mohanan02/Controller-Design-for-an-Autonomous-Vehicle-Hazard-Warning-and-Intent-Projection-System/PrototypeBoard/budgetlist.pdf

Manufacturer's Number | Description | Footprint | Supplier | Order Code | Qty | Price | MOQ | Status | Date Ordered | Line Total
1206 | SMT ADAPTERS 3 PACK 20SOIC/TSSOP | SMD to DIP | DigiKey | 1528-1066-ND | 1 | $8.34 | 1 | Received | | $8.34
13655 | SOIC TO DIP ADAPTER 8PIN 1=4 PCS | SMD to DIP | DigiKey | 1568-13655-ND | 2 | $6.95 | 1 | Received | | $13.90
FIT0193 | BREADBOARD GENERAL PURPOSE F | board | DigiKey | 1738-1005-ND | 5 | $5.84 | 1 | Received | | $29.20
SHUTTLE BOARD 3.0 BMI323 | SHUTTLE BOARD 3.0 BMI323 | module | DigiKey | 828-SHUTTLEBOARD3.0BMI323-ND | 1 | $29.43 | 1 | Received | | $29.43
2977 | DRV8825 STEPPER MTR DRVR CARR | module | DigiKey | 2183-2977-ND | 8 | $25.41 | 1 | Received | | $203.28
L6374FP | IC PWR DRIVER N-CHANNEL 1:1 20SO | SMD | DigiKey | 497-14769-5-ND | 2 | $18.33 | 1 | Received | | $36.66
ACPL-K64L-000E | OPTOISO 5KV 2CH PUSH PULL 8-SO | SMD | DigiKey | 516-2626-5-ND | 3 | $11.36 | 1 | Received | | $34.08
PHE840MA6100MA04R17 | CAP FILM 0.1UF 20% 760VDC RADIAL | through hole | DigiKey | 399-11469-ND | 15 | $0.92 | 1 | Received | | $13.80
B32529C0105J000 | CAP FILM 1UF 5% 63VDC RADIAL | through hole | DigiKey | 495-1119-ND | 7 | $1.07 | 1 | Received | | $7.49
R82DC3470SH60J | CAP FILM 0.47UF 5% 63VDC RADIAL | through hole | DigiKey | 399-11865-1-ND | 2 | $0.74 | 1 | Received | | $1.48
B32529C0473K000 | CAP FILM 0.047UF 10% 63VDC RAD | through hole | DigiKey | 495-2558-ND | 2 | $0.50 | 1 | Received | | $1.00
R82EC2100AA50J | CAP FILM 10000PF 5% 100VDC RAD | through hole | DigiKey | 399-5872-ND | 2 | $0.48 | 1 | Received | | $0.96
B32529C0102K000 | CAP FILM 1000PF 10% 63VDC RADIAL | through hole | DigiKey | 495-2456-ND | 2 | $0.50 | 1 | Received | | $1.00
MFR-25FRF52-1K | RES 1K OHM 1% 1/4W AXIAL | through hole | DigiKey | 13-MFR-25FRF52-1KTR-ND | 5 | $0.19 | 1 | Received | | $0.95
MFR-25FRF52-10K | 13-MFR-25FRF52-10KTR-ND | through hole | DigiKey | 13-MFR-25FRF52-10KTR-ND | 10 | $0.19 | 1 | Received | | $1.90
MFR-12FTF52-47K | RES 47K OHM 1% 1/6W AXIAL | through hole | DigiKey | 13-MFR-12FTF52-47KCT-ND | 6 | $0.19 | 1 | Received | | $1.14
C310T-SC-5-R-TR1 | FUSE CERAMIC 5A 250VAC AXIAL | through hole | DigiKey | 283-4691-2-ND | 10 | $0.57 | 1 | Received | | $5.70
TBP02R1W-381-03BE | TERM BLOCK HDR 3POS 3.81MM | through hole | DigiKey | 102-6514-ND | 5 | $1.22 | 1 | Received | | $6.10
TBP02P1W-381-03BE | TERM BLOCK PLUG 3POS 3.81MM | connector | DigiKey | 102-6505-ND | 5 | $1.80 | 1 | Received | | $9.00
25SH-B-04-TS | CONN HEADER VERT 4POS 2.5MM | connector | DigiKey | 2057-25SH-B-04-TS-ND | 8 | $0.19 | 1 | Received | | $1.52
25CH-B-04 | CONN RCPT HSG 4POS 2.50MM | connector | DigiKey | 2057-25CH-B-04-ND | 8 | $0.19 | 1 | Received | | $1.52
25CTB-R | CRIMP TERMINAL, 2.50MM TYPE B HC | connector | DigiKey | 2057-25CTB-RTR-ND | 32 | $0.19 | 1 | Received | | $6.08
530470610 | CONN HEADER VERT 6POS 1.25MM | connector | DigiKey | WM1735-ND | 9 | $0.70 | 1 | Received | | $6.30
B7P-VH-B | CONN HEADER VERT 7POS 3.96MM | connector | DigiKey | 455-B7P-VH-B-ND | 4 | $0.82 | 1 | Received | | $3.28
VHR-7N | CONN RCPT HSG 7POS 3.96MM | connector | DigiKey | 455-1181-ND | 4 | $0.41 | 1 | Received | | $1.64
SVH-41T-P1.1 | CONN SOCKET 16-20AWG CRIMP TIN | connector | DigiKey | 455-1319TR-ND | 18 | $0.09 | 1 | Received | | $1.62
ESDCAN03-2BWY | TVS DIODE 24VWM 41VC SOT3233 | SMD | DigiKey | 497-15846-2-ND | 4 | $0.95 | 1 | Received | | $3.80
TCAN3403DRQ1 | IC TRANSCEIVER HALF 1/1 8SOIC | SMD | DigiKey | 296-TCAN3403DRQ1TR-ND | 4 | $3.63 | 1 | Received | | $14.52
RNMF14FTC120R | RES 120 OHM 1% 1/4W AXIAL | through hole | DigiKey | S120CATR-ND | 5 | $0.19 | 1 | Received | | $0.95
DFR1015 | DC-DC MULTI-OUTPUT BUCK CONVERTER | buck converter | DigiKey | 1738-DFR1015-ND | 5 | $9.82 | 1 | Received | | $49.10
Total | | | | | | | | | | $495.74

## DigiKey Component Order List
