mohanan02/Controller-Design-for-an-Autonomous-Vehicle-Hazard-Warning-and-Intent-Projection-System/PrototypeBoard/20261010_202211.jpg

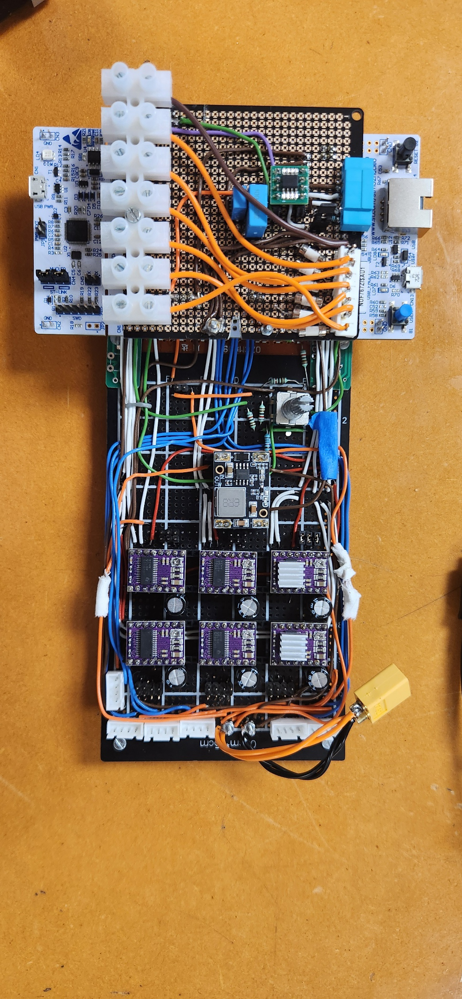
PrototypeBoard/20261010_202211.jpg
