mohanan02/Controller-Design-for-an-Autonomous-Vehicle-Hazard-Warning-and-Intent-Projection-System/PrototypeBoard/20261012_144138.jpg

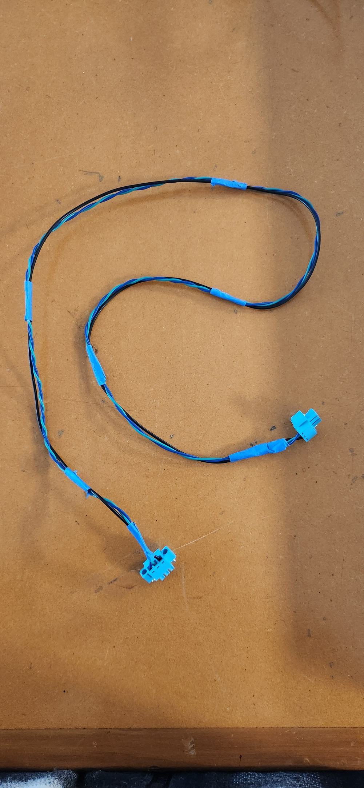
PrototypeBoard/20261012_144138.jpg
