mohanan02/Controller-Design-for-an-Autonomous-Vehicle-Hazard-Warning-and-Intent-Projection-System/PrototypeBoard/20261012_144315.jpg

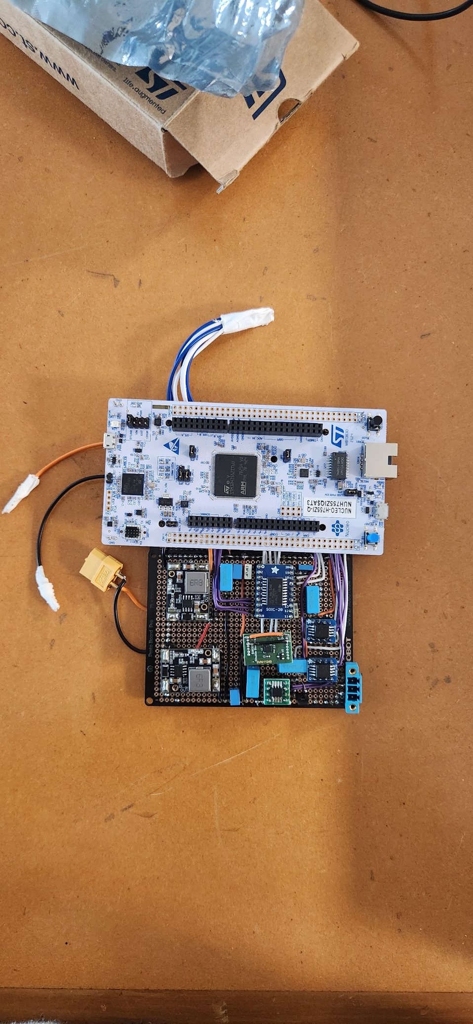
PrototypeBoard/20261012_144315.jpg
