mohanan02/Controller-Design-for-an-Autonomous-Vehicle-Hazard-Warning-and-Intent-Projection-System/SchematicPDF&ComponentList/MainController.pdf

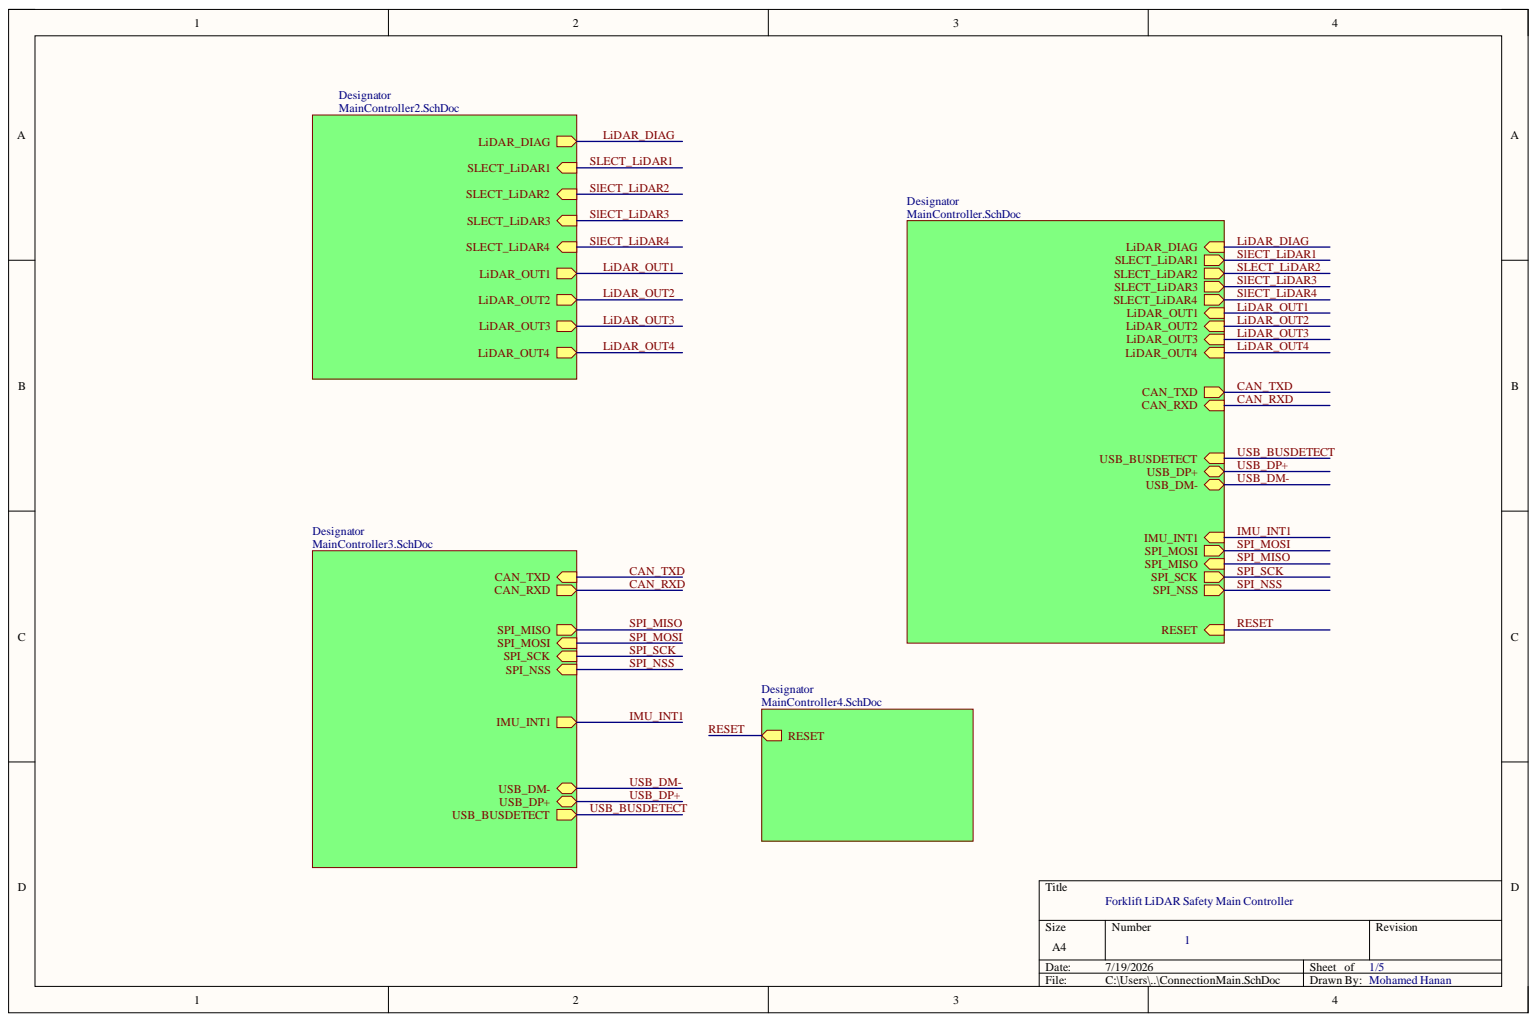
[picture p21: page 1]

Forklift LiDAR Safety Main Controller

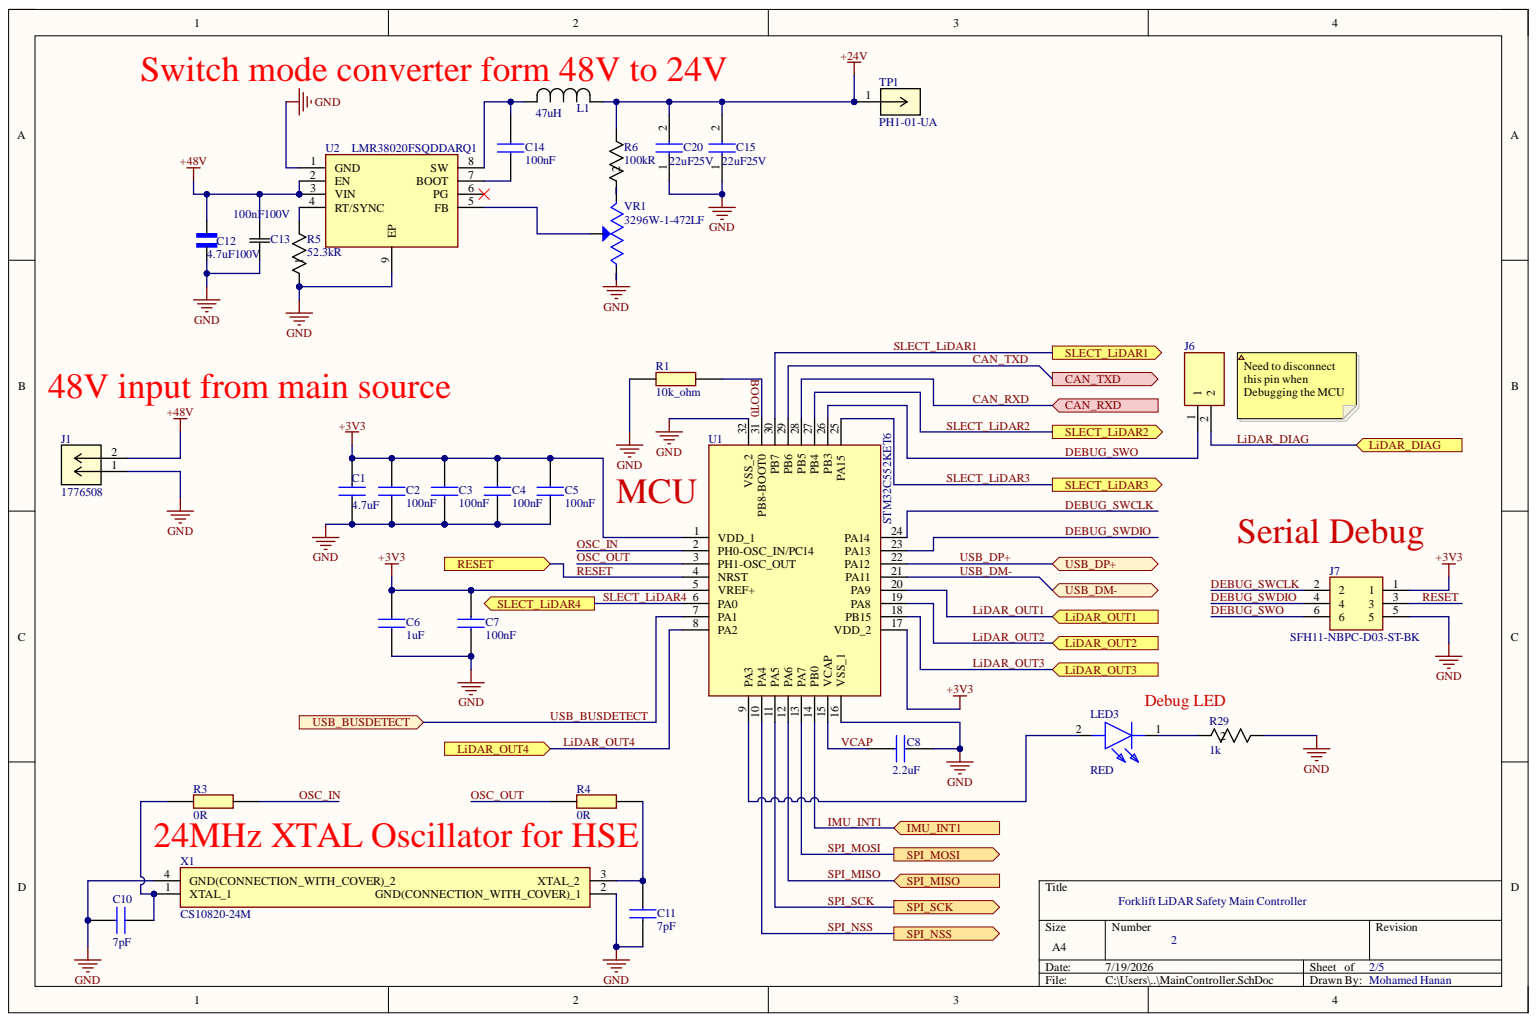
[picture p22: page 2]

Switch mode converter form 48V to 24V

48V input from main source

24MHz XTAL Oscillator for HSE

Forklift LiDAR Safety Main Controller

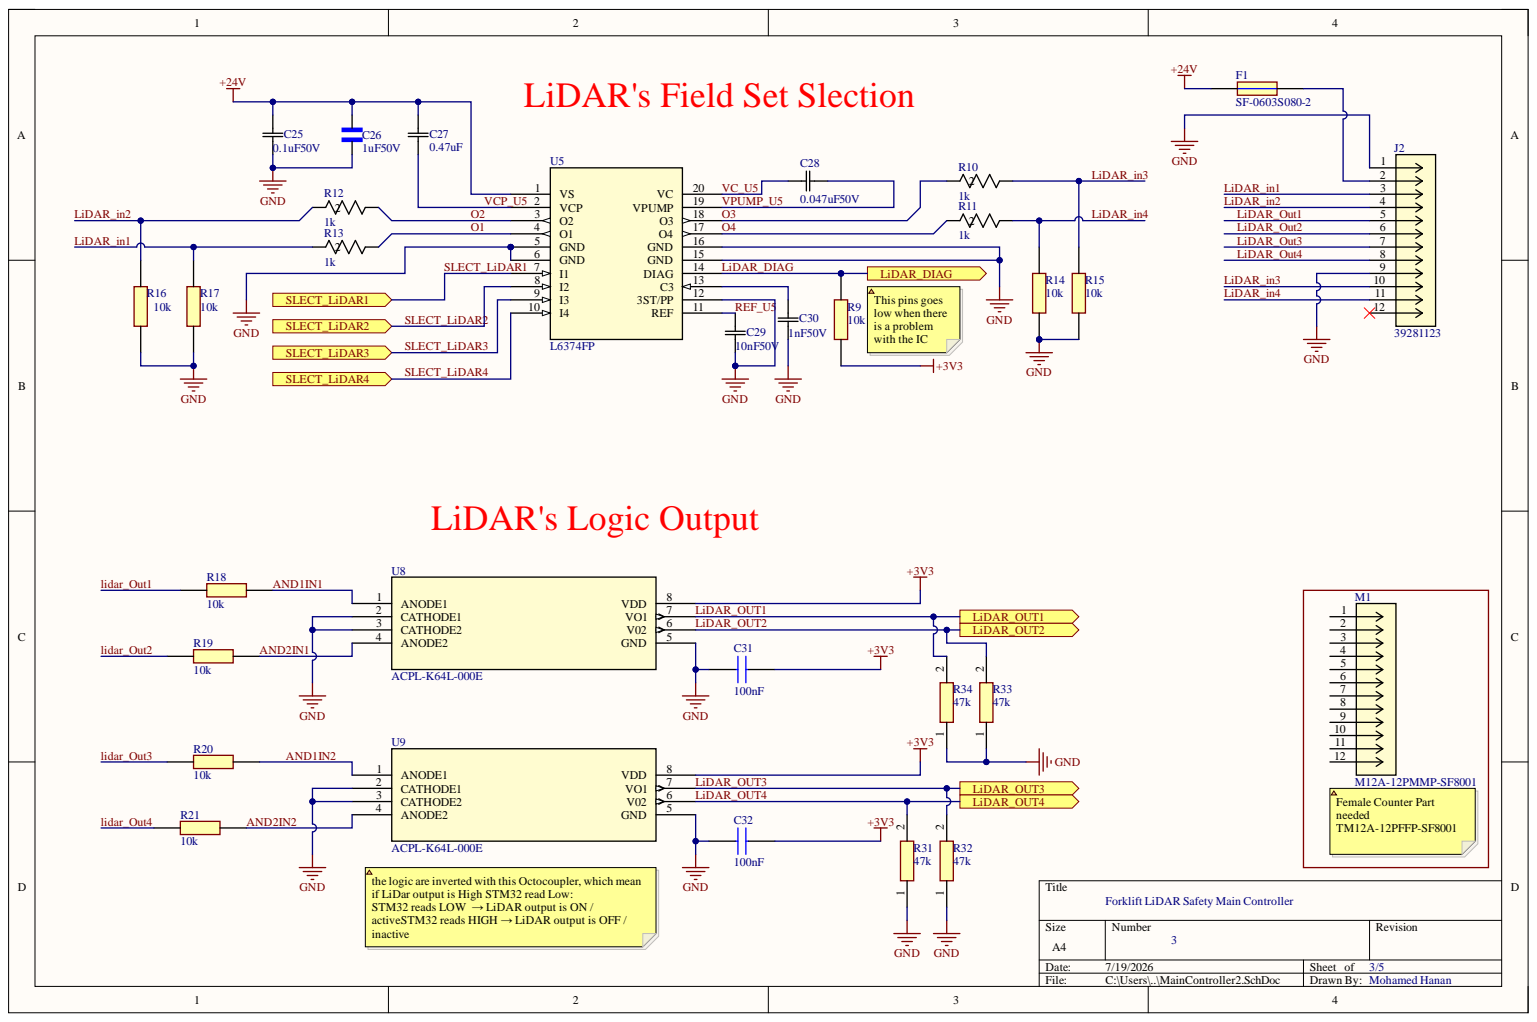
[picture p23: page 3]

LiDAR's Field Set Slection

2 1k SLECT_LiDAR1 | GND 6

I1 7 | | LiDAR_DIAG
I2 8
I3 9

REF_U5

SLECT_LiDAR2

CATHODE2 3

AND2IN1

AND2IN2

the logic are inverted with this Octocoupler, which mean
if LiDar output is High STM32 read Low:
STM32 reads LOW → LiDAR output is ON /
activeSTM32 reads HIGH → LiDAR output is OFF /
inactive

Forklift LiDAR Safety Main Controller

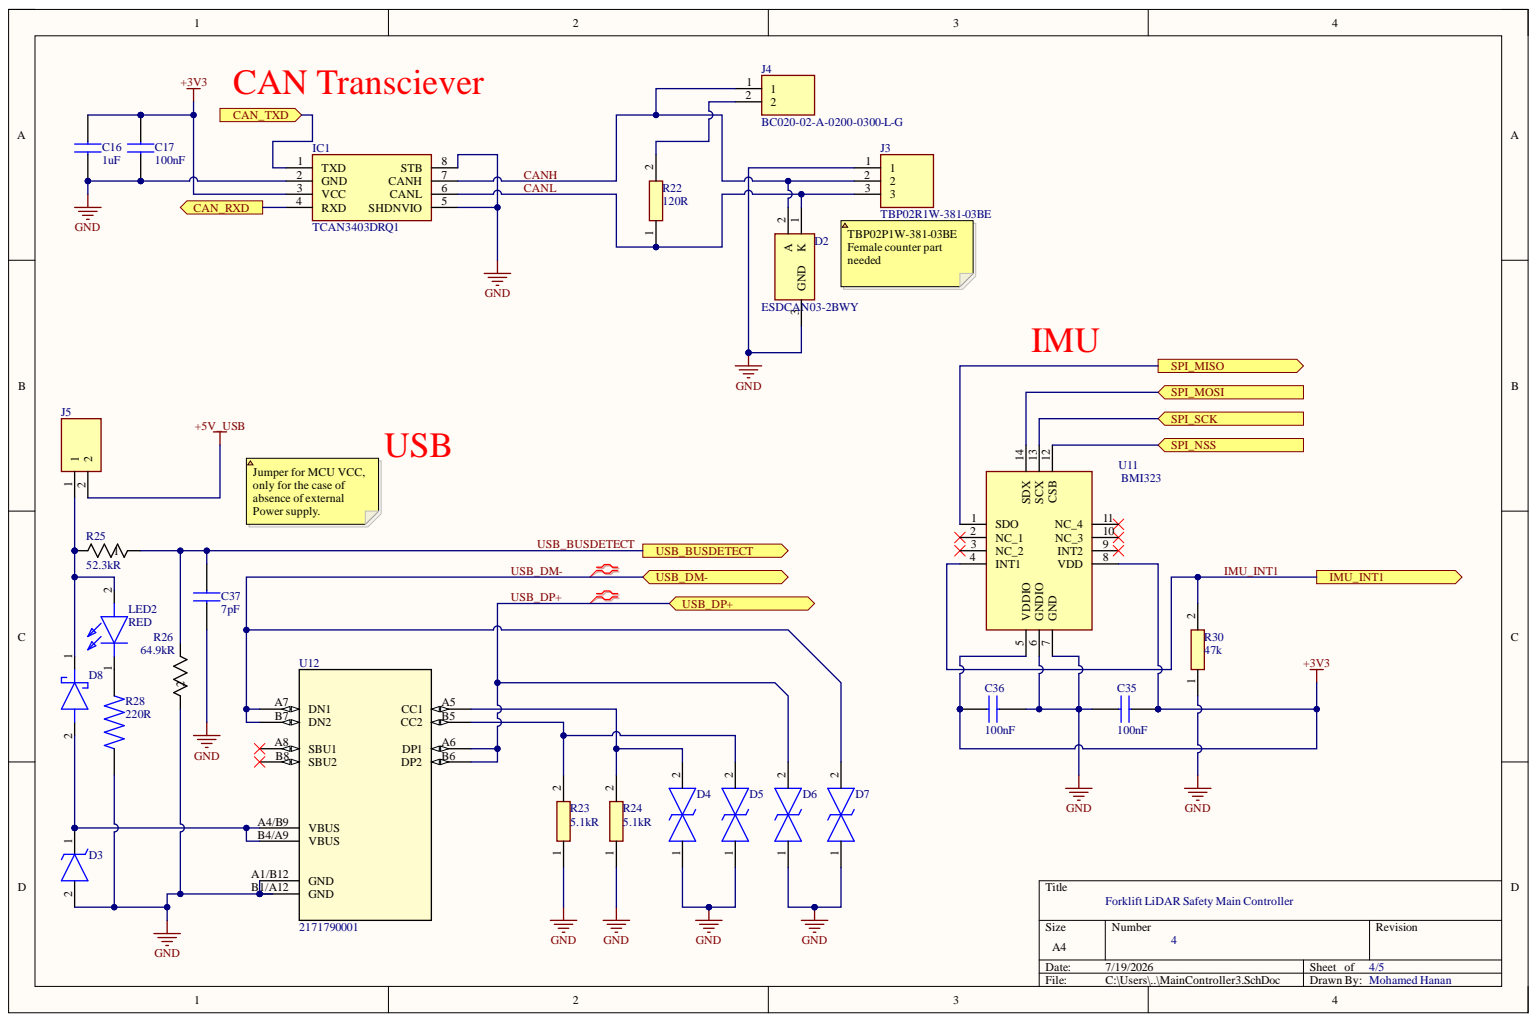
[picture p24: page 4]

Jumper for MCU VCC,
only for the case of
absence of external
Power supply.

Forklift LiDAR Safety Main Controller

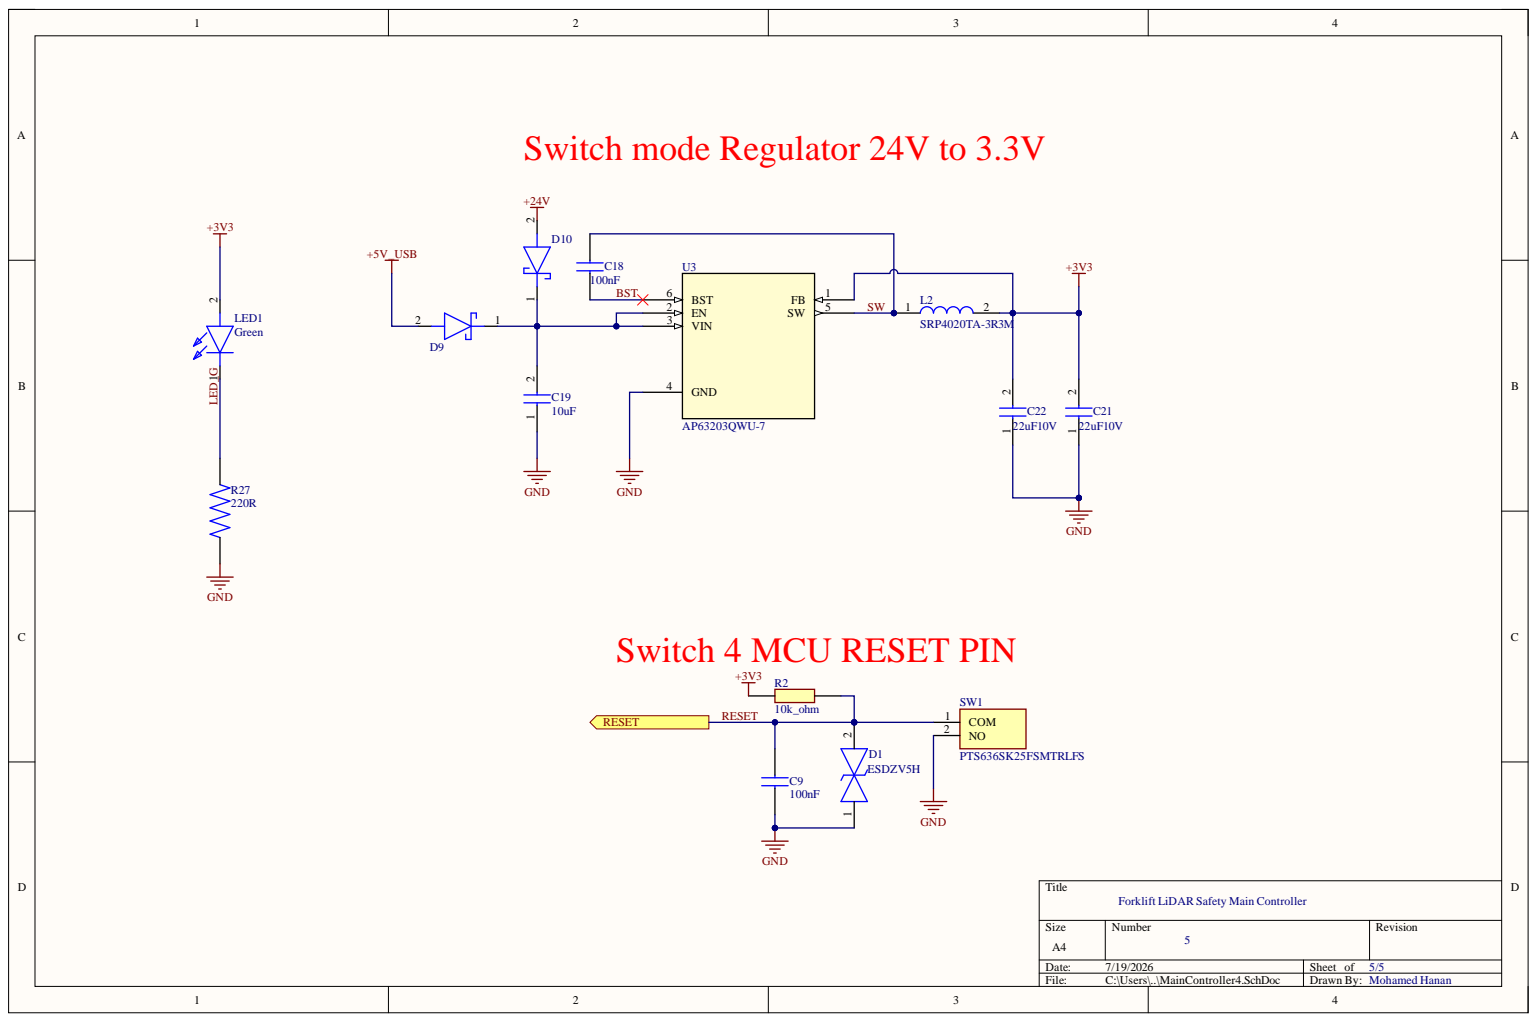
[picture p25: page 5]

Switch mode Regulator 24V to 3.3V

EN 2 | SW
VIN 3

Switch 4 MCU RESET PIN

Forklift LiDAR Safety Main Controller

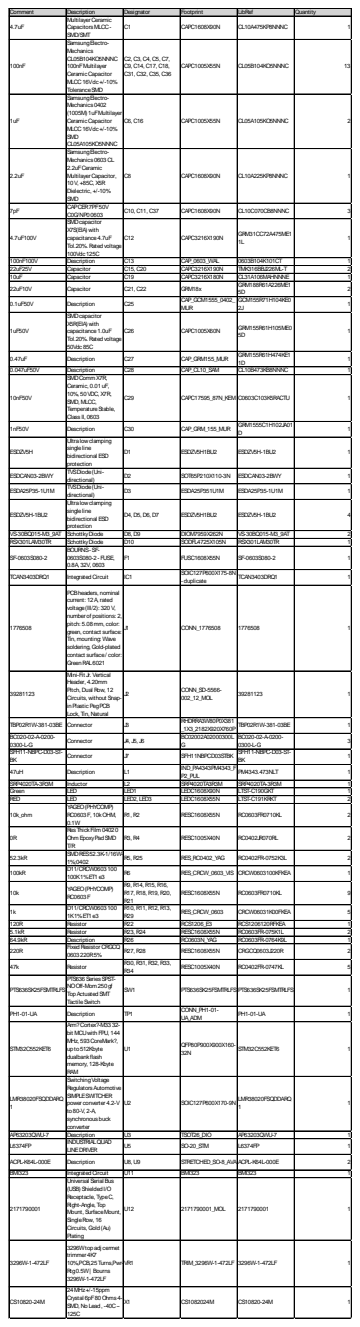
[picture p26: page 6]

100nF | SamsungElectro-Mechanics CL05B104KO5NNNC 100nFMultilayer Ceramic Capacitor MLCC16Vdc +/-10% ToleranceSMD | C2, C3, C4, C5, C7, C9, C14, C17, C18, C31, C32, C35, C36 | CAPC1005X55N | CL05B104KO5NNNC | 13

1uF | SamsungElectro-Mechanics0402 (1005M) 1uFMultilayer Ceramic Capacitor MLCC16Vdc +/-10% SMD CL05A105KO5NNNC | C6, C16 | CAPC1005X55N | CL05A105KO5NNNC | | 2

2.2uF | SamsungElectro-Mechanics0603CL 2.2uFCeramic Multilayer Capacitor, 10V, +85C, X5R Dielectric, +/-10% SMD | C8 | CAPC1608X90N | CL10A225KP8NNNC | | 1

7pF | CAPCER7PF50V C0G/NP00603 | C10, C11, C37 | CAPC1608X90N | CL10C070CB8NNNC | | 3

4.7uF100V | SMDcapacitor X7S(EIA) with capacitance4.7uF Tol.20%. Ratedvoltage 100Vdc 125C | C12 | CAPC3216X190N | GRM31CC72A475ME1 1L | | 1

100nF100V | Description | C13 | CAP_0603_WAL | 0603B104K101CT | | 1
22uF25V | Capacitor | C15, C20 | CAPC3216X190N | TMK316BBJ226ML-T | | 2
10uF | Capacitor | C19 | CAPC3216X180N | CL31A106MAHNNNE | | 1
22uF10V | Capacitor | C21, C22 | GRM18x | GRM188R61A226ME1 5D | | 2

0.1uF50V | Description | C25 | CAP_GCM1555_0402_ MUR | GCM155R71H104KE0 2J | | 1

1uF50V | SMDcapacitor X5R(EIA) with capacitance1.0uF Tol.20%. Ratedvoltage 50Vdc 85C | C26 | CAPC1005X60N | GRM155R61H105ME0 5D | | 1

0.47uF | Description | C27 | CAP_GRM155_MUR | GRM155R61H474KE1 1D | | 1

0.047uF50V | Description | C28 | CAP_CL10_SAM | CL10B473KB8NNNC | | 1
10nF50V | SMDCommX7R, Ceramic, 0.01uF, 10%, 50VDC, X7R, SMD, MLCC, TemperatureStable, ClassII, 0603 | C29 | CAPC17595_87N_KEM | C0603C103K5RACTU | | 1

1nF50V | Description | C30 | CAP_GRM_155_MUR | GRM1555C1H102JA01 D | | 1

ESDZV5H | Ultralowclamping singleline bidirectional ESD protection | D1 | ESDZV5H1BU2 | ESDZV5H-1BU2 | | 1

ESDCAN03-2BWY | TVSDiode(Uni-directional) | D2 | SOT65P210X110-3N | ESDCAN03-2BWY | | 1

ESDA25P35-1U1M | TVSDiode(Uni-directional) | D3 | ESDA25P351U1M | ESDA25P35-1U1M | | 1

ESDZV5H-1BU2 | Ultralowclamping singleline bidirectional ESD protection | D4, D5, D6, D7 | ESDZV5H1BU2 | ESDZV5H-1BU2 | | 4

VS-30BQ015-M3_9AT | SchottkyDiode | D8, D9 | DIOM7959X262N | VS-30BQ015-M3_9AT | | 2
RSX301LAM30TR | SchottkyDiode | D10 | SODFL4725X105N | RSX301LAM30TR | | 1
SF-0603S080-2 | BOURNS-SF-0603S080-2-FUSE, 0.8A, 32V, 0603 | F1 | FUSC1608X55N | SF-0603S080-2 | | 1

TCAN3403DRQ1 | IntegratedCircuit | IC1 | SOIC127P600X175-8N - duplicate | TCAN3403DRQ1 | | 1

1776508 | PCBheaders, nominal current: 12A, rated voltage(III/2): 320V, number of positions: 2, pitch: 5.08mm, color: green, contact surface: Tin, mounting: Wave soldering, Gold-plated contact surface/ color: GreenRAL6021 | J1 | CONN_1776508 | 1776508 | | 1

39281123 | Mini-Fit Jr. Vertical Header, 4.20mm Pitch, Dual Row, 12 Circuits, without Snap-inPlasticPegPCB Lock, Tin, Natural | J2 | CONN_SD-5566-002_12_MOL | 39281123 | | 1

TBP02R1W-381-03BE | Connector | J3 | RHDRRA3W80P0X381 _1X3_2182X920X760P | TBP02R1W-381-03BE | | 1

BC020-02-A-0200-0300-L-G | Connector | J4, J5, J6 | BC02002A02000300L G | BC020-02-A-0200-0300-L-G | | 3

SFH11-NBPC-D03-ST-BK | Connector | J7 | SFH11NBPCD03STBK | SFH11-NBPC-D03-ST-BK | | 1

47uH | Description | L1 | IND_PA4343PM4343_F P2_PUL | PM4343.473NLT | | 1

SRP4020TA-3R3M | Inductor | L2 | SRP4020TA3R3M | SRP4020TA-3R3M | | 1
Green | LED | LED1 | LEDC1608X90N | LTST-C190GKT | | 1
RED | LED | LED2, LED3 | LEDC1608X55N | LTST-C191KRKT | | 2
10k_ohm | YAGEO(PHYCOMP) RC0603F, 10kOHM, 0.1W | R1, R2 | RESC1608X55N | RC0603FR0710KL | | 2

0R | ResThickFilm04020 OhmEpoxyPadSMD T/R | R3, R4 | RESC1005X40N | RC0402JR070RL | | 2

52.3kR | SMDRES52.3K-1/16W-1%;0402 | R5, R25 | RES_RC0402_YAG | RC0402FR-0752K3L | | 2

100kR | D11/CRCW0603100 100K1%ET1e3 | R6 | RES_CRCW_0603_VIS | CRCW0603100KFKEA | | 1

10k | YAGEO(PHYCOMP) RC0603F | R9, R14, R15, R16, R17, R18, R19, R20, R21 | RESC1608X55N | RC0603FR0710KL | | 9

1k | D11/CRCW0603100 1K1%ET1e3 | R10, R11, R12, R13, R29 | RES_CRCW_0603 | CRCW06031K00FKEA | | 5

120R | Resistor | R22 | RCS1206_E3 | RCS1206120RFKEA | | 1
5.1kR | Resistor | R23, R24 | RESC1608X55N | RC0603FR-075K1L | | 2
64.9kR | Description | R26 | RC0603N_YAG | RC0603FR-0764K9L | | 1
220R | FixedResistor CRGCQ 0603220R5% | R27, R28 | RESC1608X55N | CRGCQ0603J220R | | 2

47k | Resistor | R30, R31, R32, R33, R34 | RESC1005X40N | RC0402FR-0747KL | | 5

PTS636SK25FSMTRLFS | PTS636SeriesSPST-NOOff-Mom250gf TopActuatedSMT TactileSwitch | SW1 | PTS636SK25FSMTRLFS | | | 1

PH1-01-UA | Description | TP1 | CONN_PH1-01-UA_ADM | PH1-01-UA | | 1

STM32C552KET6 | Arm?Cortex?-M3332-bit MCUwithFPU, 144 MHz, 593CoreMark?, upto512Kbyte dualbankflash memory, 128-Kbyte RAM | U1 | QFP80P900X900X160-32N | STM32C552KET6 | | 1

LMR38020FSQDDARQ 1 | SwitchingVoltage RegulatorsAutomotive SIMPLESWITCHER power converter 4.2-V to80-V, 2-A, synchronousbuck converter | U2 | SOIC127P600X170-9N | LMR38020FSQDDARQ 1 | | 1

AP63203QWU-7 | Description | U3 | TSOT26_DIO | AP63203QWU-7 | | 1
L6374FP | INDUSTRIALQUAD LINEDRIVER | U5 | SO-20_STM | L6374FP | | 1

ACPL-K64L-000E | Description | U8, U9 | STRETCHED_SO-8_AVA ACPL-K64L-000E | | | 2

BMI323 | IntegratedCircuit | U11 | BMI323 | BMI323 | | 1
2171790001 | Universal Serial Bus (USB)ShieldedI/O Receptacle, TypeC, Right-Angle, Top Mount, SurfaceMount, SingleRow, 16 Circuits, Gold(Au) Plating | U12 | 2171790001_MOL | 2171790001 | | 1

3296W-1-472LF | 3296Wtopadj cermet trimmer 4K7 10%,PCB,25Turns,Pwr-Rtg0.5W| Bourns 3296W-1-472LF | VR1 | TRIM_3296W-1-472LF | 3296W-1-472LF | | 1

CS10820-24M | 24MHz+/-15ppm Crystal 6pF80Ohms4-SMD, NoLead, -40C~ 125C | X1 | CS1082024M | CS10820-24M | | 1
