mohanan02/Controller-Design-for-an-Autonomous-Vehicle-Hazard-Warning-and-Intent-Projection-System/SchematicPDF&ComponentList/STPMotorControl_1.pdf

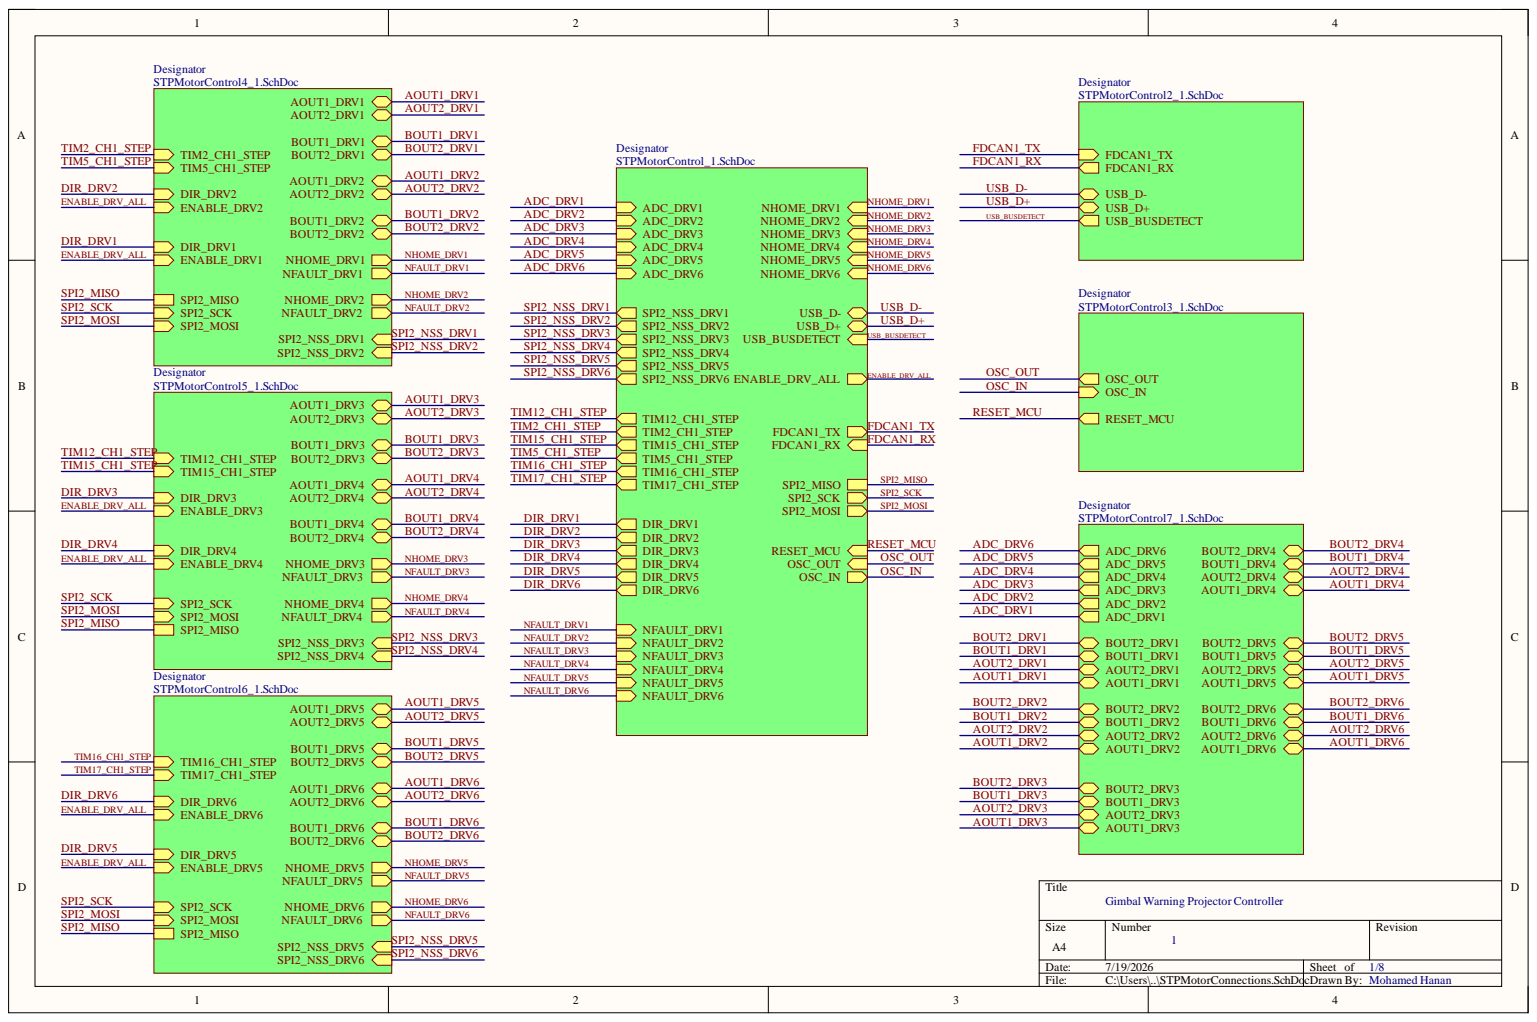
[picture p27: page 1]

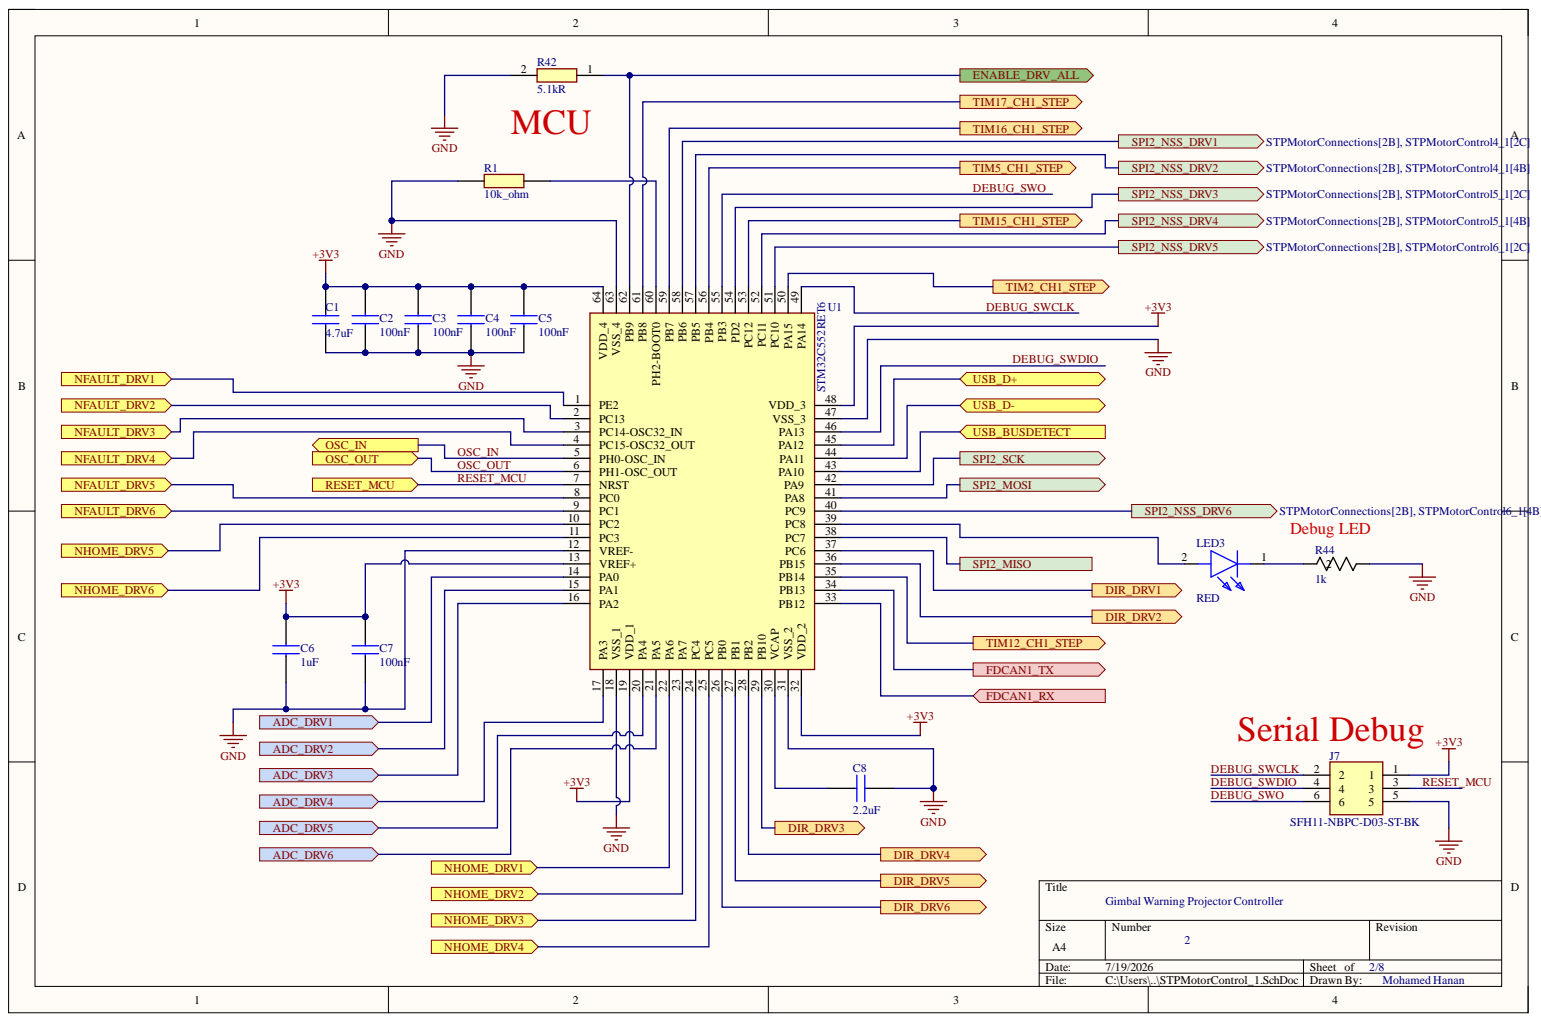
[picture p28: page 2]

TIM5_CH1_STEP DEBUG_SWO

TIM15_CH1_STEP

U1 DEBUG_SWCLK

PC14-OSC32_IN 3

OSC_IN | PH0-OSC_IN 5
OSC_OUT | PH1-OSC_OUT 6

PC2 10
PC3 11
VREF- 12
VREF+ 13
PA0 14
PA1 15
PA2 16

Gimbal Warning Projector Controller

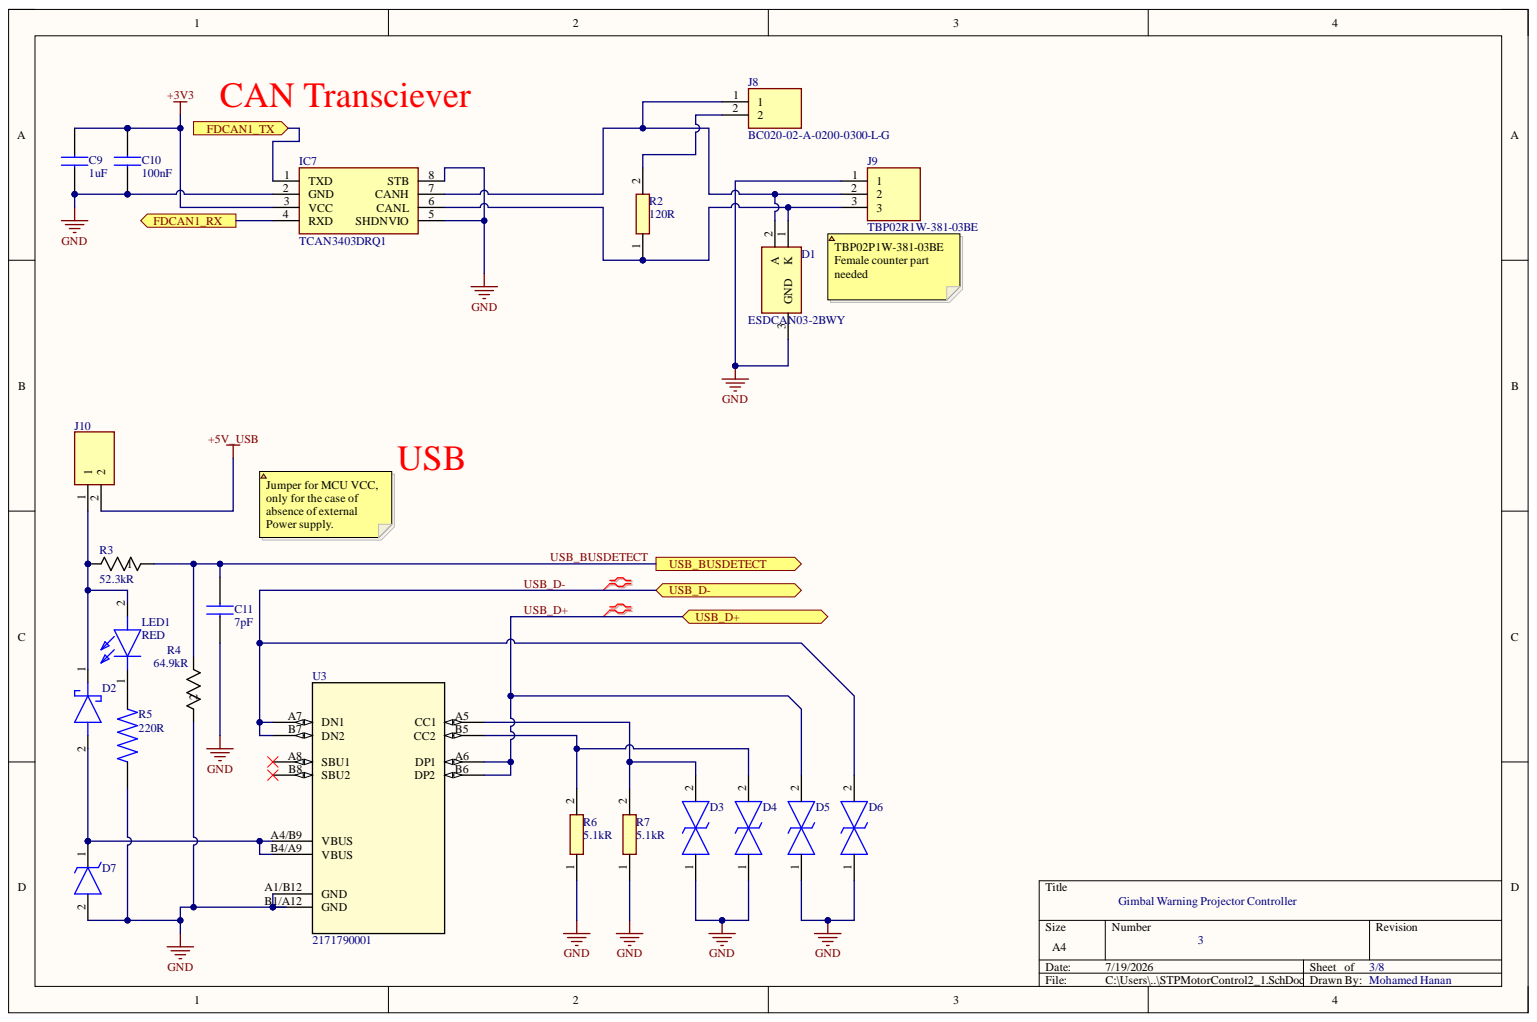
[picture p29: page 3]

Jumper for MCU VCC,
only for the case of
absence of external
Power supply.

Gimbal Warning Projector Controller


Switch mode converter form 48V to 5V

Switch mode Regulator 24V to 3.3V

48V input from main source

Switch 4 MCU RESET PIN

24MHz XTAL Oscillator for HSE

Gimbal Warning Projector Controller

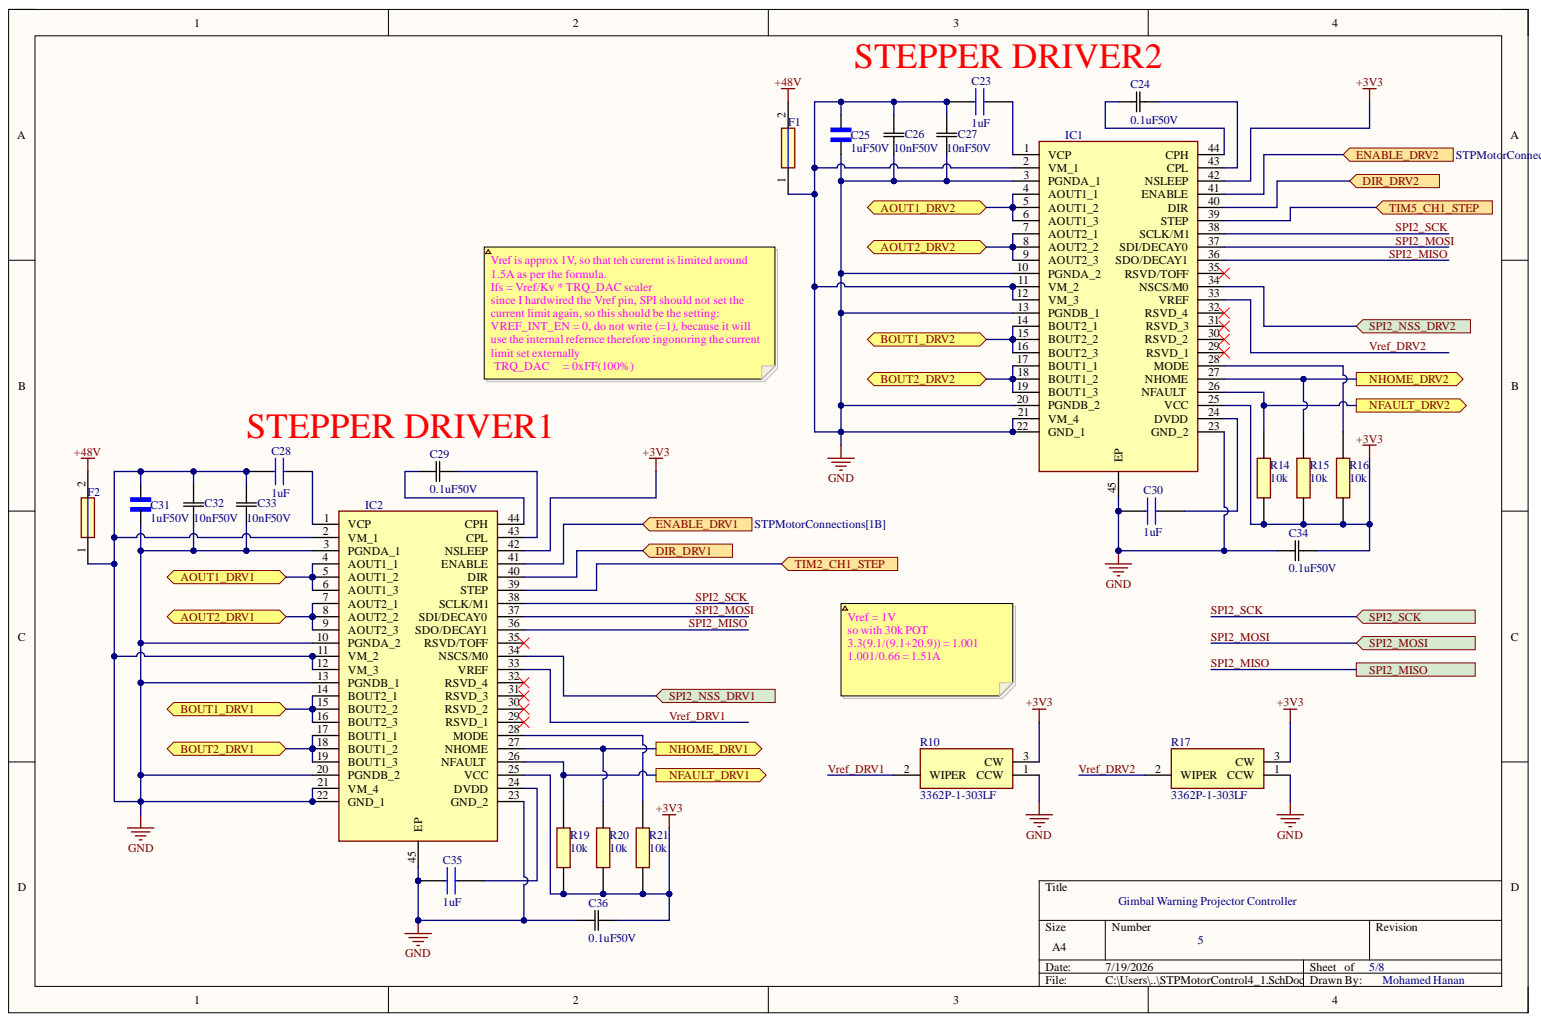
[picture p30: page 5]

VCP 1

Vref is approx 1V, so that teh curernt is limited around
1.5A as per the formula.
Ifs = Vref/Kv * TRQ_DAC scaler
since I hardwired the Vref pin, SPI should not set the
current limit again, so this should be the setting:
VREF_INT_EN = 0, do not write (=1), because it will
use the internal refernce therefore ingonoring the current
limit set externally

Gimbal Warning Projector Controller

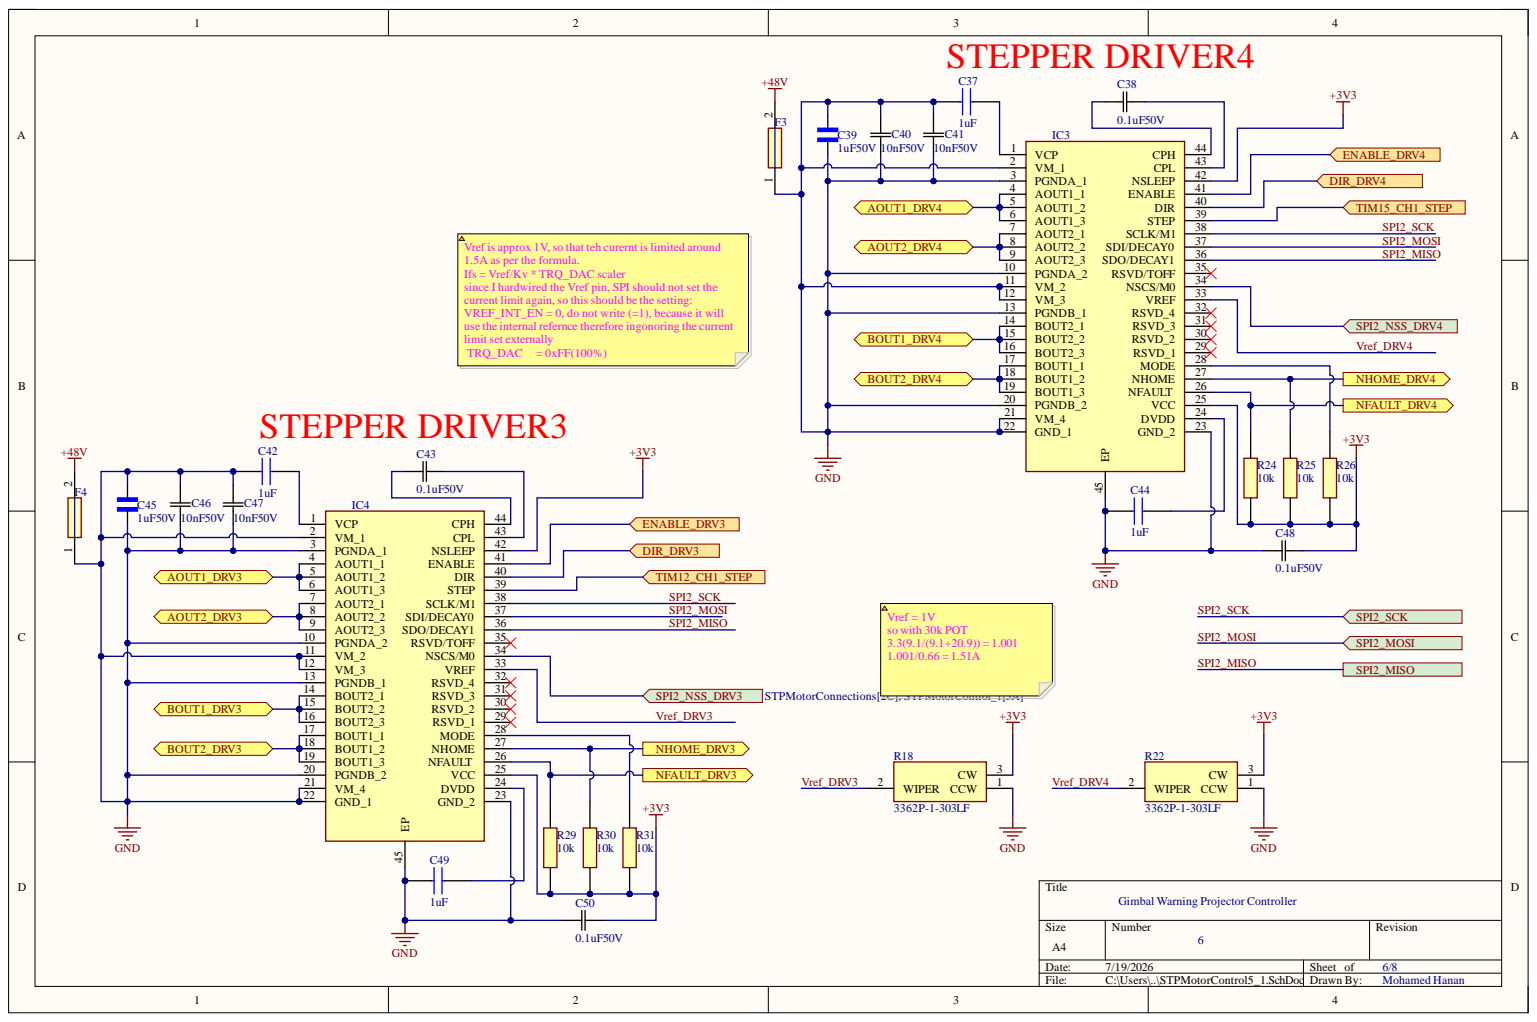
[picture p31: page 6]

VCP 1

Vref is approx 1V, so that teh curernt is limited around
1.5A as per the formula.
Ifs = Vref/Kv * TRQ_DAC scaler
since I hardwired the Vref pin, SPI should not set the
current limit again, so this should be the setting:
VREF_INT_EN = 0, do not write (=1), because it will
use the internal refernce therefore ingonoring the current
limit set externally

Gimbal Warning Projector Controller

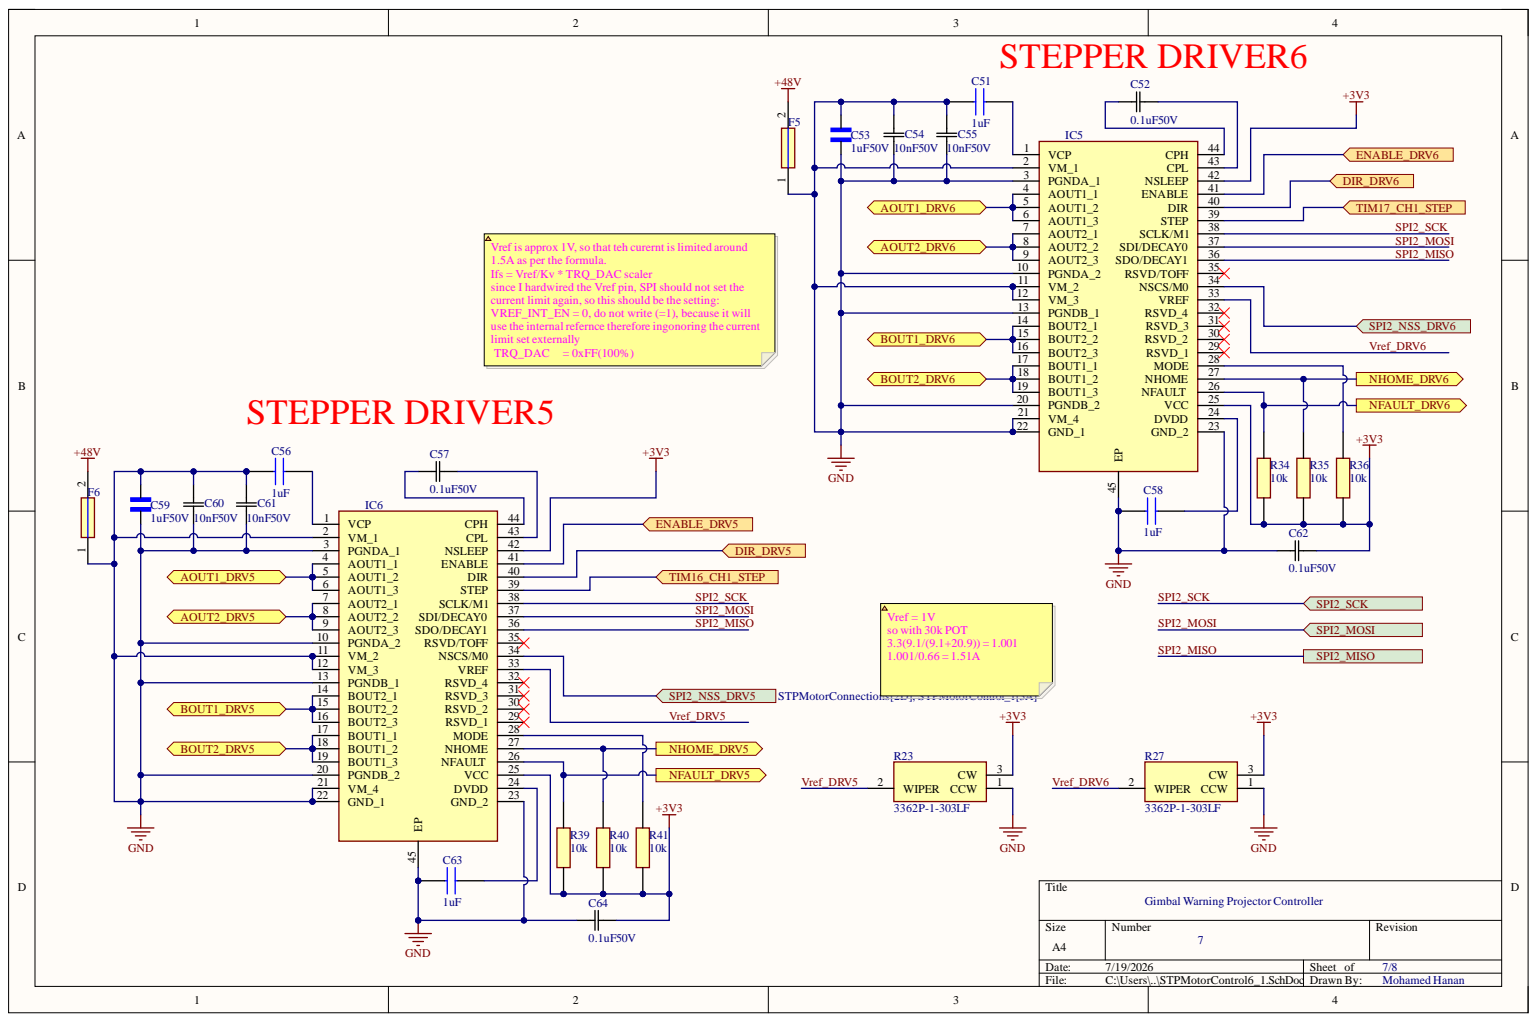
[picture p32: page 7]

VCP 1

Vref is approx 1V, so that teh curernt is limited around
1.5A as per the formula.
Ifs = Vref/Kv * TRQ_DAC scaler
since I hardwired the Vref pin, SPI should not set the
current limit again, so this should be the setting:
VREF_INT_EN = 0, do not write (=1), because it will
use the internal refernce therefore ingonoring the current
limit set externally

Gimbal Warning Projector Controller

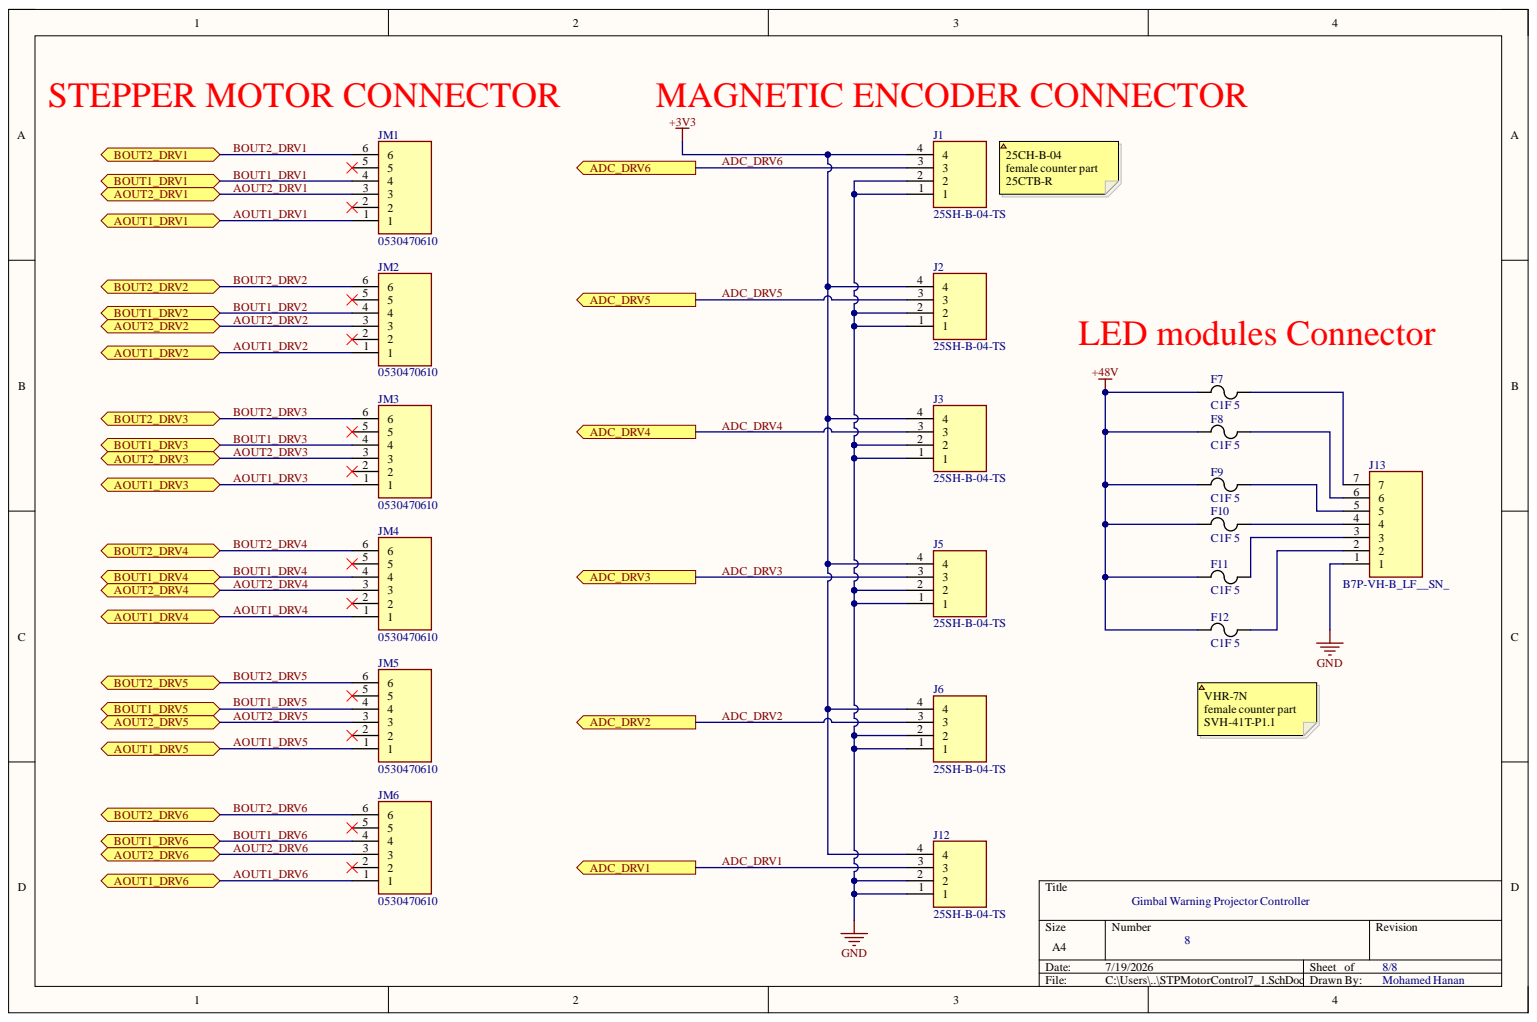
[picture p33: page 8]

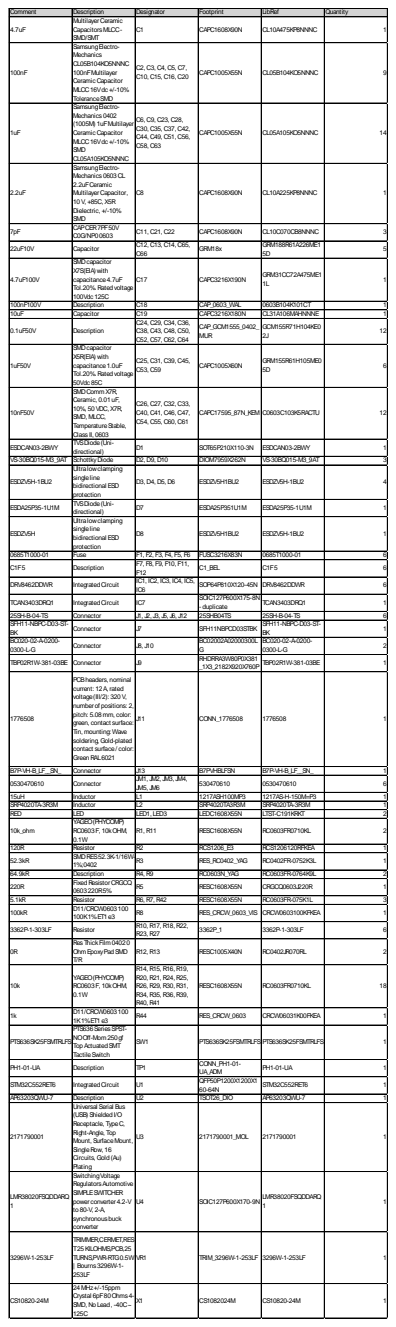
[picture p34: page 9]

100nF | SamsungElectro-Mechanics CL05B104KO5NNNC 100nFMultilayer Ceramic Capacitor MLCC16Vdc +/-10% ToleranceSMD | C2, C3, C4, C5, C7, C10, C15, C16, C20 | CAPC1005X55N | CL05B104KO5NNNC | | 9

1uF | SamsungElectro-Mechanics0402 (1005M) 1uFMultilayer Ceramic Capacitor MLCC16Vdc +/-10% SMD CL05A105KO5NNNC | C6, C9, C23, C28, C30, C35, C37, C42, C44, C49, C51, C56, C58, C63 | CAPC1005X55N | CL05A105KO5NNNC | 14

2.2uF | SamsungElectro-Mechanics0603CL 2.2uFCeramic Multilayer Capacitor, 10V, +85C, X5R Dielectric, +/-10% SMD | C8 | CAPC1608X90N | CL10A225KP8NNNC | | 1

7pF | CAPCER7PF50V C0G/NP00603 | C11, C21, C22 | CAPC1608X90N | CL10C070CB8NNNC | | 3

22uF10V | Capacitor | C12, C13, C14, C65, C66 | GRM18x | GRM188R61A226ME1 5D | | 5

4.7uF100V | SMDcapacitor X7S(EIA) with capacitance4.7uF Tol.20%. Ratedvoltage 100Vdc 125C | C17 | CAPC3216X190N | GRM31CC72A475ME1 1L | | 1

100nF100V | Description | C18 | CAP_0603_WAL | 0603B104K101CT | | 1
10uF | Capacitor | C19 | CAPC3216X180N | CL31A106MAHNNNE | | 1
0.1uF50V | Description | C24, C29, C34, C36, C38, C43, C48, C50, C52, C57, C62, C64 | CAP_GCM1555_0402_ MUR | GCM155R71H104KE0 2J | 12

1uF50V | SMDcapacitor X5R(EIA) with capacitance1.0uF Tol.20%. Ratedvoltage 50Vdc 85C | C25, C31, C39, C45, C53, C59 | CAPC1005X60N | GRM155R61H105ME0 5D | | 6

10nF50V | SMDCommX7R, Ceramic, 0.01uF, 10%, 50VDC, X7R, SMD, MLCC, TemperatureStable, ClassII, 0603 | C26, C27, C32, C33, C40, C41, C46, C47, C54, C55, C60, C61 | CAPC17595_87N_KEM | C0603C103K5RACTU | 12

ESDCAN03-2BWY | TVSDiode(Uni-directional) | D1 | SOT65P210X110-3N | ESDCAN03-2BWY | | 1

VS-30BQ015-M3_9AT | SchottkyDiode | D2, D9, D10 | DIOM7959X262N | VS-30BQ015-M3_9AT | | 3
ESDZV5H-1BU2 | Ultralowclamping singleline bidirectional ESD protection | D3, D4, D5, D6 | ESDZV5H1BU2 | ESDZV5H-1BU2 | | 4

ESDA25P35-1U1M | TVSDiode(Uni-directional) | D7 | ESDA25P351U1M | ESDA25P35-1U1M | | 1

ESDZV5H | Ultralowclamping singleline bidirectional ESD protection | D8 | ESDZV5H1BU2 | ESDZV5H-1BU2 | | 1

0685T1000-01 | Fuse | F1, F2, F3, F4, F5, F6 | FUSC3216X83N | 0685T1000-01 | | 6
C1F5 | Description | F7, F8, F9, F10, F11, F12 | C1_BEL | C1F5 | | 6

DRV8462DDWR | IntegratedCircuit | IC1, IC2, IC3, IC4, IC5, IC6 | SOP64P810X120-45N | DRV8462DDWR | | 6

TCAN3403DRQ1 | IntegratedCircuit | IC7 | SOIC127P600X175-8N - duplicate | TCAN3403DRQ1 | | 1

25SH-B-04-TS | Connector | J1, J2, J3, J5, J6, J12 | 25SHB04TS | 25SH-B-04-TS | | 6
SFH11-NBPC-D03-ST-BK | Connector | J7 | SFH11NBPCD03STBK | SFH11-NBPC-D03-ST-BK | | 1

BC020-02-A-0200-0300-L-G | Connector | J8, J10 | BC02002A02000300L G | BC020-02-A-0200-0300-L-G | | 2

TBP02R1W-381-03BE | Connector | J9 | RHDRRA3W80P0X381 _1X3_2182X920X760P | TBP02R1W-381-03BE | | 1

1776508 | PCBheaders, nominal current: 12A, rated voltage(III/2): 320V, number of positions: 2, pitch: 5.08mm, color: green, contact surface: Tin, mounting: Wave soldering, Gold-plated contact surface/ color: GreenRAL6021 | J11 | CONN_1776508 | 1776508 | | 1

B7P-VH-B_LF__SN_ | Connector | J13 | B7PVHBLFSN | B7P-VH-B_LF__SN_ | | 1
0530470610 | Connector | JM1, JM2, JM3, JM4, JM5, JM6 | 530470610 | 0530470610 | | 6

15uH | Inductor | L1 | 1217ASH100MP3 | 1217AS-H-150M=P3 | | 1
SRP4020TA-3R3M | Inductor | L2 | SRP4020TA3R3M | SRP4020TA-3R3M | | 1
RED | LED | LED1, LED3 | LEDC1608X55N | LTST-C191KRKT | | 2
10k_ohm | YAGEO(PHYCOMP) RC0603F, 10kOHM, 0.1W | R1, R11 | RESC1608X55N | RC0603FR0710KL | | 2

120R | Resistor | R2 | RCS1206_E3 | RCS1206120RFKEA | | 1
52.3kR | SMDRES52.3K-1/16W-1%;0402 | R3 | RES_RC0402_YAG | RC0402FR-0752K3L | | 1

64.9kR | Description | R4, R9 | RC0603N_YAG | RC0603FR-0764K9L | | 2
220R | FixedResistor CRGCQ 0603220R5% | R5 | RESC1608X55N | CRGCQ0603J220R | | 1

5.1kR | Resistor | R6, R7, R42 | RESC1608X55N | RC0603FR-075K1L | | 3
100kR | D11/CRCW0603100 100K1%ET1e3 | R8 | RES_CRCW_0603_VIS | CRCW0603100KFKEA | | 1

3362P-1-303LF | Resistor | R10, R17, R18, R22, R23, R27 | 3362P_1 | 3362P-1-303LF | | 6

0R | ResThickFilm04020 OhmEpoxyPadSMD T/R | R12, R13 | RESC1005X40N | RC0402JR070RL | | 2

10k | YAGEO(PHYCOMP) RC0603F, 10kOHM, 0.1W | R14, R15, R16, R19, R20, R21, R24, R25, R26, R29, R30, R31, R34, R35, R36, R39, R40, R41 | RESC1608X55N | RC0603FR0710KL | 18

1k | D11/CRCW0603100 1K1%ET1e3 | R44 | RES_CRCW_0603 | CRCW06031K00FKEA | | 1

PTS636SK25FSMTRLFS | PTS636SeriesSPST-NOOff-Mom250gf TopActuatedSMT TactileSwitch | SW1 | PTS636SK25FSMTRLFS | | | 1

PH1-01-UA | Description | TP1 | CONN_PH1-01-UA_ADM | PH1-01-UA | | 1

STM32C552RET6 | IntegratedCircuit | U1 | QFP50P1200X1200X1 60-64N | STM32C552RET6 | | 1

AP63203QWU-7 | Description | U2 | TSOT26_DIO | AP63203QWU-7 | | 1
2171790001 | Universal Serial Bus (USB)ShieldedI/O Receptacle, TypeC, Right-Angle, Top Mount, SurfaceMount, SingleRow, 16 Circuits, Gold(Au) Plating | U3 | 2171790001_MOL | 2171790001 | | 1

LMR38020FSQDDARQ 1 | SwitchingVoltage RegulatorsAutomotive SIMPLESWITCHER power converter 4.2-V to80-V, 2-A, synchronousbuck converter | U4 | SOIC127P600X170-9N | LMR38020FSQDDARQ 1 | | 1

3296W-1-253LF | TRIMMER,CERMET,RES T25KILOHMS,PCB,25 TURNS,PWR-RTG0.5W | Bourns3296W-1-253LF | VR1 | TRIM_3296W-1-253LF | 3296W-1-253LF | | 1

CS10820-24M | 24MHz+/-15ppm Crystal 6pF80Ohms4-SMD, NoLead, -40C~ 125C | X1 | CS1082024M | CS10820-24M | | 1
