mohanan02/Controller-Design-for-an-Autonomous-Vehicle-Hazard-Warning-and-Intent-Projection-System/Combined_Unique_Component_List.xlsx

Sheet: Unique Components
Combined Unique Component List — Main, STP Motor and Gimbal Controllers
Each row is one specific component, matched primarily by normalized manufacturer/library part number. Quantities are combined across all three controller BOMs.
Category | Value / Comment | Part Number / LibRef | Footprint | Main Designator(s) | STP Designator(s) | Gimbal Designator(s)
Capacitor | 10 nF | 10 nF, 50 V | CL21B103KBANNNC | 805 | C29 | C28, C29, C34, C35, C42, C43, C48, C49, C56, C57, C62, C63; C? | C34, C35
Capacitor | 1 µF | C0805C105K3RACTU | 805 | C6, C16 | C6, C9, C25, C30, C32, C37, C39, C44, C46, C51, C53, C58, C60, C65 | C6, C9, C30, C37
Capacitor | 100 nF | CL21B104KBCNNNC | 805 | C2, C3, C4, C5, C7, C9, C17, C18, C31, C32, C35, C36 | C2, C3, C4, C5, C7, C10, C22 | C2, C3, C4, C5, C7, C10, C18, C22
Capacitor | 2.2 µF | GRM21BR71A225KA01L | 805 | C8 | C8 | C8
Capacitor | 4.7 µF | CL31B475KOHNFNE | 1206 | C1 | C1 | C1
Capacitor | 0.047 µF | 1206B473K500CT | 1206 | C28
Capacitor | 7 pF | CC0805DRNPO9BN7R0 | 805 | C10, C11, C37 | C23, C24 | C23, C24
Capacitor | 10 µF | CL31A106KAHNNNF | 1206 | C19, C? (5 unannotated) | C? | C19, C?
Capacitor | 220 pF | VJ1206A221JXAMT | 1206 |  | C?
Capacitor | 8.2 nF | CC1206KRX7R9BB822 | 1206 | C? |  | C?
Capacitor | 0.1 µF, 50 V | C1206C104K5RACTU | 1206 | C25, C? (1 unannotated) | C26, C31, C36, C38, C40, C45, C50, C52, C54, C59, C64, C66, C? | C31, C38, C?
Capacitor | 100 pF | C0805C101K5GAC7210 | 805 | C? |  | C?
Capacitor | 1 nF | CC0805MRX7R0BB102 | 805 | C30
Capacitor | 1 µF, 50 V | CL21F105ZBFNNNG | 805 | C26 | C27, C33, C41, C47, C55, C61 | C33
Capacitor | 0.47 µF | 0805B474K500CT | 805 | C27
Capacitor | 22 µF, 10 V | CL31A226MOCLNNC | 1206 | C21, C22 |  | C20, C21
Capacitor | 2.2 µF, 100 V | GRM21BD72A225ME01K | 805 | C? ×4 | C? ×4 | C? ×4
Capacitor | 47 µF | GRM32EC81C476KE15K | 1206 |  | C? ×3 | C? ×3
Resistor | 1 kΩ | RC1206FR-071KL | 1206 | R10, R11, R12, R13, R29 | R3 | R3
Resistor | 220 Ω | ESR10EZPF2200 | 805 | R27, R28
Resistor | 31.6 kΩ | CRCW080531K6FKEA | 805 |  | R?
Resistor | 249 kΩ | RC1206FR-07249KL | 1206 | R? |  | R?
Resistor | 8.87 kΩ | RC0805FR-078K87L | 805 | R?
Resistor | 332 kΩ | RMCF0805FT332K | 805 |  | R?
Resistor | 9.1 kΩ | RMCF0805FT9K10 | 805 | R? | R? | R?
Resistor | 47 kΩ | RC0805FR-0747KL | 805 | R30, R31, R32, R33, R34
Resistor | 52.3 kΩ | RNCP0805FTD52K3 |  | R25
Resistor | 0 Ω | RMCF0805ZT0R00 | 805 | R3, R4 | R13, R14 | R13, R14
Resistor | 10 kΩ | RMCF0805FT10K0 | 805 | R1, R2; R9, R14, R15, R16, R17, R18, R19, R20, R21 | R2, R12; R15, R16, R17, R20, R21, R22, R23, R24, R25, R28, R29, R30, R31, R32, R33, R36, R37, R38 | R2, R12, R20, R21, R22
Resistor | 5.1 kΩ | RC0805FR-075K1L | 805 | R23, R24 | R1 | R1
Resistor | 64.9 kΩ | CRCW080564K9FKEA | 805 | R26
Resistor | 120 Ω | RCS1206120RFKEA | 1206 | R22 | R4 | R4
Resistor | 52.3 kΩ | RNCP0805FTD52K3 | 805 |  |  | R?
Resistor | 10.5 kΩ | RC0805FR-0710K5L | 805 |  |  | R?
Resistor | 140 kΩ | RMCF0805FT140K | 805 | R?
Resistor | 5.36 kΩ | RC0805FR-075K36L | 805 |  | R?
Potentiometer | 30 kΩ | 3362P-1-303LF | 3362F-1-103LF |  | R18, R19, R26, R27, R34, R35 | R18
Potentiometer | 2 kΩ | 3362S-1-202LF | 3362S-1-202LF | VR? | VR? | VR?
Inductor | 7.8 µH | 744325780 |  |  | L?
Inductor | 15 µH | MSS1210-153MED | MSS1210-153MED | L?
Inductor | 3.3 µH | SRP4020TA-3R3M |  | L2 |  | L2
Inductor | 6.8 µH | SRP1038A-6R8M |  |  |  | L?
Diode / ESD | 1.5KE30A | 1.5KE30A | 1.5KE30A | D3
Diode / ESD |  | ESDCAN03-2BWY |  | D2 | D1 | D1
Diode / ESD | D3,D4,D5,D6,D7, D10 | TSD05CDYFR |  | D1, D4, D5, D6, D7 | D10 | D10
Diode / ESD | PMEG3050BEP | PMEG3050BEP | PMEG3050BEP | D9, D10
Diode / ESD | SS5P6-M3/87A | SS5P6-M3_87A |  | D? | D? | D?
Diode / ESD | 1N5820 | 1N5820 | 1N5820 | D8 |  | D8
Fuse | 0685T1000-01 | 0685T1000-01 | 1206 |  | F1, F2, F3, F4, F5, F6 | F2
Fuse | C1F 5 | C1F 5 | 1206 |  | F7, F8, F9, F10, F11, F12 | F3, F4, F5, F6, F7, F8
Fuse | 0.8 A, 32 V | MFU1206FF00800P100 | 1206 | F1
Integrated Circuit | ACPL-K64L-000E | ACPL-K64L-000E |  | U8, U9
Integrated Circuit | AP63203QWU-7 | AP63203QWU-7 |  | U3 |  | U4
Integrated Circuit | BMI323 | BMI323 |  | U11
Integrated Circuit | DRV8462DDWR | DRV8462DDWR |  |  | IC2, IC3, IC4, IC5, IC6, IC7 | IC3
Integrated Circuit | L6374FP | L6374FP |  | U5
Integrated Circuit | RT6365GSP | RT6365GSP |  | IC? | IC? | IC?
Integrated Circuit | STM32C552KET6 | STM32C552KET6 |  | U1
Integrated Circuit | STM32C552RET6 | STM32C552RET6 |  |  | U1 | U1
Integrated Circuit | TCAN3403DRQ1 | TCAN3403DRQ1 |  | IC1 | IC1 | IC1
LED | Green | XL-3216UGC | 1206 | LED1
LED | Red | XL-3216SURC | 1206 | LED2, LED3 | LED1 | LED1
Connector | 530470610 | 0530470610 |  |  | JM1, JM2, JM3, JM4, JM5, JM6 | JM1
Connector | Banana Socket | Banana Socket | Banana Socket | J1 | J5 | J5
Connector | 2171790001 | 2171790001 |  | U12
Connector | 25SH-B-04-TS | 25SH-B-04-TS |  |  | J6, J7, J8, J10, J11, J12 | J6, J7
Connector | HDR1X12V | HDR1X12V | HDR1X12V | J2
Connector | B7P-VH-B_LF__SN_ | B7P-VH-B(LF)(SN) | B7P-VH-B_LF__SN_ |  |  | J9 | J8
Connector | HDR1X2V | HDR1X2V | HDR1X2V | J4, J5, J6 | J2 | J2
Connector | HDR3X2 | HDR3X2 | HDR3X2 | J7 | J1 | J1
Connector (POWER) | TBP02R1W-381-03BE | TBP02R1W-381-03BE | SCREWX3 | J3 | J3 | J3
Switch | EVQPF | EVQPF | EVQPF | SW1 | SW1 | SW1
Test Point | Terminal1 | Terminal1 | Terminal1 | TP? | TP? | TP?
Crystal | 24 MHz | CS10820-24M | CX2520SB24000D0FLJZZ | X1 | X1 | X1

Sheet: Project-Only Components
Components Used in Only One Controller
Exclusive To | Category | Value / Comment | Part Number / LibRef | Footprint | Description | Quantity | Designator(s) | Source Sheet(s) | Review Notes | Reason Included | Normalized Match Key
Main Controller | Capacitor | 0.047 µF | CL10B473KB8NNNC | CAP_CL10_SAM | Ceramic capacitor | 1 | C28 | Main Controller: 3 |  | Part number appears in only one of the three supplied BOMs. | Capacitor|CL10B473KB8NNNC
Main Controller | Capacitor | 1 nF | GRM1555C1H102JA01D | CAP_GRM_155_MUR | Ceramic capacitor | 1 | C30 | Main Controller: 3 |  | Part number appears in only one of the three supplied BOMs. | Capacitor|GRM1555C1H102JA01D
Main Controller | Capacitor | 0.47 µF | GRM155R61H474KE11D | CAP_GRM155_MUR | Ceramic capacitor | 1 | C27 | Main Controller: 3 |  | Part number appears in only one of the three supplied BOMs. | Capacitor|GRM155R61H474KE11D
Main Controller | Resistor | 220 Ω | CRGCQ0603J220R | RESC1608X55N | LED current-limiting resistors | 2 | R27, R28 | Main Controller: 4, 5 |  | Part number appears in only one of the three supplied BOMs. | Resistor|CRGCQ0603J220R
Main Controller | Resistor | 8.87 kΩ | ERA3AEB8871V | ERA3AEB101V | 48 V-to-12 V converter compensation resistor | 1 | R? | Main Controller: 5 | Review: assign a final resistor designator in Altium. | Part number appears in only one of the three supplied BOMs. | Resistor|ERA3AEB8871V
Main Controller | Resistor | 47 kΩ | RC0402FR-0747KL | RESC1005X40N | Pull-up/pull-down resistors | 5 | R30, R31, R32, R33, R34 | Main Controller: 3, 4 |  | Part number appears in only one of the three supplied BOMs. | Resistor|RC0402FR0747KL
Main Controller | Resistor | 52.3 kΩ | RC0402FR-0752K3L | RES_RC0402_YAG | USB detection network resistor | 1 | R25 | Main Controller: 4 |  | Part number appears in only one of the three supplied BOMs. | Resistor|RC0402FR0752K3L
Main Controller | Resistor | 64.9 kΩ | RC0603FR-0764K9L | RC0603N_YAG | USB detection network resistor | 1 | R26 | Main Controller: 4 |  | Part number appears in only one of the three supplied BOMs. | Resistor|RC0603FR0764K9L
Main Controller | Resistor | 140 kΩ | RT0603BRD07140KL | RESC1608X55N | 48 V-to-12 V feedback resistor | 1 | R? | Main Controller: 5 | Review: assign a final resistor designator in Altium. | Part number appears in only one of the three supplied BOMs. | Resistor|RT0603BRD07140KL
Main Controller | Inductor | 15 µH | IHLP4040DZER150M5A | INDPM108102X400N | 48 V-to-12 V converter inductor | 1 | L? | Main Controller: 5 | Review: assign a final inductor designator in Altium. | Part number appears in only one of the three supplied BOMs. | Inductor|IHLP4040DZER150M5A
Main Controller | Diode / ESD | ESDA25P35-1U1M | ESDA25P35-1U1M | ESDA25P351U1M | TVS protection diode | 1 | D3 | Main Controller: 4 |  | Part number appears in only one of the three supplied BOMs. | Diode / ESD|ESDA25P351U1M
Main Controller | Diode / ESD | RSX301LAM30TR | RSX301LAM30TR | SODFL4725X105N | Schottky diode | 2 | D9, D10 | Main Controller: 5 |  | Part number appears in only one of the three supplied BOMs. | Diode / ESD|RSX301LAM30TR
Main Controller | Fuse | 0.8 A, 32 V | SF-0603S080-2 | FUSC1608X55N | 0603 surface-mount fuse | 1 | F1 | Main Controller: 3 |  | Part number appears in only one of the three supplied BOMs. | Fuse|SF0603S0802
Main Controller | Integrated Circuit | ACPL-K64L-000E | ACPL-K64L-000E | STRETCHED_SO-8_AVA | Dual-channel optocoupler | 2 | U8, U9 | Main Controller: 3 |  | Part number appears in only one of the three supplied BOMs. | Integrated Circuit|ACPLK64L000E
Main Controller | Integrated Circuit | BMI323 | BMI323 | BMI323 | Inertial measurement unit | 1 | U11 | Main Controller: 4 |  | Part number appears in only one of the three supplied BOMs. | Integrated Circuit|BMI323
Main Controller | Integrated Circuit | L6374FP | L6374FP | SO-20_STM | Industrial quad line driver | 1 | U5 | Main Controller: 3 |  | Part number appears in only one of the three supplied BOMs. | Integrated Circuit|L6374FP
Main Controller | Integrated Circuit | STM32C552KET6 | STM32C552KET6 | QFP80P900X900X160-32N | Main STM32 microcontroller | 1 | U1 | Main Controller: 2 |  | Part number appears in only one of the three supplied BOMs. | Integrated Circuit|STM32C552KET6
Main Controller | LED | Green | LTST-C190GKT | LEDC1608X90N | Green status LED | 1 | LED1 | Main Controller: 5 |  | Part number appears in only one of the three supplied BOMs. | LED|LTSTC190GKT
Main Controller | Connector | 2171790001 | 2171790001 | 2171790001_MOL | USB Type-C receptacle | 1 | U12 | Main Controller: 4 |  | Part number appears in only one of the three supplied BOMs. | Connector|2171790001
Main Controller | Connector | 39281123 | 39281123 | CONN_SD-5566-002_12_MOL | 12-position Mini-Fit Jr. vertical header | 1 | J2 | Main Controller: 3 |  | Part number appears in only one of the three supplied BOMs. | Connector|39281123
Main Controller | Connector | M12A-12PMMP-SF8001 | M12A-12PMMP-SF8001 |  | 12-pin M12 LiDAR connector | 1 | M1 | Main Controller: 3 | Review: shown on schematic sheet 3 but absent from the generated BOM on page 6. Mating connector noted as TM12A-12PFFP-SF8001. | Part number appears in only one of the three supplied BOMs. | Connector|M12A12PMMPSF8001
STP Motor Control | Capacitor | 220 pF | GCM1555C1H221JA16D | CAPC1005X55N | Converter compensation capacitor | 1 | C? | STP Motor Control: 4 | Review: assign a final capacitor designator in Altium. | Part number appears in only one of the three supplied BOMs. | Capacitor|GCM1555C1H221JA16D
STP Motor Control | Resistor | 31.6 kΩ | ERA-2AEB3162X | ERA2AED122X | Converter feedback resistor | 1 | R? | STP Motor Control: 4 | Review: assign a final resistor designator in Altium. | Part number appears in only one of the three supplied BOMs. | Resistor|ERA2AEB3162X
STP Motor Control | Resistor | 332 kΩ | ERA6AEB3323V | RES_ERA6A_0805_PAN | Switching-frequency resistor | 1 | R? | STP Motor Control: 4 | Review: assign a final resistor designator in Altium. | Part number appears in only one of the three supplied BOMs. | Resistor|ERA6AEB3323V
STP Motor Control | Resistor | 5.36 kΩ | RT0603BRD075K36L | RESC1608X55N | Converter compensation resistor | 1 | R? | STP Motor Control: 4 | Review: assign a final resistor designator in Altium. | Part number appears in only one of the three supplied BOMs. | Resistor|RT0603BRD075K36L
STP Motor Control | Inductor | 7.8 µH | 744325780 | WE-HCI_103023 | 48 V-to-3.3 V converter inductor | 1 | L? | STP Motor Control: 4 | Review: assign a final inductor designator in Altium. | Part number appears in only one of the three supplied BOMs. | Inductor|744325780
Gimbal Controller | Resistor | 52.3 kΩ | RT0402BRD0752K3L | RC0402N_YAG | Converter feedback resistor | 1 | R? | Gimbal Controller: 4 | Review: assign a final resistor designator in Altium. | Part number appears in only one of the three supplied BOMs. | Resistor|RT0402BRD0752K3L
Gimbal Controller | Resistor | 10.5 kΩ | RT0603BRD0710K5L | RC0603N_YAG | Converter compensation resistor | 1 | R? | Gimbal Controller: 4 | Review: assign a final resistor designator in Altium. | Part number appears in only one of the three supplied BOMs. | Resistor|RT0603BRD0710K5L
Gimbal Controller | Inductor | 6.8 µH | WE-LHMI_7050 | WE-LHMI_7050 | Shielded power inductor for the 48 V-to-5 V converter | 1 | L? | Gimbal Controller: 4 | Review: assign a final inductor designator and verify the exact Wurth part number. | Part number appears in only one of the three supplied BOMs. | Inductor|WELHMI7050

Sheet: Source Comparison
Original Grouped Component Lines from the Three BOMs
Project | Category | Designator(s) | Value / Comment | Part Number / LibRef | Footprint | Description | Quantity | Schematic Sheet | Notes | Source
Main Controller | Capacitor | C28 | 0.047 µF | CL10B473KB8NNNC | CAP_CL10_SAM | Ceramic capacitor | 1 | 3 |  | MainController.pdf, p. 6
Main Controller | Capacitor | C1 | 4.7 µF | CL10A475KP8NNNC | CAPC1608X90N | MLCC | 1 | 2 |  | MainController.pdf, p. 6
Main Controller | Capacitor | C2, C3, C4, C5, C7, C9, C17, C18, C31, C32, C35, C36 | 100 nF | CL05B104KO5NNNC | CAPC1005X55N | 16 V MLCC, ±10% | 12 | 2–5 |  | MainController.pdf, p. 6
Main Controller | Capacitor | C6, C16 | 1 µF | CL05A105KO5NNNC | CAPC1005X55N | 16 V MLCC, ±10% | 2 | 2, 4 |  | MainController.pdf, p. 6
Main Controller | Capacitor | C8 | 2.2 µF | CL10A225KP8NNNC | CAPC1608X90N | 10 V X5R MLCC, ±10% | 1 | 2 |  | MainController.pdf, p. 6
Main Controller | Capacitor | C10, C11, C37 | 7 pF | CL10C070CB8NNNC | CAPC1608X90N | 50 V C0G/NP0 capacitor | 3 | 2, 4 |  | MainController.pdf, p. 6
Main Controller | Capacitor | C19, C? (5 unannotated) | 10 µF | CL31A106MAHNNNE | CAPC3216X180N | Ceramic capacitor | 6 | 5 | Review: assign five final capacitor designators in Altium. | MainController.pdf, p. 6
Main Controller | Capacitor | C21, C22 | 22 µF, 10 V | GRM188R61A226ME15D | GRM18x | Ceramic capacitor | 2 | 5 |  | MainController.pdf, p. 6
Main Controller | Capacitor | C25, C? (1 unannotated) | 0.1 µF, 50 V | GCM155R71H104KE02J | CAP_GCM1555_0402_MUR | X7R MLCC | 2 | 3, 5 | Review: assign the final capacitor designator in Altium. | MainController.pdf, p. 6
Main Controller | Capacitor | C26 | 1 µF, 50 V | GRM155R61H105ME05D | CAPC1005X60N | X5R MLCC, ±20% | 1 | 3 |  | MainController.pdf, p. 6
Main Controller | Capacitor | C27 | 0.47 µF | GRM155R61H474KE11D | CAP_GRM155_MUR | Ceramic capacitor | 1 | 3 |  | MainController.pdf, p. 6
Main Controller | Capacitor | C29 | 10 nF | C0603C103K5RACTU | CAPC17595_87N_KEM | 50 V X7R MLCC, ±10% | 1 | 3 |  | MainController.pdf, p. 6
Main Controller | Capacitor | C30 | 1 nF | GRM1555C1H102JA01D | CAP_GRM_155_MUR | Ceramic capacitor | 1 | 3 |  | MainController.pdf, p. 6
Main Controller | Capacitor | C? ×4 | 2.2 µF, 100 V | GRM21BD72A225ME01K | GRM21BR60J226ME39L | Input capacitors for the 48 V-to-12 V converter | 4 | 5 | Review: assign final designators and verify that the footprint/library entry matches 2.2 µF, 100 V. | MainController.pdf, p. 6
Main Controller | Capacitor | C? | 8.2 µF | GCM155R71C823KA55D | CAPC1005X55N | Compensation-network capacitor | 1 | 5 | Review: assign a final designator. The listed part number appears inconsistent with 8.2 µF; verify value and MPN. | MainController.pdf, p. 6
Main Controller | Capacitor | C? | 100 pF | GRM0335C1H101JA01D | G-033_MUR | Compensation capacitor | 1 | 5 | Review: assign a final capacitor designator in Altium. | MainController.pdf, p. 6
Main Controller | Diode / ESD | D1, D4, D5, D6, D7 | ESDZV5H-1BU2 | ESDZV5H-1BU2 | ESDZV5H1BU2 | Bidirectional single-line ESD protection | 5 | 4, 5 |  | MainController.pdf, p. 6
Main Controller | Diode / ESD | D2 | ESDCAN03-2BWY | ESDCAN03-2BWY | SOT65P210X110-3N | CAN-bus TVS protection diode | 1 | 4 |  | MainController.pdf, p. 6
Main Controller | Diode / ESD | D3 | ESDA25P35-1U1M | ESDA25P35-1U1M | ESDA25P351U1M | TVS protection diode | 1 | 4 |  | MainController.pdf, p. 6
Main Controller | Diode / ESD | D8 | VS-30BQ015-M3/9AT | VS-30BQ015-M3_9AT | DIOM7959X262N | Schottky diode | 1 | 4 |  | MainController.pdf, p. 6
Main Controller | Diode / ESD | D9, D10 | RSX301LAM30TR | RSX301LAM30TR | SODFL4725X105N | Schottky diode | 2 | 5 |  | MainController.pdf, p. 6
Main Controller | Diode / ESD | D? | SS5P6-M3/87A | SS5P6-M3_87A | SS5P6M387A | Schottky diode for 48 V-to-12 V converter | 1 | 5 | Review: assign a final diode designator in Altium. | MainController.pdf, p. 6
Main Controller | Fuse | F1 | 0.8 A, 32 V | SF-0603S080-2 | FUSC1608X55N | 0603 surface-mount fuse | 1 | 3 |  | MainController.pdf, p. 6
Main Controller | Integrated Circuit | IC1 | TCAN3403DRQ1 | TCAN3403DRQ1 | SOIC127P600X175-8N - duplicate | 3.3 V CAN transceiver | 1 | 4 | Review: clean the footprint/library name if “duplicate” is unintended. | MainController.pdf, p. 6
Main Controller | Integrated Circuit | IC? | RT6365GSP | RT6365GSP | SOIC127P600X175-9N | 48 V-to-12 V switching regulator | 1 | 5 | Review: assign a final IC designator in Altium. | MainController.pdf, p. 6
Main Controller | Integrated Circuit | U1 | STM32C552KET6 | STM32C552KET6 | QFP80P900X900X160-32N | Main STM32 microcontroller | 1 | 2 |  | MainController.pdf, p. 6
Main Controller | Integrated Circuit | U3 | AP63203QWU-7 | AP63203QWU-7 | TSOT26_DIO | 3.3 V buck regulator | 1 | 5 |  | MainController.pdf, p. 6
Main Controller | Integrated Circuit | U5 | L6374FP | L6374FP | SO-20_STM | Industrial quad line driver | 1 | 3 |  | MainController.pdf, p. 6
Main Controller | Integrated Circuit | U8, U9 | ACPL-K64L-000E | ACPL-K64L-000E | STRETCHED_SO-8_AVA | Dual-channel optocoupler | 2 | 3 |  | MainController.pdf, p. 6
Main Controller | Integrated Circuit | U11 | BMI323 | BMI323 | BMI323 | Inertial measurement unit | 1 | 4 |  | MainController.pdf, p. 6
Main Controller | Connector | J1 | 1776508 | 1776508 | CONN_1776508 | 2-position 48 V input terminal block | 1 | 2 |  | MainController.pdf, p. 6
Main Controller | Connector | J2 | 39281123 | 39281123 | CONN_SD-5566-002_12_MOL | 12-position Mini-Fit Jr. vertical header | 1 | 3 |  | MainController.pdf, p. 6
Main Controller | Connector | J3 | TBP02R1W-381-03BE | TBP02R1W-381-03BE | RHDRRA3W80P0X381_1X3_2182X920X760P | 3-position CAN connector | 1 | 4 |  | MainController.pdf, p. 6
Main Controller | Connector | J4, J5, J6 | BC020-02-A-0200-0300-L-G | BC020-02-A-0200-0300-L-G | BC02002A02000300LG | 2-pin headers/jumpers | 3 | 2, 4 |  | MainController.pdf, p. 6
Main Controller | Connector | J7 | SFH11-NBPC-D03-ST-BK | SFH11-NBPC-D03-ST-BK | SFH11NBPCD03STBK | 6-pin serial-wire debug connector | 1 | 2 |  | MainController.pdf, p. 6
Main Controller | Connector | M1 | M12A-12PMMP-SF8001 | M12A-12PMMP-SF8001 |  | 12-pin M12 LiDAR connector | 1 | 3 | Review: shown on schematic sheet 3 but absent from the generated BOM on page 6. Mating connector noted as TM12A-12PFFP-SF8001. | MainController.pdf, p. 3
Main Controller | Connector | U12 | 2171790001 | 2171790001 | 2171790001_MOL | USB Type-C receptacle | 1 | 4 |  | MainController.pdf, p. 6
Main Controller | Inductor | L2 | 3.3 µH | SRP4020TA-3R3M | SRP4020TA3R3M | Buck-regulator inductor | 1 | 5 |  | MainController.pdf, p. 6
Main Controller | Inductor | L? | 15 µH | IHLP4040DZER150M5A | INDPM108102X400N | 48 V-to-12 V converter inductor | 1 | 5 | Review: assign a final inductor designator in Altium. | MainController.pdf, p. 6
Main Controller | LED | LED1 | Green | LTST-C190GKT | LEDC1608X90N | Green status LED | 1 | 5 |  | MainController.pdf, p. 6
Main Controller | LED | LED2, LED3 | Red | LTST-C191KRKT | LEDC1608X55N | Red USB/debug LEDs | 2 | 2, 4 |  | MainController.pdf, p. 6
Main Controller | Resistor | R1, R2 | 10 kΩ | RC0603FR0710KL | RESC1608X55N | Fixed resistor | 2 | 2, 5 |  | MainController.pdf, p. 6
Main Controller | Resistor | R3, R4 | 0 Ω | RC0402JR070RL | RESC1005X40N | Zero-ohm jumper resistor | 2 | 2 |  | MainController.pdf, p. 6
Main Controller | Resistor | R9, R14, R15, R16, R17, R18, R19, R20, R21 | 10 kΩ | RC0603FR0710KL | RESC1608X55N | Fixed resistor | 9 | 3 |  | MainController.pdf, p. 6
Main Controller | Resistor | R10, R11, R12, R13, R29 | 1 kΩ | CRCW06031K00FKEA | RES_CRCW_0603 | Fixed resistor | 5 | 2, 3 |  | MainController.pdf, p. 6
Main Controller | Resistor | R22 | 120 Ω | RCS1206120RFKEA | RCS1206_E3 | CAN termination resistor | 1 | 4 |  | MainController.pdf, p. 6
Main Controller | Resistor | R23, R24 | 5.1 kΩ | RC0603FR-075K1L | RESC1608X55N | USB Type-C CC resistors | 2 | 4 |  | MainController.pdf, p. 6
Main Controller | Resistor | R25 | 52.3 kΩ | RC0402FR-0752K3L | RES_RC0402_YAG | USB detection network resistor | 1 | 4 |  | MainController.pdf, p. 6
Main Controller | Resistor | R26 | 64.9 kΩ | RC0603FR-0764K9L | RC0603N_YAG | USB detection network resistor | 1 | 4 |  | MainController.pdf, p. 6
Main Controller | Resistor | R27, R28 | 220 Ω | CRGCQ0603J220R | RESC1608X55N | LED current-limiting resistors | 2 | 4, 5 |  | MainController.pdf, p. 6
Main Controller | Resistor | R30, R31, R32, R33, R34 | 47 kΩ | RC0402FR-0747KL | RESC1005X40N | Pull-up/pull-down resistors | 5 | 3, 4 |  | MainController.pdf, p. 6
Main Controller | Resistor | R? | 8.87 kΩ | ERA3AEB8871V | ERA3AEB101V | 48 V-to-12 V converter compensation resistor | 1 | 5 | Review: assign a final resistor designator in Altium. | MainController.pdf, p. 6
Main Controller | Resistor | R? | 9.1 kΩ | ERA-6AEB912V | ERA6AEB101V | 48 V-to-12 V feedback resistor | 1 | 5 | Review: assign a final resistor designator in Altium. | MainController.pdf, p. 6
Main Controller | Resistor | R? | 140 kΩ | RT0603BRD07140KL | RESC1608X55N | 48 V-to-12 V feedback resistor | 1 | 5 | Review: assign a final resistor designator in Altium. | MainController.pdf, p. 6
Main Controller | Resistor | R? | 249 kΩ | ERA-3AEB2493V | ERA3AEB101V | Switching-frequency resistor | 1 | 5 | Review: assign a final resistor designator in Altium. | MainController.pdf, p. 6
Main Controller | Switch | SW1 | PTS636SK25FSMTRLFS | PTS636SK25FSMTRLFS | PTS636SK25FSMTRLFS | Momentary reset push-button switch | 1 | 5 |  | MainController.pdf, p. 6
Main Controller | Test Point | TP? | PH1-01-UA | PH1-01-UA | CONN_PH1-01-UA_ADM | 12 V test point | 1 | 5 | Review: assign a final test-point designator in Altium. | MainController.pdf, p. 6
Main Controller | Potentiometer | VR? | 2 kΩ | PV36W202C01B00 | PV36W201C01B00 | Variable resistor for output adjustment | 1 | 5 | Review: assign a final variable-resistor designator in Altium. | MainController.pdf, p. 6
Main Controller | Crystal | X1 | 24 MHz | CS10820-24M | CS1082024M | 24 MHz crystal, 6 pF load capacitance | 1 | 2 |  | MainController.pdf, p. 6
STP Motor Control | Capacitor | C1 | 4.7 µF | CL10A475KP8NNNC | CAPC1608X90N | Multilayer ceramic capacitor (MLCC) | 1 | 2 |  | STPMotorControl_1.pdf, p. 9
STP Motor Control | Capacitor | C2, C3, C4, C5, C7, C10, C22 | 100 nF | CL05B104KO5NNNC | CAPC1005X55N | 16 V MLCC, ±10% | 7 | 2–4 |  | STPMotorControl_1.pdf, p. 9
STP Motor Control | Capacitor | C6, C9, C25, C30, C32, C37, C39, C44, C46, C51, C53, C58, C60, C65 | 1 µF | CL05A105KO5NNNC | CAPC1005X55N | 16 V MLCC, ±10% | 14 | 2–7 |  | STPMotorControl_1.pdf, p. 9
STP Motor Control | Capacitor | C8 | 2.2 µF | CL10A225KP8NNNC | CAPC1608X90N | 10 V X5R MLCC, ±10% | 1 | 2 |  | STPMotorControl_1.pdf, p. 9
STP Motor Control | Capacitor | C23, C24 | 7 pF | CL10C070CB8NNNC | CAPC1608X90N | 50 V C0G/NP0 capacitor | 2 | 4 |  | STPMotorControl_1.pdf, p. 9
STP Motor Control | Capacitor | C26, C31, C36, C38, C40, C45, C50, C52, C54, C59, C64, C66, C? | 0.1 µF, 50 V | GCM155R71H104KE02J | CAP_GCM1555_0402_MUR | X7R MLCC | 13 | 4–7 | Review: assign the final designator to the unannotated capacitor on sheet 4. | STPMotorControl_1.pdf, p. 9
STP Motor Control | Capacitor | C27, C33, C41, C47, C55, C61 | 1 µF, 50 V | GRM155R61H105ME05D | CAPC1005X60N | X5R MLCC, ±20% | 6 | 5–7 |  | STPMotorControl_1.pdf, p. 9
STP Motor Control | Capacitor | C28, C29, C34, C35, C42, C43, C48, C49, C56, C57, C62, C63 | 10 nF, 50 V | C0603C103K5RACTU | CAPC17595_87N_KEM | 50 V X7R MLCC, ±10% | 12 | 5–7 |  | STPMotorControl_1.pdf, p. 9
STP Motor Control | Capacitor | C? ×4 | 2.2 µF, 100 V | GRM21BD72A225ME01K | GRM21BR60J226ME39L | Input capacitors for the 48 V-to-3.3 V converter | 4 | 4 | Review: assign four final capacitor designators and verify the footprint/library entry. | STPMotorControl_1.pdf, p. 9
STP Motor Control | Capacitor | C? | 10 nF | C0603C103K5RACTU | CAPC17595_87N_KEM | Converter compensation capacitor | 1 | 4 | Review: assign a final capacitor designator in Altium. | STPMotorControl_1.pdf, p. 9
STP Motor Control | Capacitor | C? | 10 µF | CL31A106MAHNNNE | CAPC3216X180N | Converter output capacitor | 1 | 4 | Review: assign a final capacitor designator in Altium. | STPMotorControl_1.pdf, p. 9
STP Motor Control | Capacitor | C? ×3 | 47 µF | GRM32ER61C476KE15L | CAPC3225X270N | Converter output capacitors | 3 | 4 | Review: assign three final capacitor designators in Altium. | STPMotorControl_1.pdf, p. 9
STP Motor Control | Capacitor | C? | 220 pF | GCM1555C1H221JA16D | CAPC1005X55N | Converter compensation capacitor | 1 | 4 | Review: assign a final capacitor designator in Altium. | STPMotorControl_1.pdf, p. 9
STP Motor Control | Diode / ESD | D1 | ESDCAN03-2BWY | ESDCAN03-2BWY | SOT65P210X110-3N | CAN-bus TVS protection diode | 1 | 3 |  | STPMotorControl_1.pdf, p. 9
STP Motor Control | Diode / ESD | D10 | ESDZV5H | ESDZV5H-1BU2 | ESDZV5H1BU2 | Bidirectional single-line ESD protection | 1 | 4 |  | STPMotorControl_1.pdf, p. 9
STP Motor Control | Diode / ESD | D? | SS5P6-M3/87A | SS5P6-M3_87A | SS5P6M387A | Schottky diode for the 48 V-to-3.3 V converter | 1 | 4 | Review: assign a final diode designator in Altium. | STPMotorControl_1.pdf, p. 9
STP Motor Control | Fuse | F1, F2, F3, F4, F5, F6 | 0685T1000-01 | 0685T1000-01 | FUSC3216X83N | Driver supply fuses | 6 | 5–7 |  | STPMotorControl_1.pdf, p. 9
STP Motor Control | Fuse | F7, F8, F9, F10, F11, F12 | C1F 5 | C1F 5 | C1_BEL | Motor/output connector fuses | 6 | 8 | Review: verify the required current and voltage ratings for the selected C1F 5 fuse. | STPMotorControl_1.pdf, p. 9
STP Motor Control | Integrated Circuit | IC1 | TCAN3403DRQ1 | TCAN3403DRQ1 | SOIC127P600X175-8N - duplicate | 3.3 V CAN transceiver | 1 | 3 | Review: clean the footprint/library name if “duplicate” is unintended. | STPMotorControl_1.pdf, p. 9
STP Motor Control | Integrated Circuit | IC2, IC3, IC4, IC5, IC6, IC7 | DRV8462DDWR | DRV8462DDWR | SOP64P810X120-45N | Stepper motor driver | 6 | 5–7 |  | STPMotorControl_1.pdf, p. 9
STP Motor Control | Integrated Circuit | IC? | RT6365GSP | RT6365GSP | SOIC127P600X175-9N | 48 V-to-3.3 V switching regulator | 1 | 4 | Review: assign a final IC designator in Altium. | STPMotorControl_1.pdf, p. 9
STP Motor Control | Integrated Circuit | U1 | STM32C552RET6 | STM32C552RET6 | QFP50P1200X1200X160-64N | Main STM32 microcontroller | 1 | 2 |  | STPMotorControl_1.pdf, p. 9
STP Motor Control | Connector | J1 | SFH11-NBPC-D03-ST-BK | SFH11-NBPC-D03-ST-BK | SFH11NBPCD03STBK | 6-pin serial-wire debug connector | 1 | 2 |  | STPMotorControl_1.pdf, p. 9
STP Motor Control | Connector | J2 | BC020-02-A-0200-0300-L-G | BC020-02-A-0200-0300-L-G | BC02002A02000300LG | 2-pin CAN connector/header | 1 | 3 |  | STPMotorControl_1.pdf, p. 9
STP Motor Control | Connector | J3 | TBP02R1W-381-03BE | TBP02R1W-381-03BE | RHDRRA3W80P0X381_1X3_2182X920X760P | 3-position CAN connector | 1 | 3 |  | STPMotorControl_1.pdf, p. 9
STP Motor Control | Connector | J5 | 1776508 | 1776508 | CONN_1776508 | 2-position 48 V input terminal block | 1 | 4 |  | STPMotorControl_1.pdf, p. 9
STP Motor Control | Connector | J6, J7, J8, J10, J11, J12 | 25SH-B-04-TS | 25SH-B-04-TS | 25SHB04TS | 4-position sensor/home connectors | 6 | 8 |  | STPMotorControl_1.pdf, p. 9
STP Motor Control | Connector | J9 | B7P-VH-B_LF__SN_ | B7P-VH-B_LF__SN_ | B7PVHBLFSN | 7-position power/output connector | 1 | 8 | The schematic notes the mating housing VHR-7N and contact SVH-41T-P1.1. | STPMotorControl_1.pdf, p. 9
STP Motor Control | Connector | JM1, JM2, JM3, JM4, JM5, JM6 | 0530470610 | 0530470610 | 530470610 | 6-position stepper motor connectors | 6 | 8 |  | STPMotorControl_1.pdf, p. 9
STP Motor Control | Inductor | L? | 7.8 µH | 744325780 | WE-HCI_103023 | 48 V-to-3.3 V converter inductor | 1 | 4 | Review: assign a final inductor designator in Altium. | STPMotorControl_1.pdf, p. 9
STP Motor Control | LED | LED1 | Red | LTST-C191KRKT | LEDC1608X55N | MCU debug LED | 1 | 2 |  | STPMotorControl_1.pdf, p. 9
STP Motor Control | Resistor | R1 | 5.1 kΩ | RC0603FR-075K1L | RESC1608X55N | Fixed resistor | 1 | 2 |  | STPMotorControl_1.pdf, p. 9
STP Motor Control | Resistor | R2, R12 | 10 kΩ | RC0603FR0710KL | RESC1608X55N | Fixed resistor | 2 | 2, 4 |  | STPMotorControl_1.pdf, p. 9
STP Motor Control | Resistor | R3 | 1 kΩ | CRCW06031K00FKEA | RES_CRCW_0603 | Debug LED current-limiting resistor | 1 | 2 |  | STPMotorControl_1.pdf, p. 9
STP Motor Control | Resistor | R4 | 120 Ω | RCS1206120RFKEA | RCS1206_E3 | CAN termination resistor | 1 | 3 |  | STPMotorControl_1.pdf, p. 9
STP Motor Control | Resistor | R13, R14 | 0 Ω | RC0402JR070RL | RESC1005X40N | Crystal-series zero-ohm resistors | 2 | 4 |  | STPMotorControl_1.pdf, p. 9
STP Motor Control | Resistor | R15, R16, R17, R20, R21, R22, R23, R24, R25, R28, R29, R30, R31, R32, R33, R36, R37, R38 | 10 kΩ | RC0603FR0710KL | RESC1608X55N | Stepper-driver pull-up/pull-down resistors | 18 | 5–7 |  | STPMotorControl_1.pdf, p. 9
STP Motor Control | Potentiometer | R18, R19, R26, R27, R34, R35 | 30 kΩ | 3362P-1-303LF | 3362P_1 | Stepper-driver VREF adjustment potentiometers | 6 | 5–7 |  | STPMotorControl_1.pdf, p. 9
STP Motor Control | Resistor | R? | 5.36 kΩ | RT0603BRD075K36L | RESC1608X55N | Converter compensation resistor | 1 | 4 | Review: assign a final resistor designator in Altium. | STPMotorControl_1.pdf, p. 9
STP Motor Control | Resistor | R? | 9.1 kΩ | ERA-6AEB912V | ERA6AEB101V | Converter feedback resistor | 1 | 4 | Review: assign a final resistor designator in Altium. | STPMotorControl_1.pdf, p. 9
STP Motor Control | Resistor | R? | 31.6 kΩ | ERA-2AEB3162X | ERA2AED122X | Converter feedback resistor | 1 | 4 | Review: assign a final resistor designator in Altium. | STPMotorControl_1.pdf, p. 9
STP Motor Control | Resistor | R? | 332 kΩ | ERA6AEB3323V | RES_ERA6A_0805_PAN | Switching-frequency resistor | 1 | 4 | Review: assign a final resistor designator in Altium. | STPMotorControl_1.pdf, p. 9
STP Motor Control | Switch | SW1 | PTS636SK25FSMTRLFS | PTS636SK25FSMTRLFS | PTS636SK25FSMTRLFS | Momentary MCU reset push-button switch | 1 | 4 |  | STPMotorControl_1.pdf, p. 9
STP Motor Control | Test Point | TP? | PH1-01-UA | PH1-01-UA | CONN_PH1-01-UA_ADM | 3.3 V output test point | 1 | 4 | Review: assign a final test-point designator in Altium. | STPMotorControl_1.pdf, p. 9
STP Motor Control | Potentiometer | VR? | 2 kΩ | PV36W202C01B00 | PV36W201C01B00 | Converter output-adjustment potentiometer | 1 | 4 | Review: assign a final variable-resistor designator in Altium. | STPMotorControl_1.pdf, p. 9
STP Motor Control | Crystal | X1 | 24 MHz | CS10820-24M | CS1082024M | 24 MHz crystal, 6 pF load capacitance | 1 | 4 |  | STPMotorControl_1.pdf, p. 9
Gimbal Controller | Capacitor | C1 | 4.7 µF | CL10A475KP8NNNC | CAPC1608X90N | Multilayer ceramic capacitor (MLCC) | 1 | 2 |  | GimbalController(1).pdf, p. 7
Gimbal Controller | Capacitor | C2, C3, C4, C5, C7, C10, C18, C22 | 100 nF | CL05B104KO5NNNC | CAPC1005X55N | 16 V MLCC, ±10% | 8 | 2–4 |  | GimbalController(1).pdf, p. 7
Gimbal Controller | Capacitor | C6, C9, C30, C37 | 1 µF | CL05A105KO5NNNC | CAPC1005X55N | 16 V MLCC, ±10% | 4 | 2, 3, 5 |  | GimbalController(1).pdf, p. 7
Gimbal Controller | Capacitor | C8 | 2.2 µF | CL10A225KP8NNNC | CAPC1608X90N | 10 V X5R MLCC, ±10% | 1 | 2 |  | GimbalController(1).pdf, p. 7
Gimbal Controller | Capacitor | C19, C? | 10 µF | CL31A106MAHNNNE | CAPC3216X180N | Ceramic capacitor | 2 | 4 | Review: assign the final designator to the unannotated 10 µF capacitor. | GimbalController(1).pdf, p. 7
Gimbal Controller | Capacitor | C20, C21 | 22 µF, 10 V | GRM188R61A226ME15D | GRM18x | Ceramic output capacitors for the 5 V-to-3.3 V regulator | 2 | 4 |  | GimbalController(1).pdf, p. 7
Gimbal Controller | Capacitor | C23, C24 | 7 pF | CL10C070CB8NNNC | CAPC1608X90N | 50 V C0G/NP0 capacitors | 2 | 4 |  | GimbalController(1).pdf, p. 7
Gimbal Controller | Capacitor | C31, C38, C? | 0.1 µF, 50 V | GCM155R71H104KE02J | CAP_GCM1555_0402_MUR | X7R MLCC | 3 | 4, 5 | Review: assign the final designator to the unannotated 0.1 µF capacitor. | GimbalController(1).pdf, p. 7
Gimbal Controller | Capacitor | C33 | 1 µF, 50 V | GRM155R61H105ME05D | CAPC1005X60N | X5R MLCC, ±20% | 1 | 5 |  | GimbalController(1).pdf, p. 7
Gimbal Controller | Capacitor | C34, C35 | 10 nF, 50 V | C0603C103K5RACTU | CAPC17595_87N_KEM | 50 V X7R MLCC, ±10% | 2 | 5 |  | GimbalController(1).pdf, p. 7
Gimbal Controller | Capacitor | C? ×4 | 2.2 µF, 100 V | GRM21BD72A225ME01K | GRM21BR60J226ME39L | Input capacitors for the 48 V-to-5 V converter | 4 | 4 | Review: assign four final capacitor designators and verify the footprint/library entry. | GimbalController(1).pdf, p. 7
Gimbal Controller | Capacitor | C? | 8.2 µF | GCM155R71C823KA55D | CAPC1005X55N | Converter compensation capacitor | 1 | 4 | Review: assign a final designator. The listed part number may not match 8.2 µF; verify value and MPN. | GimbalController(1).pdf, p. 7
Gimbal Controller | Capacitor | C? ×3 | 47 µF | GRM32ER61C476KE15L | CAPC3225X270N | 48 V-to-5 V converter output capacitors | 3 | 4 | Review: assign three final capacitor designators in Altium. | GimbalController(1).pdf, p. 7
Gimbal Controller | Capacitor | C? | 100 pF | GRM0335C1H101JA01D | G-033_MUR | Converter compensation capacitor | 1 | 4 | Review: assign a final capacitor designator in Altium. | GimbalController(1).pdf, p. 7
Gimbal Controller | Diode / ESD | D1 | ESDCAN03-2BWY | ESDCAN03-2BWY | SOT65P210X110-3N | CAN-bus TVS protection diode | 1 | 3 |  | GimbalController(1).pdf, p. 7
Gimbal Controller | Diode / ESD | D8 | VS-30BQ015-M3/9AT | VS-30BQ015-M3_9AT | DIOM7959X262N | Schottky diode | 1 | 4 |  | GimbalController(1).pdf, p. 7
Gimbal Controller | Diode / ESD | D10 | ESDZV5H | ESDZV5H-1BU2 | ESDZV5H1BU2 | Bidirectional single-line ESD protection | 1 | 4 |  | GimbalController(1).pdf, p. 7
Gimbal Controller | Diode / ESD | D? | SS5P6-M3/87A | SS5P6-M3_87A | SS5P6M387A | Schottky diode for the 48 V-to-5 V converter | 1 | 4 | Review: assign a final diode designator in Altium. | GimbalController(1).pdf, p. 7
Gimbal Controller | Fuse | F2 | 0685T1000-01 | 0685T1000-01 | FUSC3216X83N | Stepper-driver supply fuse | 1 | 5 |  | GimbalController(1).pdf, p. 7
Gimbal Controller | Fuse | F3, F4, F5, F6, F7, F8 | C1F 5 | C1F5 | C1_BEL | LED-module connector fuses | 6 | 6 | Review: verify the current and voltage ratings required for the selected C1F 5 fuse. | GimbalController(1).pdf, p. 7
Gimbal Controller | Integrated Circuit | IC1 | TCAN3403DRQ1 | TCAN3403DRQ1 | SOIC127P600X175-8N - duplicate | 3.3 V CAN transceiver | 1 | 3 | Review: clean the footprint/library name if “duplicate” is unintended. | GimbalController(1).pdf, p. 7
Gimbal Controller | Integrated Circuit | IC3 | DRV8462DDWR | DRV8462DDWR | SOP64P810X120-45N | Stepper motor driver | 1 | 5 |  | GimbalController(1).pdf, p. 7
Gimbal Controller | Integrated Circuit | IC? | RT6365GSP | RT6365GSP | SOIC127P600X175-9N | 48 V-to-5 V switching regulator | 1 | 4 | Review: assign a final IC designator in Altium. | GimbalController(1).pdf, p. 7
Gimbal Controller | Integrated Circuit | U1 | STM32C552RET6 | STM32C552RET6 | QFP50P1200X1200X160-64N | Main STM32 microcontroller | 1 | 2 |  | GimbalController(1).pdf, p. 7
Gimbal Controller | Integrated Circuit | U4 | AP63203QWU-7 | AP63203QWU-7 | TSOT26_DIO | 5 V-to-3.3 V buck regulator | 1 | 4 |  | GimbalController(1).pdf, p. 7
Gimbal Controller | Connector | J1 | SFH11-NBPC-D03-ST-BK | SFH11-NBPC-D03-ST-BK | SFH11NBPCD03STBK | 6-pin serial-wire debug connector | 1 | 2 |  | GimbalController(1).pdf, p. 7
Gimbal Controller | Connector | J2 | BC020-02-A-0200-0300-L-G | BC020-02-A-0200-0300-L-G | BC02002A02000300LG | 2-pin CAN connector/header | 1 | 3 |  | GimbalController(1).pdf, p. 7
Gimbal Controller | Connector | J3 | TBP02R1W-381-03BE | TBP02R1W-381-03BE | RHDRRA3W80P0X381_1X3_2182X920X760P | 3-position CAN connector | 1 | 3 |  | GimbalController(1).pdf, p. 7
Gimbal Controller | Connector | J5 | 1776508 | 1776508 | CONN_1776508 | 2-position 48 V input terminal block | 1 | 4 |  | GimbalController(1).pdf, p. 7
Gimbal Controller | Connector | J6, J7 | 25SH-B-04-TS | 25SH-B-04-TS | 25SHB04TS | 4-position magnetic-encoder and servo connectors | 2 | 6 | The schematic notes the 25CH-B-04 mating housing and 25CTB-R contact. | GimbalController(1).pdf, p. 7
Gimbal Controller | Connector | J8 | B7P-VH-B(LF)(SN) | B7P-VH-B_LF__SN_ | B7PVHBLFSN | 7-position LED-module connector | 1 | 6 | The schematic notes mating housing VHR-7N and contact SVH-41T-P1.1. | GimbalController(1).pdf, p. 7
Gimbal Controller | Connector | JM1 | 0530470610 | 0530470610 | 530470610 | 6-position stepper motor connector | 1 | 6 |  | GimbalController(1).pdf, p. 7
Gimbal Controller | Inductor | L2 | 3.3 µH | SRP4020TA-3R3M | SRP4020TA3R3M | 5 V-to-3.3 V regulator inductor | 1 | 4 |  | GimbalController(1).pdf, p. 7
Gimbal Controller | Inductor | L? | 6.8 µH | WE-LHMI_7050 | WE-LHMI_7050 | Shielded power inductor for the 48 V-to-5 V converter | 1 | 4 | Review: assign a final inductor designator and verify the exact Wurth part number. | GimbalController(1).pdf, p. 7
Gimbal Controller | LED | LED1 | Red | LTST-C191KRKT | LEDC1608X55N | MCU debug LED | 1 | 2 |  | GimbalController(1).pdf, p. 7
Gimbal Controller | Resistor | R1 | 5.1 kΩ | RC0603FR-075K1L | RESC1608X55N | Fixed resistor | 1 | 2 |  | GimbalController(1).pdf, p. 7
Gimbal Controller | Resistor | R2, R12, R20, R21, R22 | 10 kΩ | RC0603FR0710KL | RESC1608X55N | Fixed resistors | 5 | 2, 4, 5 |  | GimbalController(1).pdf, p. 7
Gimbal Controller | Resistor | R3 | 1 kΩ | CRCW06031K00FKEA | RES_CRCW_0603 | Debug LED current-limiting resistor | 1 | 2 |  | GimbalController(1).pdf, p. 7
Gimbal Controller | Resistor | R4 | 120 Ω | RCS1206120RFKEA | RCS1206_E3 | CAN termination resistor | 1 | 3 |  | GimbalController(1).pdf, p. 7
Gimbal Controller | Resistor | R13, R14 | 0 Ω | RC0402JR070RL | RESC1005X40N | Crystal-series zero-ohm resistors | 2 | 4 |  | GimbalController(1).pdf, p. 7
Gimbal Controller | Potentiometer | R18 | 30 kΩ | 3362P-1-303LF | 3362P_1 | Stepper-driver VREF adjustment potentiometer | 1 | 5 |  | GimbalController(1).pdf, p. 7
Gimbal Controller | Resistor | R? | 9.1 kΩ | ERA-6AEB912V | ERA6AEB101V | Converter feedback resistor | 1 | 4 | Review: assign a final resistor designator in Altium. | GimbalController(1).pdf, p. 7
Gimbal Controller | Resistor | R? | 10.5 kΩ | RT0603BRD0710K5L | RC0603N_YAG | Converter compensation resistor | 1 | 4 | Review: assign a final resistor designator in Altium. | GimbalController(1).pdf, p. 7
Gimbal Controller | Resistor | R? | 52.3 kΩ | RT0402BRD0752K3L | RC0402N_YAG | Converter feedback resistor | 1 | 4 | Review: assign a final resistor designator in Altium. | GimbalController(1).pdf, p. 7
Gimbal Controller | Resistor | R? | 249 kΩ | ERA-3AEB2493V | ERA3AEB101V | Switching-frequency resistor | 1 | 4 | Review: assign a final resistor designator in Altium. | GimbalController(1).pdf, p. 7
Gimbal Controller | Switch | SW1 | PTS636SK25FSMTRLFS | PTS636SK25FSMTRLFS | PTS636SK25FSMTRLFS | Momentary MCU reset push-button switch | 1 | 4 |  | GimbalController(1).pdf, p. 7
Gimbal Controller | Test Point | TP? | PH1-01-UA | PH1-01-UA | CONN_PH1-01-UA_ADM | 5 V output test point | 1 | 4 | Review: assign a final test-point designator in Altium. | GimbalController(1).pdf, p. 7
Gimbal Controller | Potentiometer | VR? | 2 kΩ | PV36W202C01B00 | PV36W201C01B00 | 48 V-to-5 V converter output-adjustment potentiometer | 1 | 4 | Review: assign a final variable-resistor designator in Altium. | GimbalController(1).pdf, p. 7
Gimbal Controller | Crystal | X1 | 24 MHz | CS10820-24M | CS1082024M | 24 MHz crystal, 6 pF load capacitance | 1 | 4 |  | GimbalController(1).pdf, p. 7

Sheet: Summary
Combined BOM Comparison Summary
Unique component types | 74 | Total physical parts | 340 | Used in all 3 | 30 | Project-only types | 28
Project | Physical Quantity | Grouped BOM Lines | Exclusive Component Types | Component Types Used
Main Controller | 111 | 59 | 20 | 57
STP Motor Control | 148 | 46 | 5 | 44
Gimbal Controller | 81 | 49 | 3 | 49
Usage Across Projects | Unique Types |  | Category | Unique Types | Total Quantity
Only 1 project | 28 |  | Capacitor | 18 | 141
Exactly 2 projects | 16 |  | Resistor | 18 | 77
All 3 projects | 30 |  | Potentiometer | 2 | 10
 |  |  | Inductor | 4 | 5
 |  |  | Diode / ESD | 6 | 18
 |  |  | Fuse | 3 | 20
 |  |  | Integrated Circuit | 9 | 22
 |  |  | LED | 2 | 5
 |  |  | Connector | 8 | 30
 |  |  | Switch | 1 | 3
 |  |  | Test Point | 1 | 3
 |  |  | Crystal | 1 | 3

Sheet: Source Files
Input Workbooks Used
Project | Uploaded Workbook | Grouped Lines | Physical Quantity
Main Controller | MainController_Component_List(1).xlsx | 59 | 112
STP Motor Control | STPMotorControl_1_Component_List(1).xlsx | 46 | 148
Gimbal Controller | GimbalController_Component_List(1).xlsx | 49 | 81
