mohanan02/Controller-Design-for-an-Autonomous-Vehicle-Hazard-Warning-and-Intent-Projection-System/SchematicPDF&ComponentList/GimbalController_Component_List_PDF_Order.xlsx

Gimbal Warning Projector Controller Component List
Source | GimbalController.pdf |  |  |  | Total component quantity | 103
PDF Order | Comment / Value | Description | Designator | Footprint | LibRef / Part Number | Quantity | Price
1 | 4.7uF | Multilayer Ceramic Capacitors MLCC - SMD/SMT | C1 | CAPC1608X90N | CL10A475KP8NNNC | 1 | 0.19
2 | 100nF | Samsung Electro-Mechanics CL05B104KO5NNNC 100nF Multilayer Ceramic Capacitor MLCC 16Vdc +/-10% Tolerance SMD | C2, C3, C4, C5, C7, C10, C15, C16, C20 | CAPC1005X55N | CL05B104KO5NNNC | 9 | 1.71
3 | 1uF | Samsung Electro-Mechanics 0402 (1005M) 1uF Multilayer Ceramic Capacitor MLCC 16Vdc +/-10% SMD CL05A105KO5NNNC | C6, C9, C23, C28, C30, C35 | CAPC1005X55N | CL05A105KO5NNNC | 6 | 1.14
4 | 2.2uF | Samsung Electro-Mechanics 0603 CL 2.2uF Ceramic Multilayer Capacitor, 10V, +85C, X5R Dielectric, +/-10% SMD | C8 | CAPC1608X90N | CL10A225KP8NNNC | 1 | 0.19
5 | 7pF | CAPCER7PF 50V C0G/NP0 0603 | C11, C21, C22 | CAPC1608X90N | CL10C070CB8NNNC | 3 | 0.57
6 | 22uF10V | Capacitor | C12, C13, C14, C65, C66 | GRM18x | GRM188R61A226ME15D | 5 | 1.5
7 | 4.7uF100V | SMD capacitor X7S(EIA) with capacitance 4.7uF Tol.20%. Rated voltage 100Vdc 125C | C17 | CAPC3216X190N | GRM31CC72A475ME11L | 1 | 1.39
8 | 100nF100V | Description | C18 | CAP_0603_WAL | 0603B104K101CT | 1 | 0.19
9 | 10uF | Capacitor | C19 | CAPC3216X180N | CL31A106MAHNNNE | 1 | 0.3
10 | 0.1uF50V | Description | C24, C29, C34, C36 | CAP_GCM1555_0402_MUR | GCM155R71H104KE02J | 4 | 0.76
11 | 1uF50V | SMD capacitor X5R(EIA) with capacitance 1.0uF Tol.20%. Rated voltage 50Vdc 85C | C25, C31 | CAPC1005X60N | GRM155R61H105ME05D | 2 | 0.38
12 | 10nF50V | SMD Comm X7R, Ceramic, 0.01uF, 10%, 50VDC, X7R, SMD, MLCC, Temperature Stable, Class II, 0603 | C26, C27, C32, C33 | CAPC17595_87N_KEM | C0603C103K5RACTU | 4 | 0.76
13 | ESDCAN03-2BWY | TVS Diode (Uni-directional) | D1 | SOT65P210X110-3N | ESDCAN03-2BWY | 1 | 0.95
14 | VS-30BQ015-M3_9AT | Schottky Diode | D2, D9, D10 | DIOM7959X262N | VS-30BQ015-M3_9AT | 3 | 7.29
15 | ESDZV5H-1BU2 | Ultra low clamping single line bidirectional ESD protection | D3, D4, D5, D6 | ESDZV5H1BU2 | ESDZV5H-1BU2 | 4 | 1.4
16 | ESDA25P35-1U1M | TVS Diode (Uni-directional) | D7 | ESDA25P351U1M | ESDA25P35-1U1M | 1 | 1
17 | ESDZV5H | Ultra low clamping single line bidirectional ESD protection | D8 | ESDZV5H1BU2 | ESDZV5H-1BU2 | 1 | 0.35
18 | 0685T1000-01 | Fuse | F1, F2 | FUSC3216X83N | 0685T1000-01 | 2 | 1.64
19 | C1F 5 | Description | F4, F5, F6, F7, F8, F9 | C1_BEL | C1F 5 | 6 | 4.56
20 | DRV8462DDWR | Integrated Circuit | IC1, IC2 | SOP64P810X120-45N | DRV8462DDWR | 2 | 37.8
21 | TCAN3403DRQ1 | Integrated Circuit | IC7 | SOIC127P600X175-8N - duplicate | TCAN3403DRQ1 | 1 | 3.6
22 | 25SH-B-04-TS | Connector | J1, J2 | 25SHB04TS | 25SH-B-04-TS | 2 | 0.38
23 | SFH11-NBPC-D03-ST-BK | Connector | J7 | SFH11NBPCD03STBK | SFH11-NBPC-D03-ST-BK | 1 | 1.17
24 | BC020-02-A-0200-0300-L-G | Connector | J8, J10 | BC02002A02000300LG | BC020-02-A-0200-0300-L-G | 2 | 1.44
25 | TBP02R1W-381-03BE | Connector | J9 | RHDRRA3W80P0X381_1X3_2182X920X760P | TBP02R1W-381-03BE | 1 | 1.22
26 | 1776508 | PCB headers, nominal current: 12A, rated voltage (III/2): 320V, 2 positions, 5.08mm pitch, green, tin contacts, wave soldering, gold-plated contact surface / Green RAL 6021 | J11 | CONN_1776508 | 1776508 | 1
27 | B7P-VH-B_LF__SN_ | Connector | J13 | B7PVHBLFSN | B7P-VH-B_LF__SN_ | 1 | 0.82
28 | 0530470610 | Connector | JM1, JM2 | 530470610 | 0530470610 | 2 | 1.4
29 | 15uH | Inductor | L1 | 1217ASH100MP3 | 1217AS-H-150M=P3 | 1 | 1.26
30 | SRP4020TA-3R3M | Inductor | L2 | SRP4020TA3R3M | SRP4020TA-3R3M | 1 | 1.98
31 | RED | LED | LED1, LED3 | LEDC1608X55N | LTST-C191KRKT | 2 | 0.56
32 | 10k_ohm | YAGEO (PHYCOMP) RC0603 F, 10k OHM, 0.1W | R1, R11 | RESC1608X55N | RC0603FR0710KL | 2 | 0.38
33 | 120R | Resistor | R2 | RCS1206_E3 | RCS1206120RFKEA | 1 | 0.44
34 | 52.3kR | SMD RES52.3K-1/16W-1%; 0402 | R3 | RES_RC0402_YAG | RC0402FR-0752K3L | 1 | 0.19
35 | 64.9kR | Description | R4, R9 | RC0603N_YAG | RC0603FR-0764K9L | 2 | 0.38
36 | 220R | Fixed Resistor CRGCQ 0603 220R5% | R5 | RESC1608X55N | CRGCQ0603J220R | 1 | 0.19
37 | 5.1kR | Resistor | R6, R7, R42 | RESC1608X55N | RC0603FR-075K1L | 3 | 0.57
38 | 100kR | D11/CRCW0603 100 100K1% ET1 e3 | R8 | RES_CRCW_0603_VIS | CRCW0603100KFKEA | 1 | 0.19
39 | 3362P-1-303LF | Resistor | R10, R17 | 3362P_1 | 3362P-1-303LF | 2 | 1.67
40 | 0R | Res Thick Film 0402 0 Ohm Epoxy Pad SMD T/R | R12, R13 | RESC1005X40N | RC0402JR070RL | 2 | 0.38
41 | 10k | YAGEO (PHYCOMP) RC0603 F, 10k OHM, 0.1W | R14, R15, R16, R19, R20, R21 | RESC1608X55N | RC0603FR0710KL | 6 | 1.14
42 | 1k | D11/CRCW0603 100 1K1% ET1 e3 | R44 | RES_CRCW_0603 | CRCW06031K00FKEA | 1 | 0.19
43 | PTS636SK25FSMTRLFS | PTS636 Series SPST-NO Off-Mom 250 gf top-actuated SMT tactile switch | SW1 | PTS636SK25FSMTRLFS | PTS636SK25FSMTRLFS | 1 | 0.52
44 | PH1-01-UA | Description | TP1 | CONN_PH1-01-UA_ADM | PH1-01-UA | 1 | 0.19
45 | STM32C552RET6 | Integrated Circuit | U1 | QFP50P1200X1200X160-64N | STM32C552RET6 | 1 | 4.84
46 | AP63203QWU-7 | Description | U2 | TSOT26_DIO | AP63203QWU-7 | 1 | 1.83
47 | 2171790001 | USB shielded I/O receptacle, Type C, right-angle, top mount, surface mount, single row, 16 circuits, gold plating | U3 | 2171790001_MOL | 2171790001 | 1 | 1.54
48 | LMR38020FSQDDARQ1 | Automotive SIMPLE SWITCHER power converter, 4.2V to 80V, 2A synchronous buck converter | U4 | SOIC127P600X170-9N | LMR38020FSQDDARQ1 | 1 | 8.45
49 | 3296W-1-253LF | Trimmer, cermet, 25k ohms, PCB, 25 turns, 0.5W | Bourns 3296W-1-253LF | VR1 | TRIM_3296W-1-253LF | 3296W-1-253LF | 1 | 4.58
50 | CS10820-24M | 24MHz +/-15ppm crystal, 6pF, 80 Ohms, 4-SMD, no lead, -40C to 125C | X1 | CS1082024M | CS10820-24M | 1 | 0.96
Total |  |  |  |  |  |  | 106.53
