mohanan02/Controller-Design-for-an-Autonomous-Vehicle-Hazard-Warning-and-Intent-Projection-System/SchematicPDF&ComponentList/MainController_Component_List_PDF_Order.xlsx

Main Controller Component List
Source | MainController_version2(1).pdf |  |  |  | Total component quantity | 101
PDF Order | Comment / Value | Description | Designator | Footprint | LibRef / Part Number | Quantity | Price
1 | 4.7uF | Multilayer Ceramic Capacitors MLCC - SMD/SMT | C1 | CAPC1608X90N | CL10A475KP8NNNC | 1 | 0.19
2 | 100nF | Samsung Electro-Mechanics CL05B104KO5NNNC 100nF Multilayer Ceramic Capacitor MLCC 16Vdc +/-10% Tolerance SMD | C2, C3, C4, C5, C7, C9, C14, C17, C18, C31, C32, C35, C36 | CAPC1005X55N | CL05B104KO5NNNC | 13 | 2.47
3 | 1uF | Samsung Electro-Mechanics 0402 (1005M) 1uF Multilayer Ceramic Capacitor MLCC 16Vdc +/-10% SMD CL05A105KO5NNNC | C6, C16 | CAPC1005X55N | CL05A105KO5NNNC | 2 | 0.19
4 | 2.2uF | Samsung Electro-Mechanics 0603 CL 2.2uF Ceramic Multilayer Capacitor, 10V, +85C, X5R Dielectric, +/-10% SMD | C8 | CAPC1608X90N | CL10A225KP8NNNC | 1 | 0.19
5 | 7pF | CAPCER7PF 50V C0G/NP0 0603 | C10, C11, C37 | CAPC1608X90N | CL10C070CB8NNNC | 3 | 0.57
6 | 4.7uF100V | SMD capacitor X7S(EIA) with capacitance 4.7uF Tol.20%. Rated voltage 100Vdc 125C | C12 | CAPC3216X190N | GRM31CC72A475ME11L | 1 | 1.39
7 | 100nF100V | Description | C13 | CAP_0603_WAL | 0603B104K101CT | 1 | 0.19
8 | 22uF25V | Capacitor | C15, C20 | CAPC3216X190N | TMK316BBJ226ML-T | 2 | 1.52
9 | 10uF | Capacitor | C19 | CAPC3216X180N | CL31A106MAHNNNE | 1 | 0.3
9 | 22uF10V | Capacitor | C21, C22 | GRM18x | GRM188R61A226ME1 5D | 2 | 0.6
10 | 0.1uF50V | Description | C25 | CAP_GCM1555_0402_MUR | GCM155R71H104KE02J | 1 | 0.19
11 | 1uF50V | SMD capacitor X5R(EIA) with capacitance 1.0uF Tol.20%. Rated voltage 50Vdc 85C | C26 | CAPC1005X60N | GRM155R61H105ME05D | 1 | 0.19
12 | 0.47uF | Description | C27 | CAP_GRM155_MUR | GRM155R61H474KE11D | 1 | 0.19
13 | 0.047uF50V | Description | C28 | CAP_CL10_SAM | CL10B473KB8NNNC | 1 | 0.19
14 | 10nF50V | SMD Comm X7R, Ceramic, 0.01uF, 10%, 50VDC, X7R, SMD, MLCC, Temperature Stable, Class II, 0603 | C29 | CAPC17595_87N_KEM | C0603C103K5RACTU | 1 | 0.19
15 | 1nF50V | Description | C30 | CAP_GRM_155_MUR | GRM1555C1H102JA01D | 1 | 0.19
16 | ESDZV5H | Ultra low clamping single line bidirectional ESD protection | D1 | ESDZV5H1BU2 | ESDZV5H-1BU2 | 1 | 0.35
17 | ESDCAN03-2BWY | TVS Diode (Uni-directional) | D2 | SOT65P210X110-3N | ESDCAN03-2BWY | 1 | 0.95
18 | ESDA25P35-1U1M | TVS Diode (Uni-directional) | D3 | ESDA25P351U1M | ESDA25P35-1U1M | 1 | 1
19 | ESDZV5H-1BU2 | Ultra low clamping single line bidirectional ESD protection | D4, D5, D6, D7 | ESDZV5H1BU2 | ESDZV5H-1BU2 | 4 | 1.4
20 | VS-30BQ015-M3_9AT | Schottky Diode | D8, D9 | DIOM7959X262N | VS-30BQ015-M3_9AT | 2 | 4.86
21 | RSX301LAM30TR | Schottky Diode | D10 | SODFL4725X105N | RSX301LAM30TR | 1 | 1.17
22 | SF-0603S080-2 | BOURNS SF-0603S080-2 - FUSE, 0.8A, 32V, 0603 | F1 | FUSC1608X55N | SF-0603S080-2 | 1 | 1.78
23 | TCAN3403DRQ1 | Integrated Circuit | IC1 | SOIC127P600X175-8N - duplicate | TCAN3403DRQ1 | 1 | 3.63
24 | 1776508 | PCB headers, nominal current: 12A, rated voltage (III/2): 320V, 2 positions, 5.08mm pitch, green, tin contacts, wave soldering | J1 | CONN_1776508 | 1776508 | 1
25 | TBP02P1W-381-04BE | header connector | J2 |  | TBP02P1W-381-04BE | 1 | 2.85
26 | TBP02R1W-381-03BE | Connector | J3 | RHDRRA3W80P0X381_1X3_2182X920X760P | TBP02R1W-381-03BE | 1 | 1.22
27 | BC020-02-A-0200-0300-L-G | Connector | J4, J5, J6 | BC02002A02000300LG | BC020-02-A-0200-0300-L-G | 3 | 2.16
28 | SFH11-NBPC-D03-ST-BK | Connector | J7 | SFH11NBPCD03STBK | SFH11-NBPC-D03-ST-BK | 1 | 1.17
29 | 47uH | Description | L1 | IND_PA4343PM4343_FP2_PUL | PM4343.473NLT | 1 | 2.72
30 | SRP4020TA-3R3M | Inductor | L2 | SRP4020TA3R3M | SRP4020TA-3R3M | 1 | 1.98
31 | Green | LED | LED1 | LEDC1608X90N | LTST-C190GKT | 1 | 0.26
32 | RED | LED | LED2, LED3 | LEDC1608X55N | LTST-C191KRKT | 2 | 0.56
33 | 10k_ohm | YAGEO (PHYCOMP) RC0603 F, 10k OHM, 0.1W | R1, R2 | RESC1608X55N | RC0603FR0710KL | 2 | 0.38
34 | 0R | Res Thick Film 0402 0 Ohm Epoxy Pad SMD T/R | R3, R4 | RESC1005X40N | RC0402JR070RL | 2 | 0.38
35 | 52.3kR | SMD RES52.3K-1/16W-1%;0402 | R5, R25 | RES_RC0402_YAG | RC0402FR-0752K3L | 2 | 0.38
36 | 100kR | D11/CRCW0603 100 100K1% ET1 e3 | R6 | RES_CRCW_0603_VIS | CRCW0603100KFKEA | 1 | 0.19
37 | 10k | YAGEO (PHYCOMP) RC0603 F | R9, R14, R15, R16, R17, R18, R19, R20, R21 | RESC1608X55N | RC0603FR0710KL | 9 | 0.46
38 | 1k | D11/CRCW0603 100 1K1% ET1 e3 | R10, R11, R12, R13, R29 | RES_CRCW_0603 | CRCW06031K00FKEA | 5 | 0.59
39 | 120R | Resistor | R22 | RCS1206_E3 | RCS1206120RFKEA | 1 | 0.44
40 | 5.1kR | Resistor | R23, R24 | RESC1608X55N | RC0603FR-075K1L | 2 | 0.38
41 | 64.9kR | Description | R26 | RC0603N_YAG | RC0603FR-0764K9L | 1 | 0.19
42 | 220R | Fixed Resistor CRGCQ 0603 220R5% | R27, R28 | RESC1608X55N | CRGCQ0603J220R | 2 | 0.38
43 | 47k | Resistor | R30, R31, R32, R33, R34 | RESC1005X40N | RC0402FR-0747KL | 5 | 0.95
44 | PTS636SK25FSMTRLFS | PTS636 Series SPST-NO Off-Mom 250 gf Top Actuated SMT Tactile Switch | SW1 | PTS636SK25FSMTRLFS | PTS636SK25FSMTRLFS | 1 | 0.52
45 | PH1-01-UA | Description | TP1 | CONN_PH1-01-UA_ADM | PH1-01-UA | 1 | 0.19
46 | STM32C552KET6 | Arm Cortex-M33 32-bit MCU with FPU, 144MHz, 593 CoreMark, up to 512Kbyte dual-bank flash memory, 128-Kbyte RAM | U1 | QFP80P900X900X160-32N | STM32C552KET6 | 1 | 4.43
47 | LMR38020FSQDDARQ1 | Automotive SIMPLE SWITCHER power converter, 4.2V to 80V, 2A synchronous buck converter | U2 | SOIC127P600X170-9N | LMR38020FSQDDARQ1 | 1 | 8.45
48 | AP63203QWU-7 | Description | U3 | TSOT26_DIO | AP63203QWU-7 | 1 | 1.83
49 | L6374FP | Industrial quad line driver | U5 | SO-20_STM | L6374FP | 1 | 18.33
50 | ACPL-K64L-000E | Description | U8, U9 | STRETCHED_SO-8_AVA | ACPL-K64L-000E | 2 | 22.72
51 | BMI323 | Integrated Circuit | U11 | BMI323 | BMI323 | 1 | 6.84
52 | 2171790001 | USB shielded I/O receptacle, Type C, right-angle, top mount, surface mount, single row, 16 circuits, gold plating | U12 | 2171790001_MOL | 2171790001 | 1 | 1.54
53 | 3296W-1-472LF | 3296W top-adjust cermet trimmer 4K7 10%, PCB, 25 turns, 0.5W | VR1 | TRIM_3296W-1-472LF | 3296W-1-472LF | 1 | 4.85
54 | CS10820-24M | 24MHz +/-15ppm crystal, 6pF, 80 Ohms, 4-SMD, no lead, -40C to 125C | X1 | CS1082024M | CS10820-24M | 1 | 0.96
Total |  |  |  |  |  |  | 112.19
