mohanan02/Controller-Design-for-an-Autonomous-Vehicle-Hazard-Warning-and-Intent-Projection-System/MainController(LidarInterface)/ecad_model/CL05A105KO5NNNC(1uf16VCap)/3D/CL05A105KO5NNNC.stp

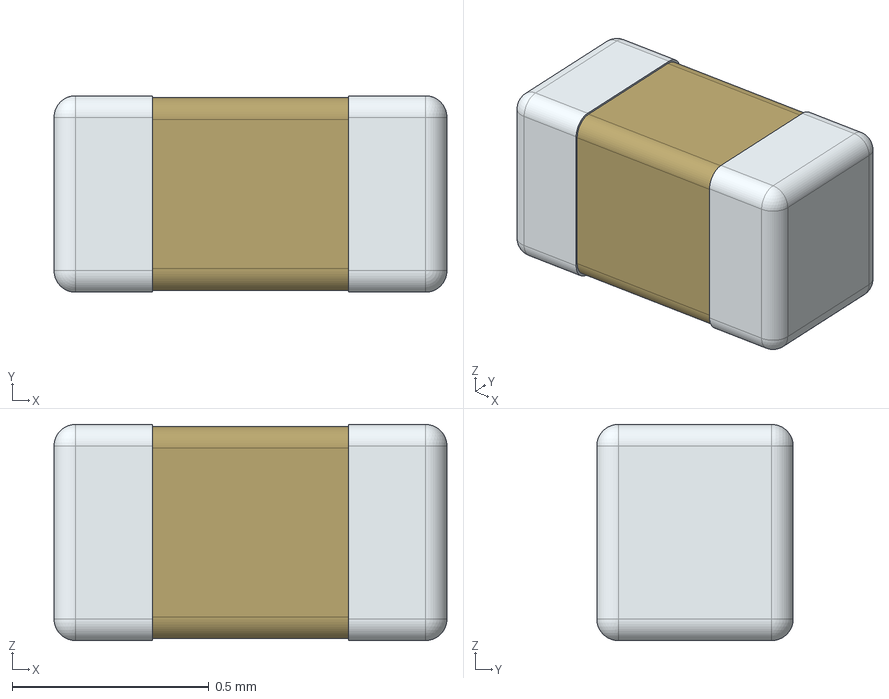
[picture p35: CAD file, 2026-11-09]
MainController(LidarInterface)/ecad_model/CL05A105KO5NNNC(1uf16VCap)/3D/CL05A105KO5NNNC.stp
1.00 x 0.5 x 0.55 mm
