mohanan02/Controller-Design-for-an-Autonomous-Vehicle-Hazard-Warning-and-Intent-Projection-System/MainController(LidarInterface)/ecad_model/LIB_STM32C552KET6/STM32C552KET6/3D/STM32C552KET6.stp

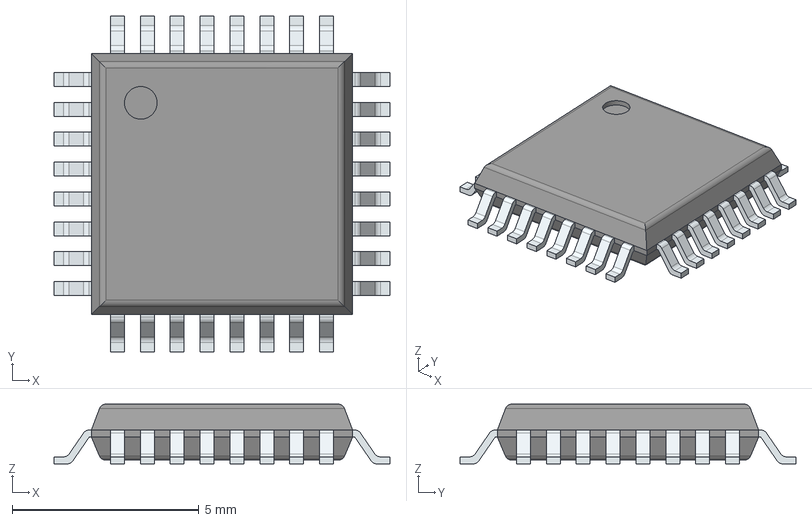
[picture p36: CAD file, 2026-11-09]
MainController(LidarInterface)/ecad_model/LIB_STM32C552KET6/STM32C552KET6/3D/STM32C552KET6.stp
9.00 x 9.00 x 1.60 mm
PinsArrayLR
PinsArrayTB
