mohanan02/Controller-Design-for-an-Autonomous-Vehicle-Hazard-Warning-and-Intent-Projection-System/(list of files, cad)

Other CAD files:
MainController(LidarInterface)/ecad_model/CL05A105KO5NNNC(1uf16VCap)/Allegro/capc1005x55n.psm
MainController(LidarInterface)/ecad_model/CL05A105KO5NNNC(1uf16VCap)/DEHDL/cl05a105ko5nnnc/chips/chips.prt
MainController(LidarInterface)/ecad_model/LIB_STM32C552KET6/STM32C552KET6/Allegro/qfp80p900x900x160-32n.psm
MainController(LidarInterface)/ecad_model/LIB_STM32C552KET6/STM32C552KET6/DEHDL/stm32c552ket6/chips/chips.prt
MainController(LidarInterface)/ecad_model/TCAN1044AVDRQ1/Allegro/soic127p600x175-8n.psm
MainController(LidarInterface)/ecad_model/TCAN1044AVDRQ1/DEHDL/tcan1044avdrq1/chips/chips.prt
