mohanan02/Controller-Design-for-an-Autonomous-Vehicle-Hazard-Warning-and-Intent-Projection-System/Frount_Mount_Controller_simplified/FrontMountCOntrol.pdf

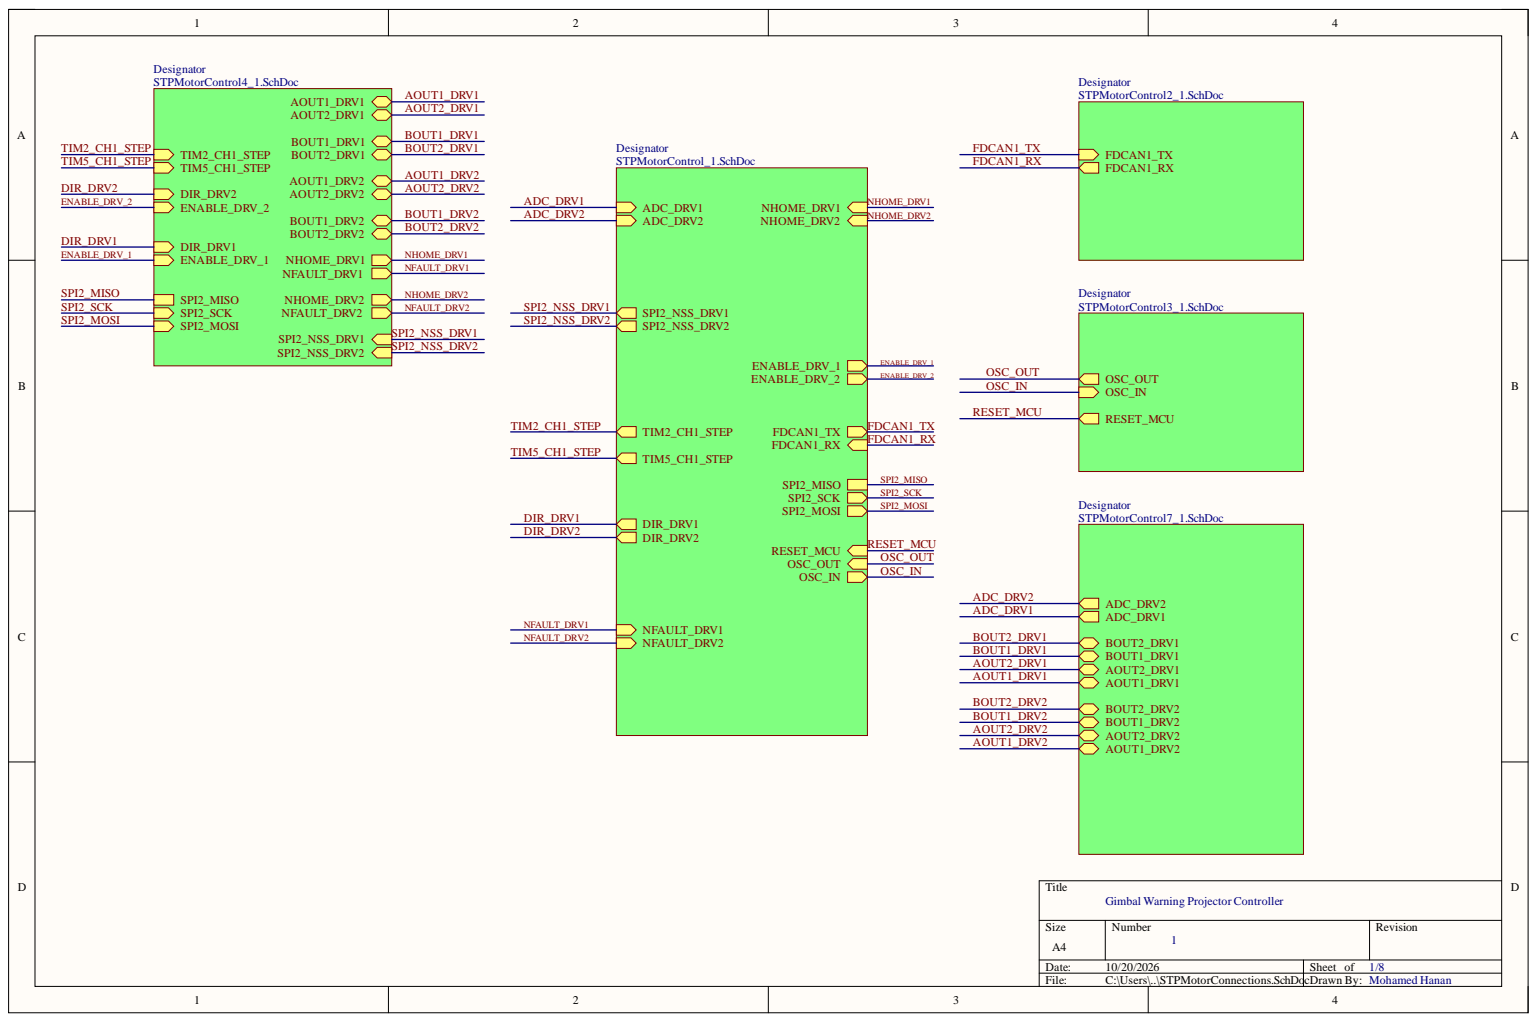
[picture p38: page 1]

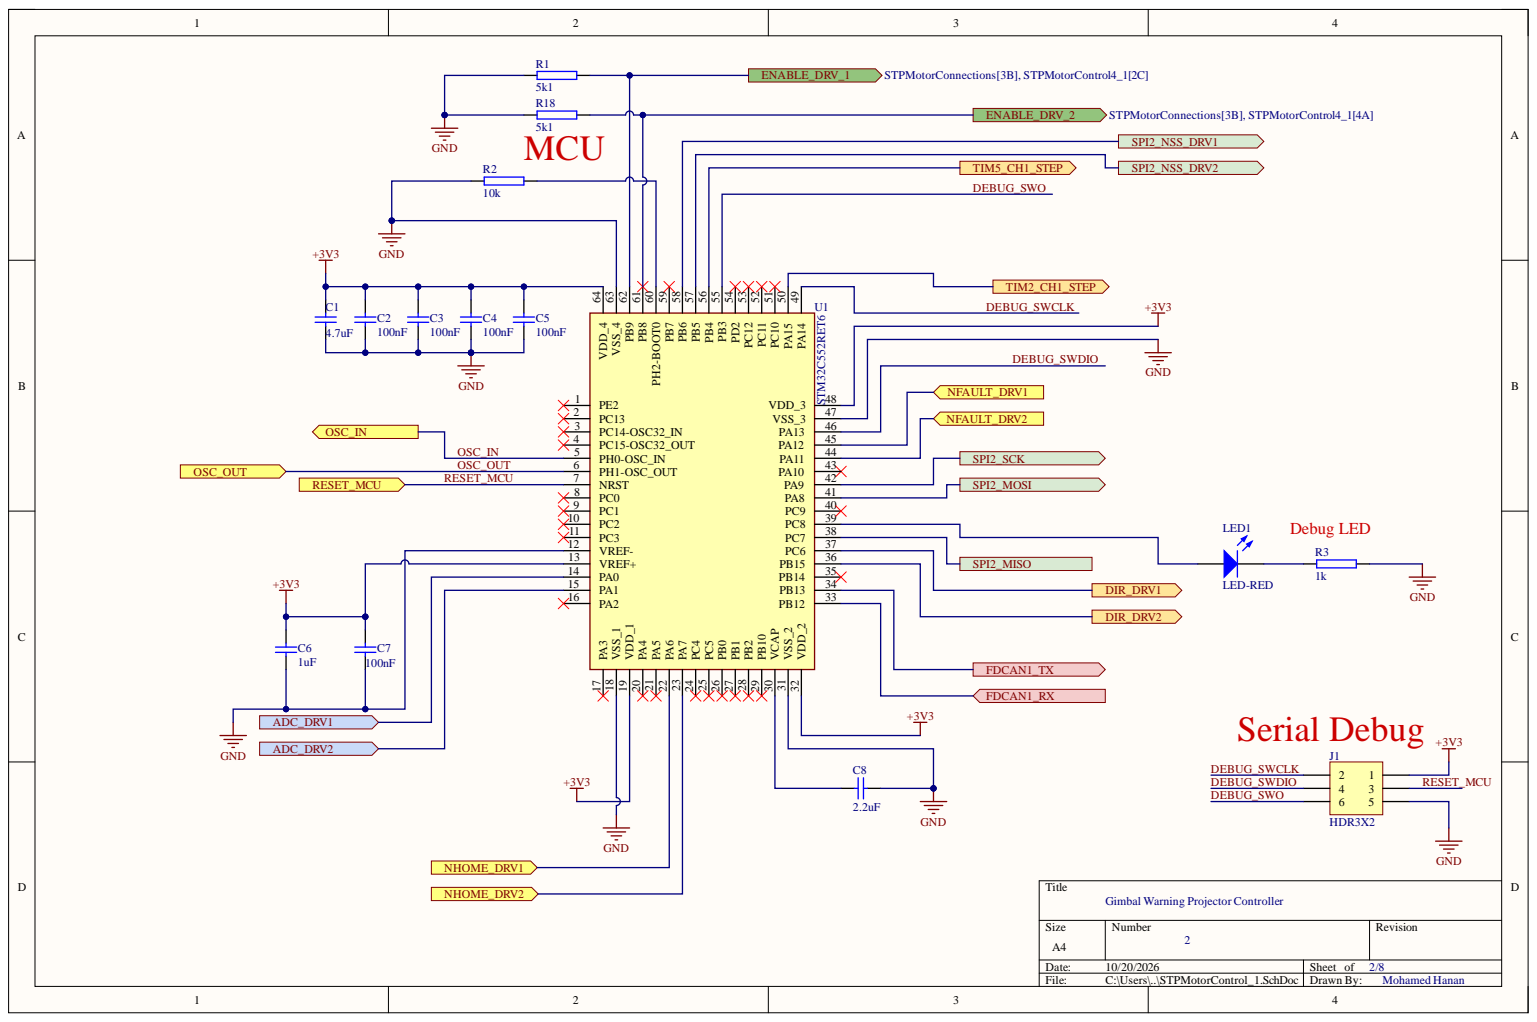
[picture p39: page 2]

U1 DEBUG_SWCLK

PE2 1
PC13 2 | | NFAULT_DRV2

OSC_IN | PC15-OSC32_OUT 4

Gimbal Warning Projector Controller

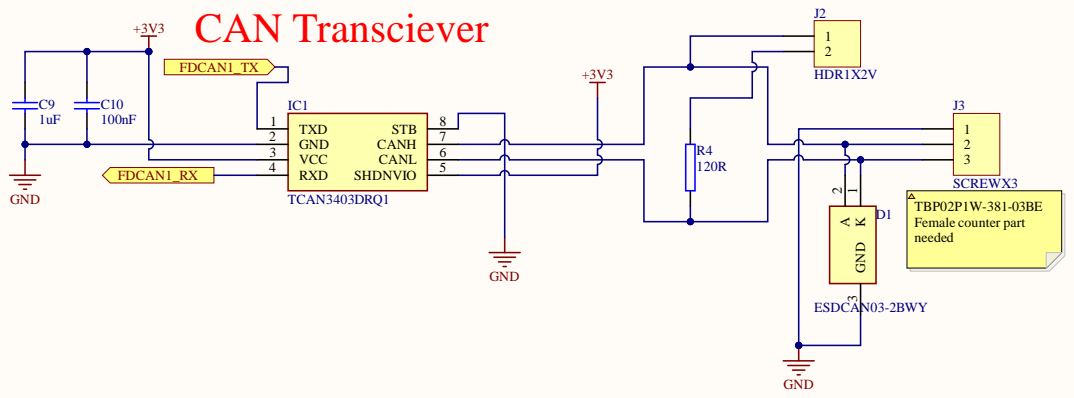
[picture p40: page 3]

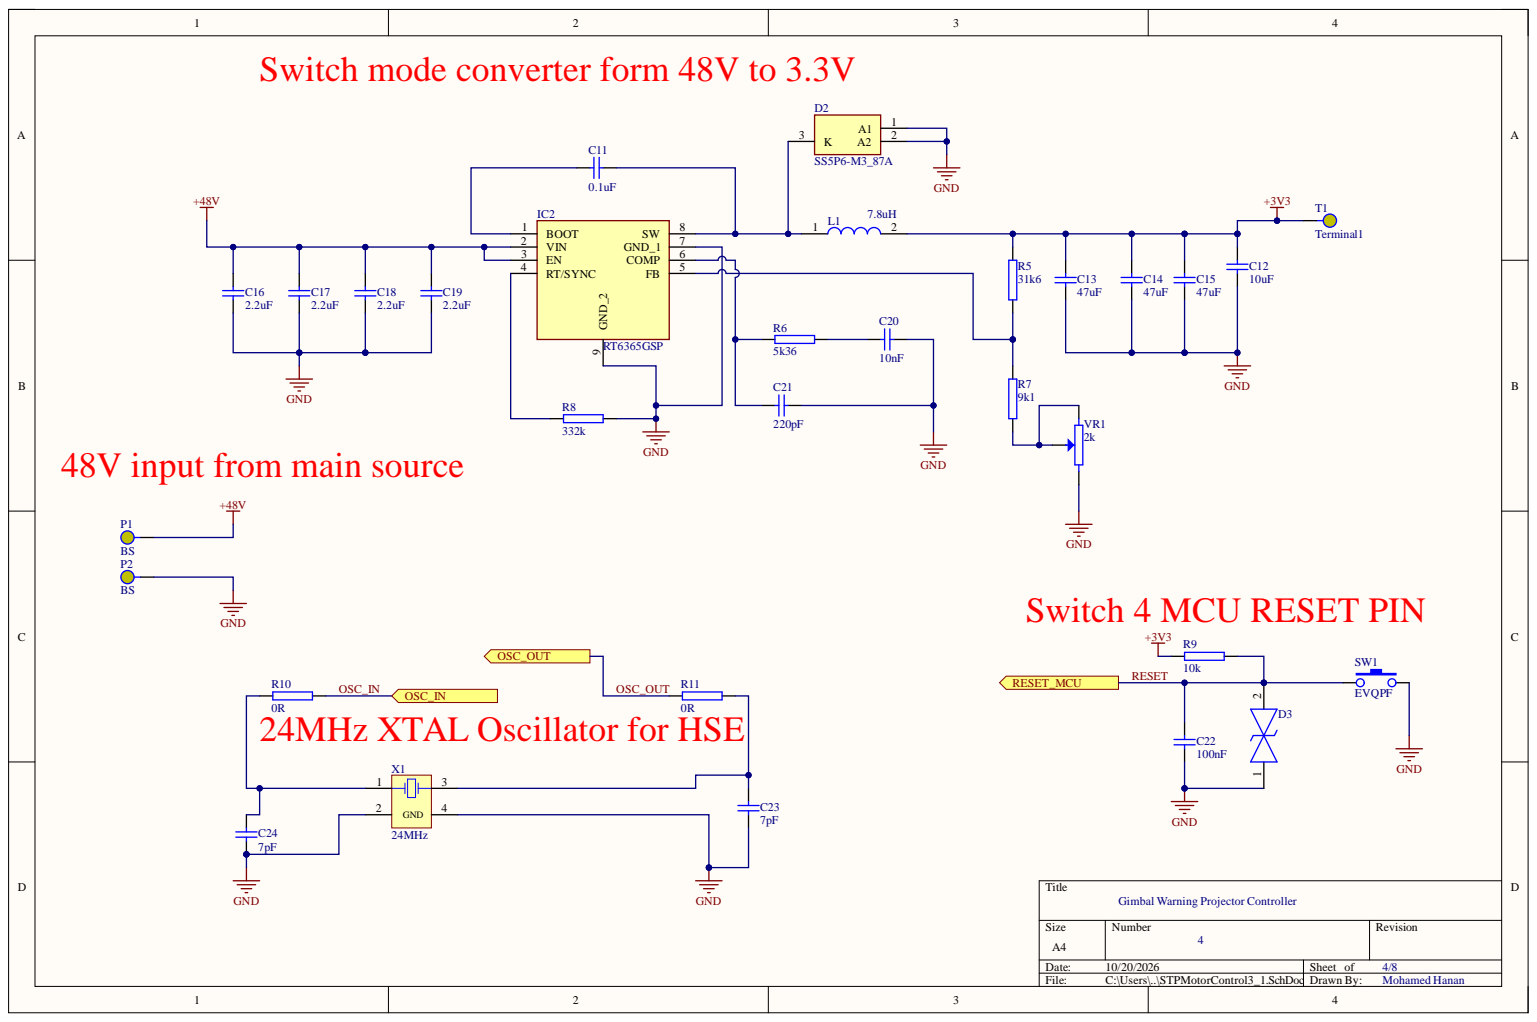
[picture p41: page 4]

Switch mode converter form 48V to 3.3V

R8 | RT6365GSP | | 10nF

48V input from main source

GND
Switch 4 MCU RESET PIN

24MHz XTAL Oscillator for HSE

Gimbal Warning Projector Controller

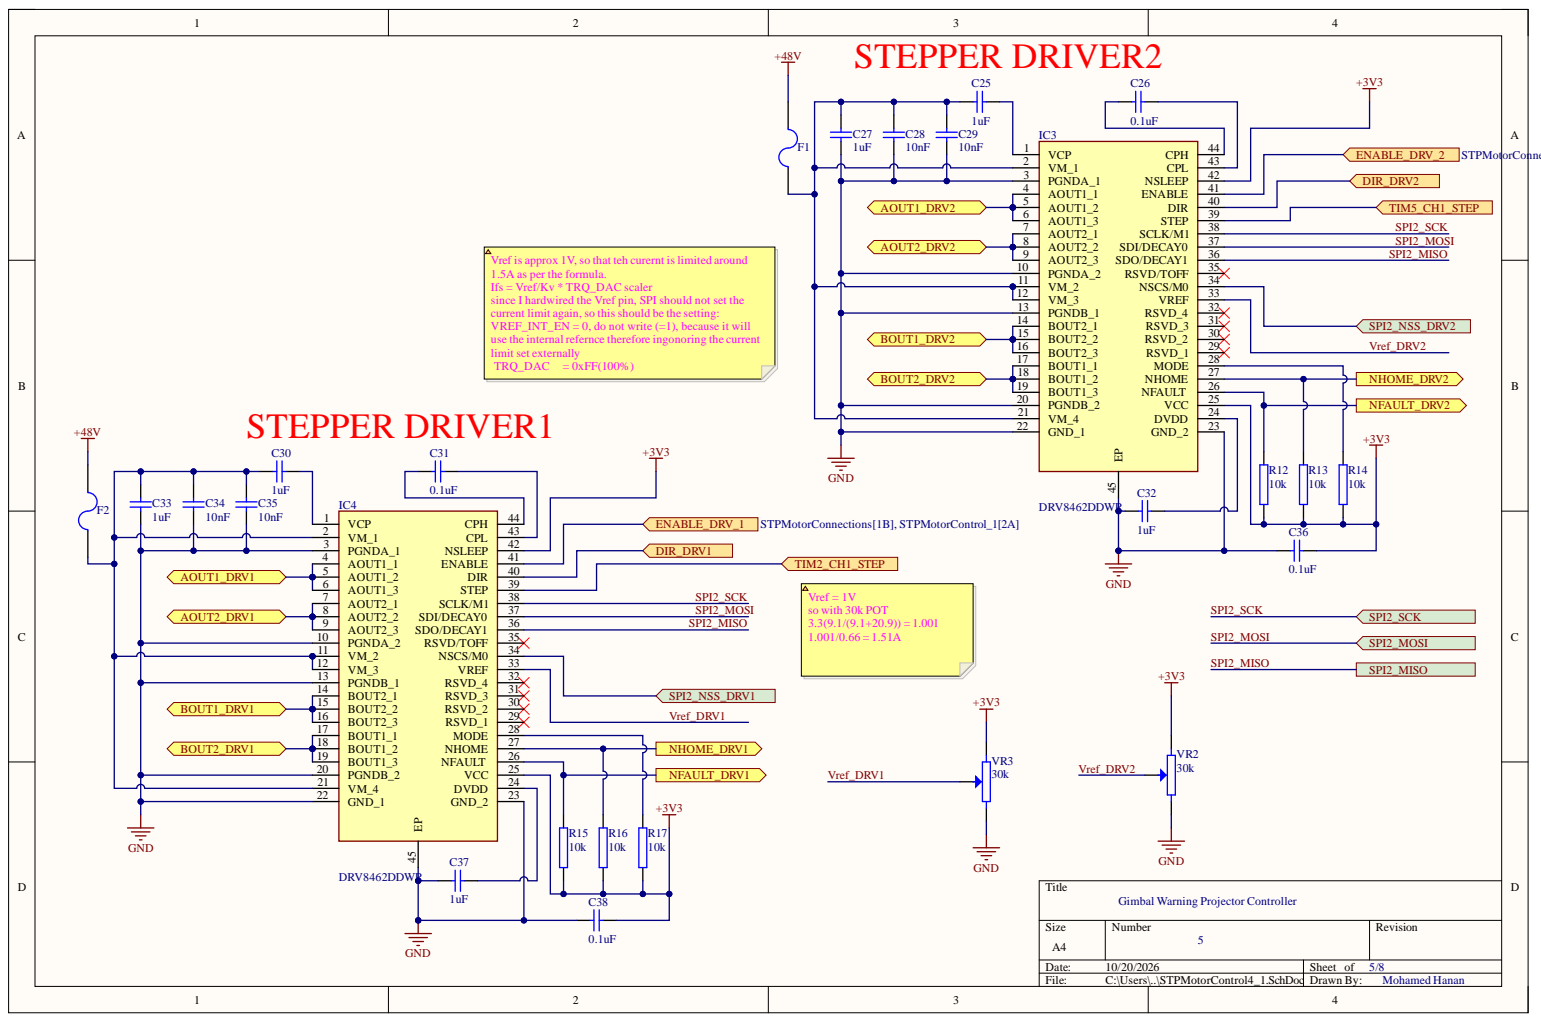
[picture p42: page 5]

VCP 1

Vref is approx 1V, so that teh curernt is limited around
1.5A as per the formula.
Ifs = Vref/Kv * TRQ_DAC scaler
since I hardwired the Vref pin, SPI should not set the
current limit again, so this should be the setting:
VREF_INT_EN = 0, do not write (=1), because it will
use the internal refernce therefore ingonoring the current
limit set externally

Gimbal Warning Projector Controller

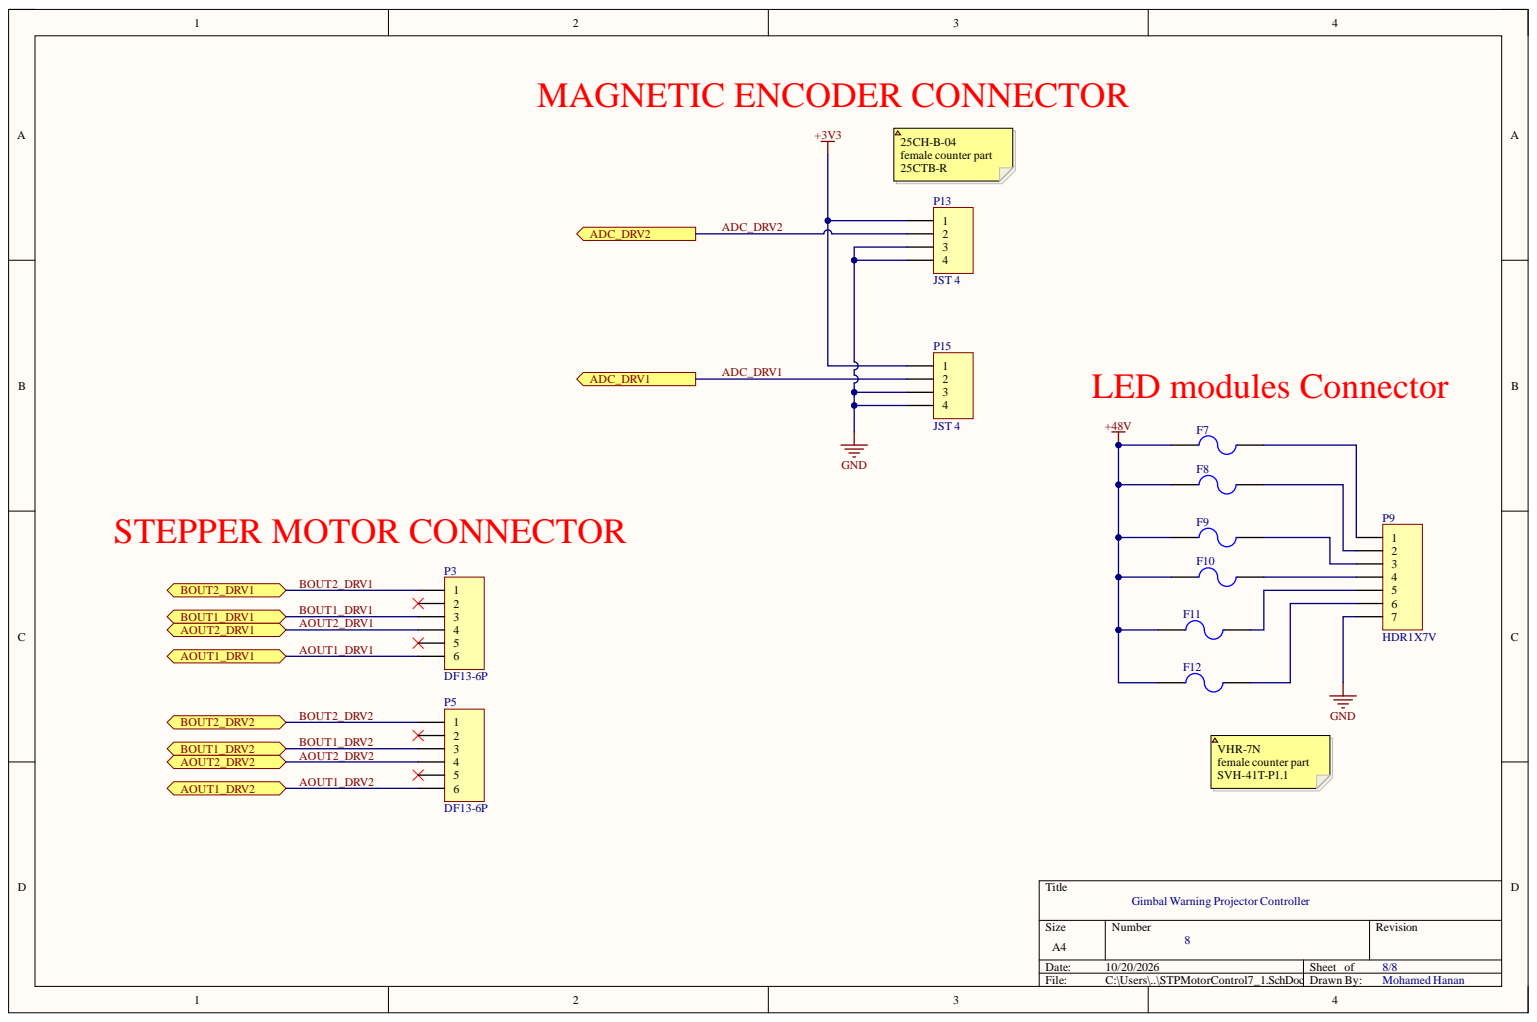
[picture p43: page 6]

Gimbal Warning Projector Controller

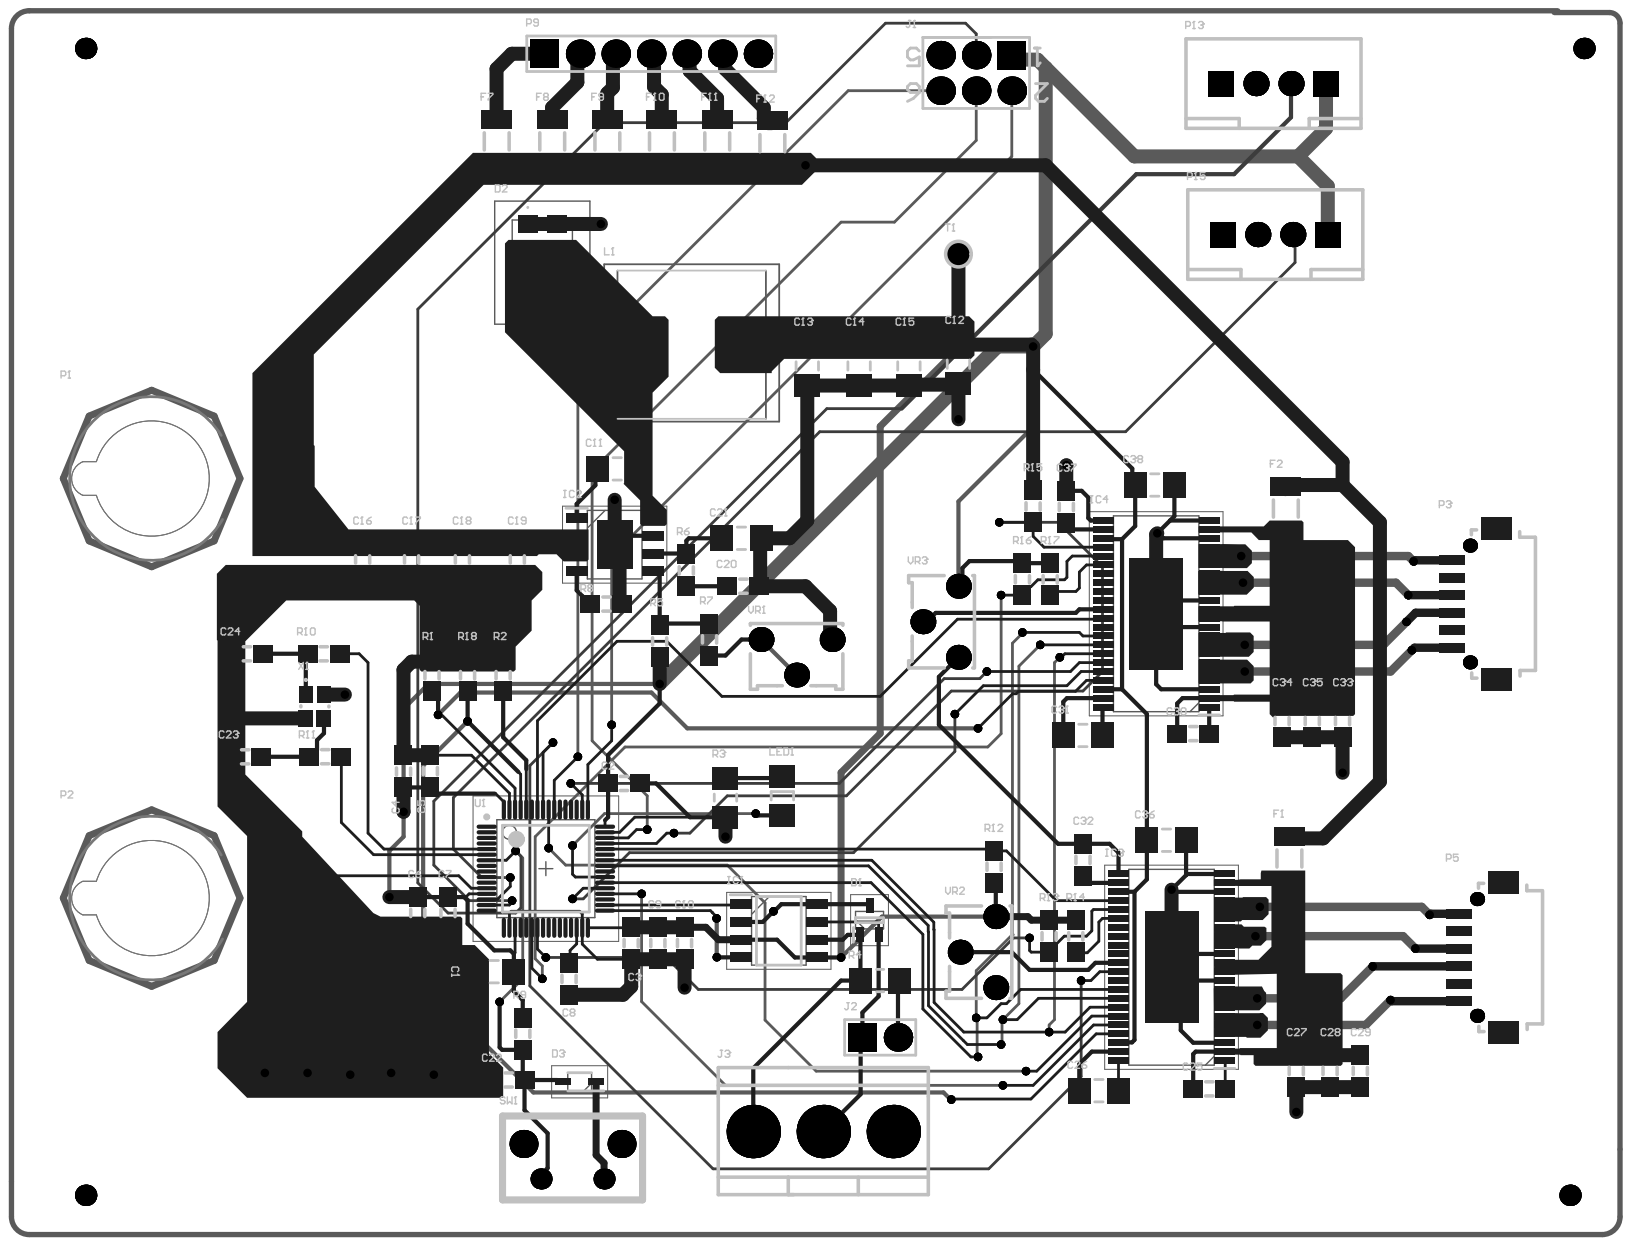
[picture p44: page 7]

Comment | Description | Designator | Footprint | LibRef | Quantity
4.7uF | NonPolarized Capacitor, SMD, 1206 | C1 | CAP_1206 | CAPN1206 | 1
100nF | NonPolarized Capacitor, SMD, 0805 | C2, C3, C4, C5, C7, C10, C22 | CAP_0805 | CAPN0805 | 7
1uF | NonPolarized Capacitor, SMD, 0805 | C6, C9, C25, C27, C30, C32, C33, C37 | CAP_0805 | CAPN0805 | 8
2.2uF | NonPolarized Capacitor, SMD, 0805 | C8, C16, C17, C18, C19 | CAP_0805 | CAPN0805 | 5
0.1uF | NonPolarized Capacitor, SMD, 1206 | C11, C26, C31, C36, C38 | CAP_1206 | CAPN1206 | 5
10uF | NonPolarized Capacitor, SMD, 1206 | C12 | CAP_1206 | CAPN1206 | 1
47uF | NonPolarized Capacitor, SMD, 1206 | C13, C14, C15 | CAP_1206 | CAPN1206 | 3
10nF | NonPolarized Capacitor, SMD, 0805 | C20, C28, C29, C34, C35 | CAP_0805 | CAPN0805 | 5
220pF | NonPolarized Capacitor, SMD, 1206 | C21 | CAP_1206 | CAPN1206 | 1
7pF | NonPolarized Capacitor, SMD, 0805 | C23, C24 | CAP_0805 | CAPN0805 | 2
ESDCAN03-2BWY | TVSDiode(Uni-directional) | D1 | SOT65P210X110-3N | ESDCAN03-2BWY | 1
SS5P6-M3_87A | SchottkyDiode | D2 | SS5P6M387A | SS5P6-M3_87A | 1
TSD05CDYFR | TVSDiode(Bi-directional) | D3 | SOD2613X100N | TSD05CDYFR | 1
1206L035/16YR | Fuse, PTCReset, 350mAHold, 750mA Tripping, 16v | F1, F2, F7, F8, F9, F10, F11, F12 | MC36207 | 1206L035/16YR | 8
TCAN3403DRQ1 | IntegratedCircuit | IC1 | SOIC127P600X175-8N | TCAN3403DRQ1 | 1
RT6365GSP | IntegratedCircuit | IC2 | SOIC127P600X175-9N | RT6365GSP | 1
DRV8462DDWR | IntegratedCircuit | IC3, IC4 | SOP64P810X120-45N | DRV8462DDWR | 2
HDR3X2 | Header, 3-Pin, Dual row, 2.54mmPitch, Straight | J1 | HDR2X3_AUT | HDR3X2 | 1
HDR1X2V | Header, Plug, 2.54mm, 2Pins, Straight | J2 | HDR1X2_AUT | HDR1X2V | 1
SCREWX3 | Terminal Block, PCB, 3Way, Pitch5mm | J3 | SCREW3_AUT | SCREWX3 | 1
7.8uH | Inductor | L1 | WE-HCI_103023 | 744325780 | 1
LED-RED | REDLED, Case1206 | LED1 | LED1206R | SMD1206LED-RED | 1
BS | BananaSocket, 4mm, Panel, Black, 10A | P1, P2 | Banana_AUT | BananaSocket | 2
DF13-6P | HIROSE(HRS) DF13-6P-1.25H(20) Wire-To-BoardConnector, Right Angle, DF13 Series, SurfaceMount, Header, 6Contacts, 1.25mm | P3, P5 | DF13-6 | DF13-6P | 2
HDR1X7V | Header, Plug, 2.54mm, 7Pins, Straight | P9 | HDR1X7_AUT | HDR1X7V | 1
JST4 | JSTXAHeader, 4-Pin, Pitch2.5mm | P13, P15 | XA-4 | JSTXAHeader 4 | 2
5k1 | Resistor, SMD, 0805 | R1, R18 | RES_0805 | Resistor 0805 | 2
10k | Resistor, SMD, 0805 | R2, R9, R12, R13, R14, R15, R16, R17 | RES_0805 | Resistor 0805 | 8
1k | Resistor, SMD, 1206 | R3 | RES_1206 | Resistor 1206 | 1
120R | Resistor, SMD, 1206 | R4 | RES_1206 | Resistor 1206 | 1
31k6 | Resistor, SMD, 0805 | R5 | RES_0805 | Resistor 0805 | 1
5k36 | Resistor, SMD, 0805 | R6 | RES_0805 | Resistor 0805 | 1
9k1 | Resistor, SMD, 0805 | R7 | RES_0805 | Resistor 0805 | 1
332k | Resistor, SMD, 0805 | R8 | RES_0805 | Resistor 0805 | 1
0R | Resistor, SMD, 0805 | R10, R11 | RES_0805 | Resistor 0805 | 2
EVQPF | PANASONIC EVQPF203M SWITCH, TACTILE, SPST-NO, 20mA, 15VDC | SW1 | EVQPF203M | EVQPF | 1
Terminal1 | Terminal, Pad 70x70mil, Hole32mil | T1 | PAD1_AUT | Terminal1 | 1
STM32C552RET6 | IntegratedCircuit | U1 | LQFP40P900X900X14 5-64N | STM32C552RET6 | 1
2k | 3362SSeries, 1/4” Square Potentiometer, 2k, 10%, 0.5Watts, 1Turn | VR1 | 3362S | 3362S-1-202LF | 1
30k | 3362SSeries, 1/4” Square Potentiometer, 2k, 10%, 0.5Watts, 1Turn | VR2, VR3 | 3362S | 3362S-1-202LF | 2
24MHz | Crystals, 24MHz | X1 | CX2520SB | CX2520SB24000D0FLJ ZZ | 1
