mohanan02/Controller-Design-for-an-Autonomous-Vehicle-Hazard-Warning-and-Intent-Projection-System/Frount_Mount_Controller_simplified/STPMotorControl_1.pdf

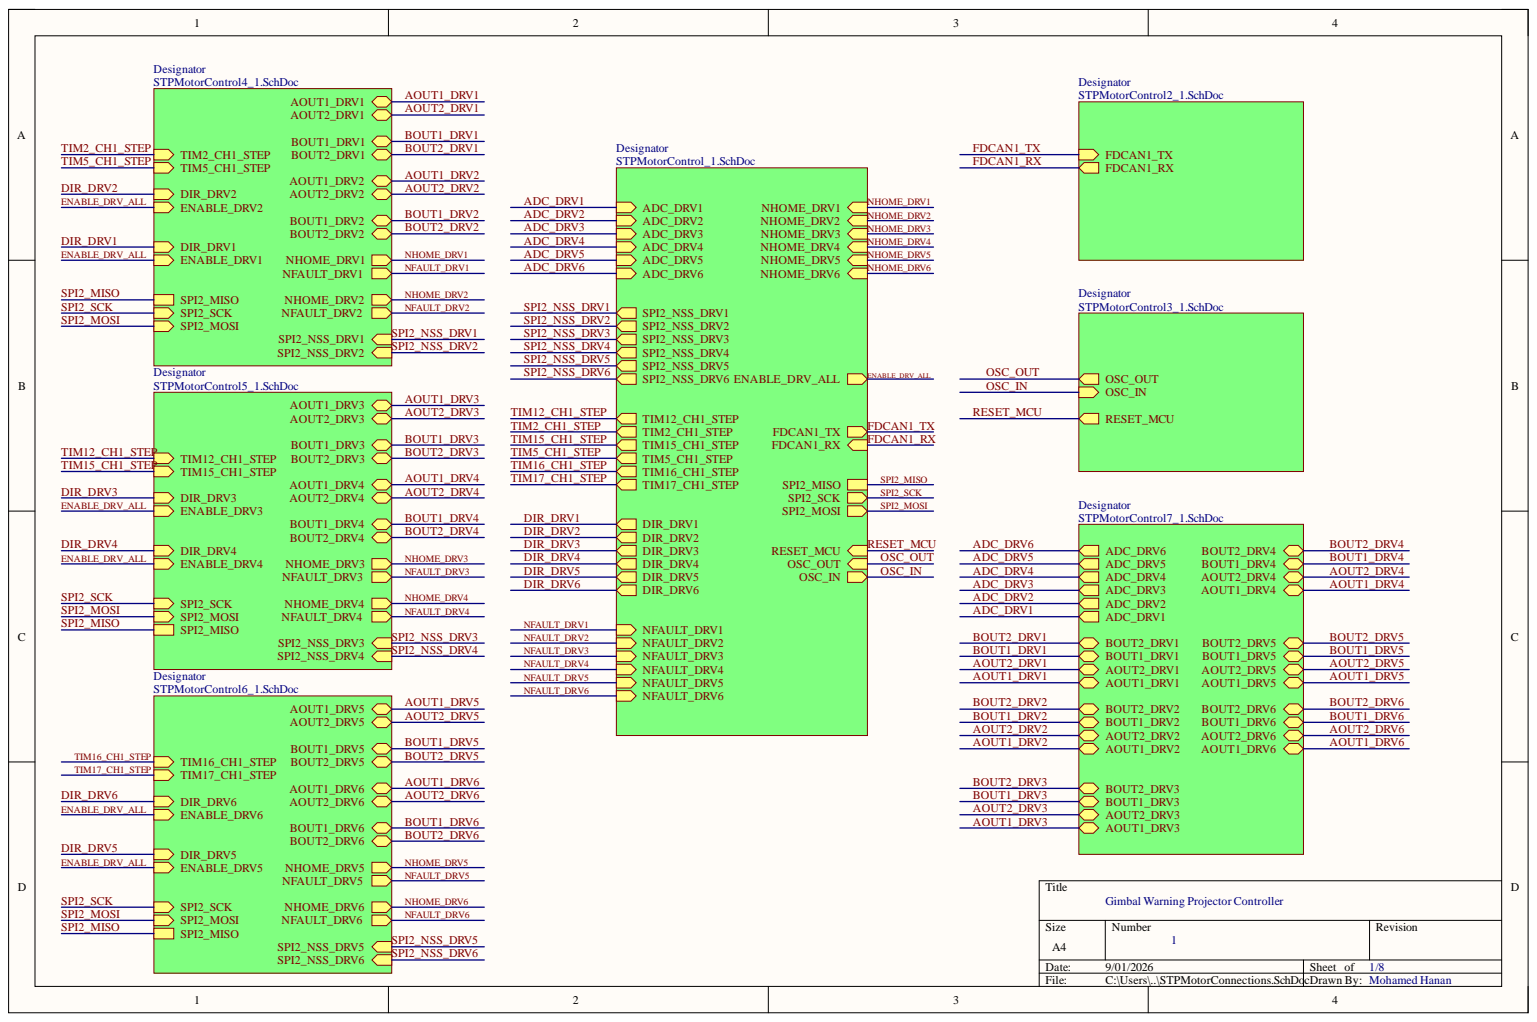
[picture p45: page 1]

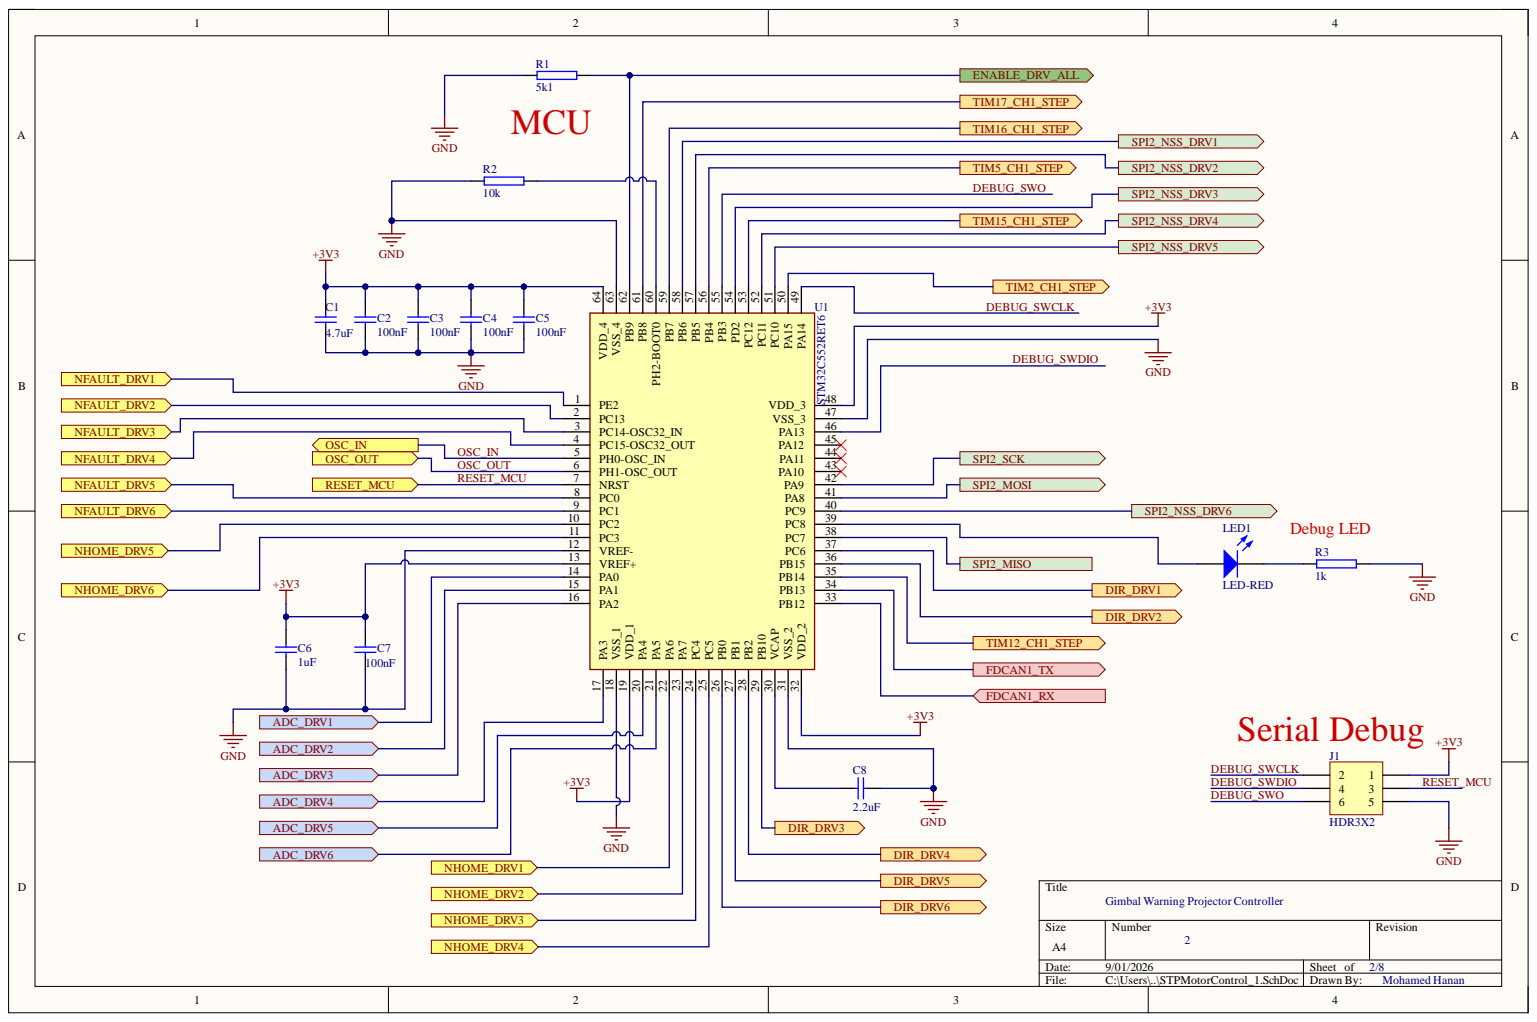
[picture p46: page 2]

TIM5_CH1_STEP DEBUG_SWO

TIM15_CH1_STEP

U1 DEBUG_SWCLK

PC14-OSC32_IN 3

OSC_IN | PH0-OSC_IN 5
OSC_OUT | PH1-OSC_OUT 6

PC2 10
PC3 11
VREF- 12
VREF+ 13
PA0 14
PA1 15
PA2 16

Gimbal Warning Projector Controller

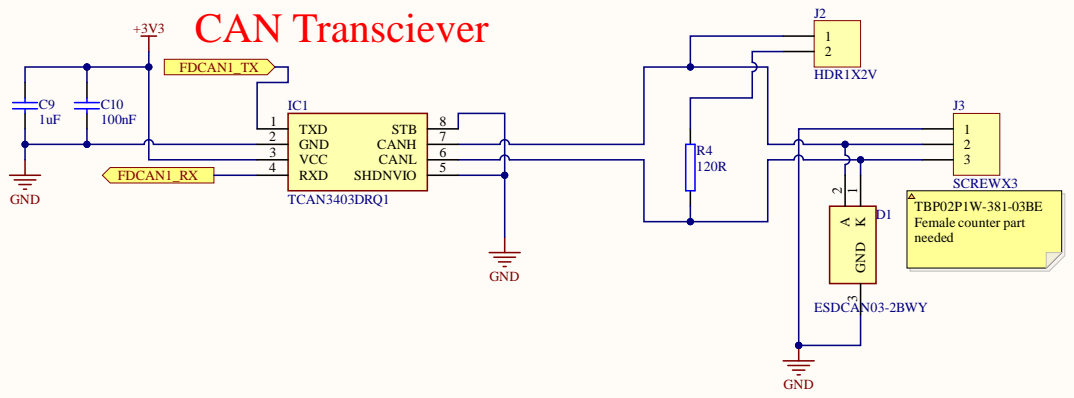
[picture p47: page 3]

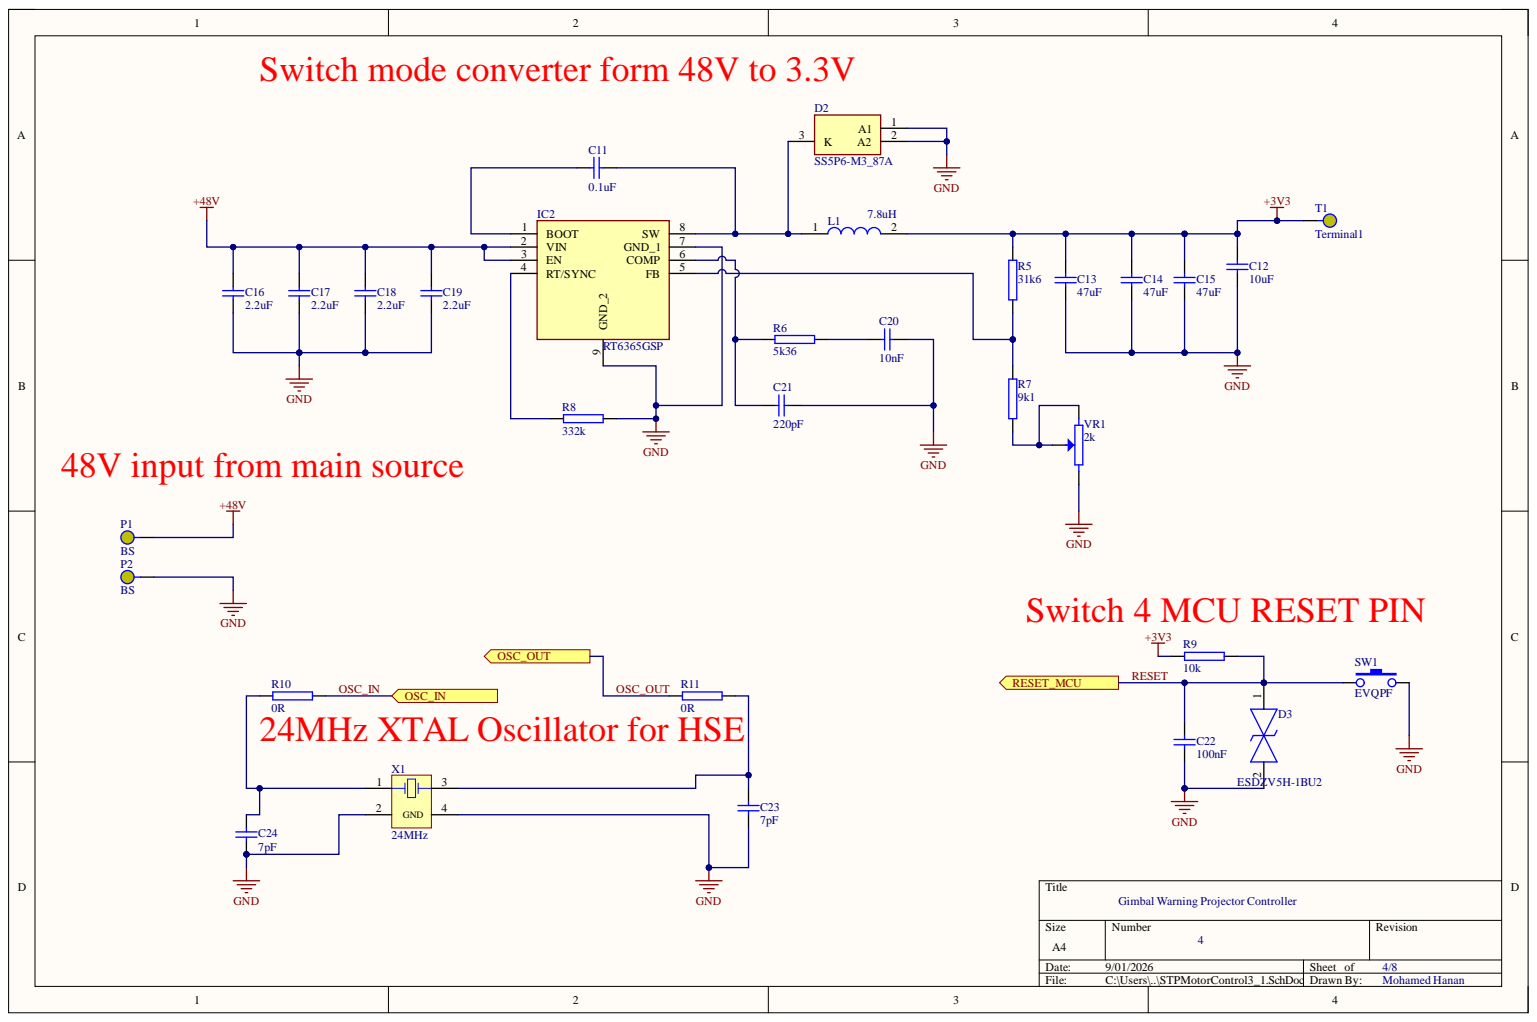
[picture p48: page 4]

Switch mode converter form 48V to 3.3V

R8 | RT6365GSP | | 10nF

48V input from main source

GND
Switch 4 MCU RESET PIN

24MHz XTAL Oscillator for HSE

Gimbal Warning Projector Controller

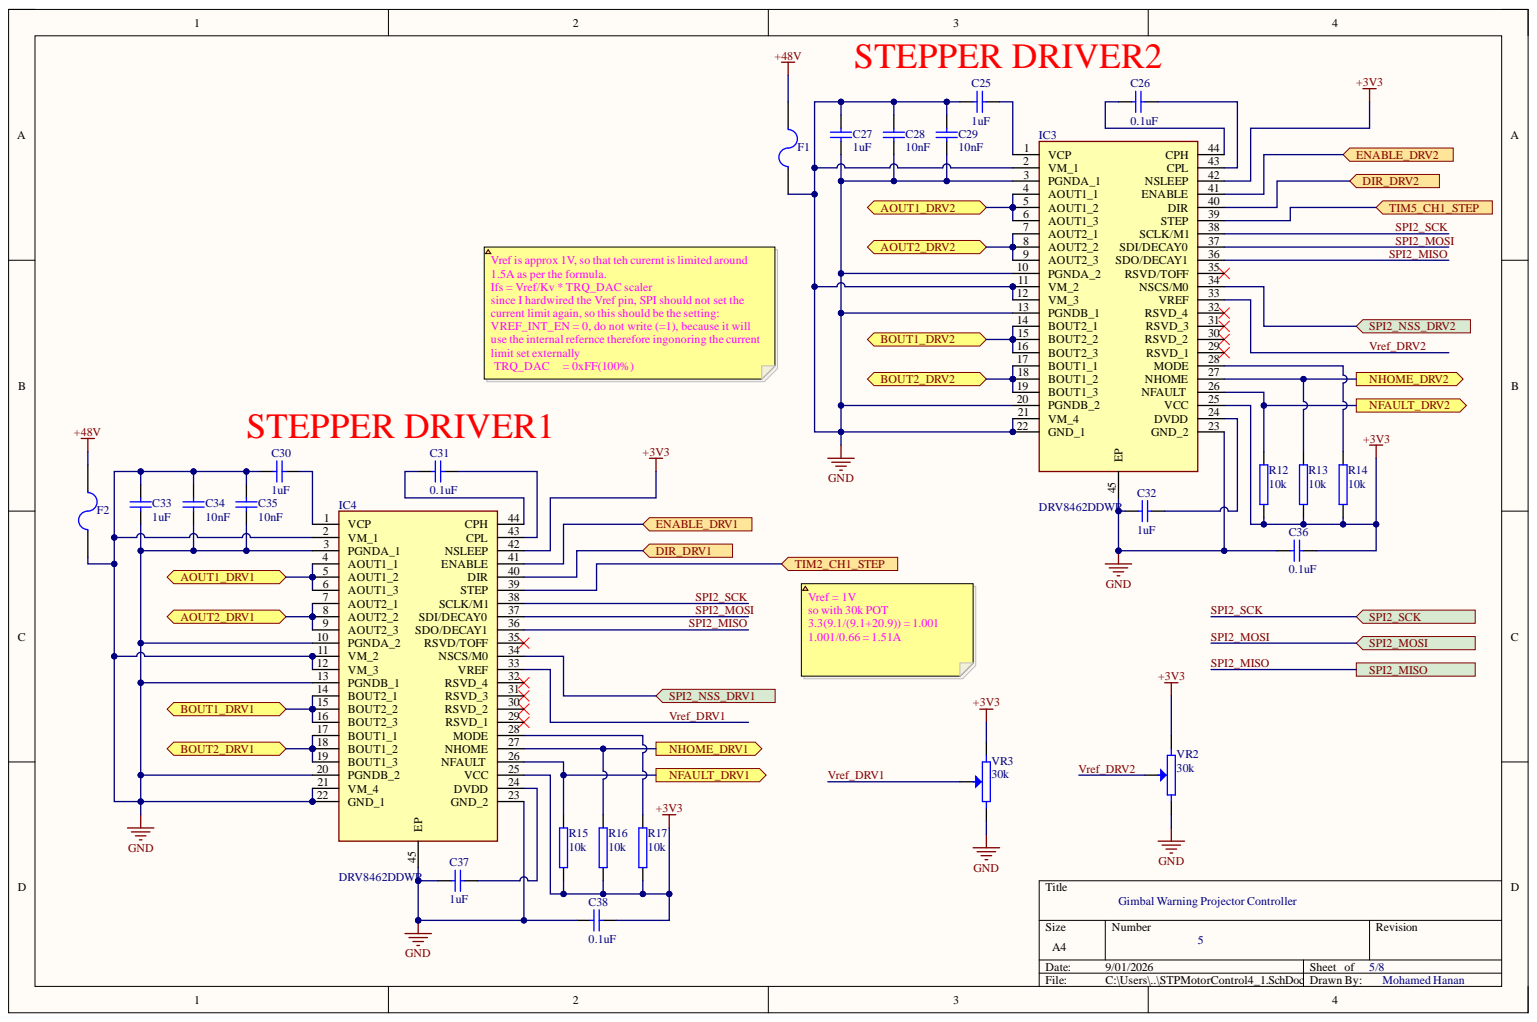
[picture p49: page 5]

VCP 1

Vref is approx 1V, so that teh curernt is limited around
1.5A as per the formula.
Ifs = Vref/Kv * TRQ_DAC scaler
since I hardwired the Vref pin, SPI should not set the
current limit again, so this should be the setting:
VREF_INT_EN = 0, do not write (=1), because it will
use the internal refernce therefore ingonoring the current
limit set externally

Gimbal Warning Projector Controller

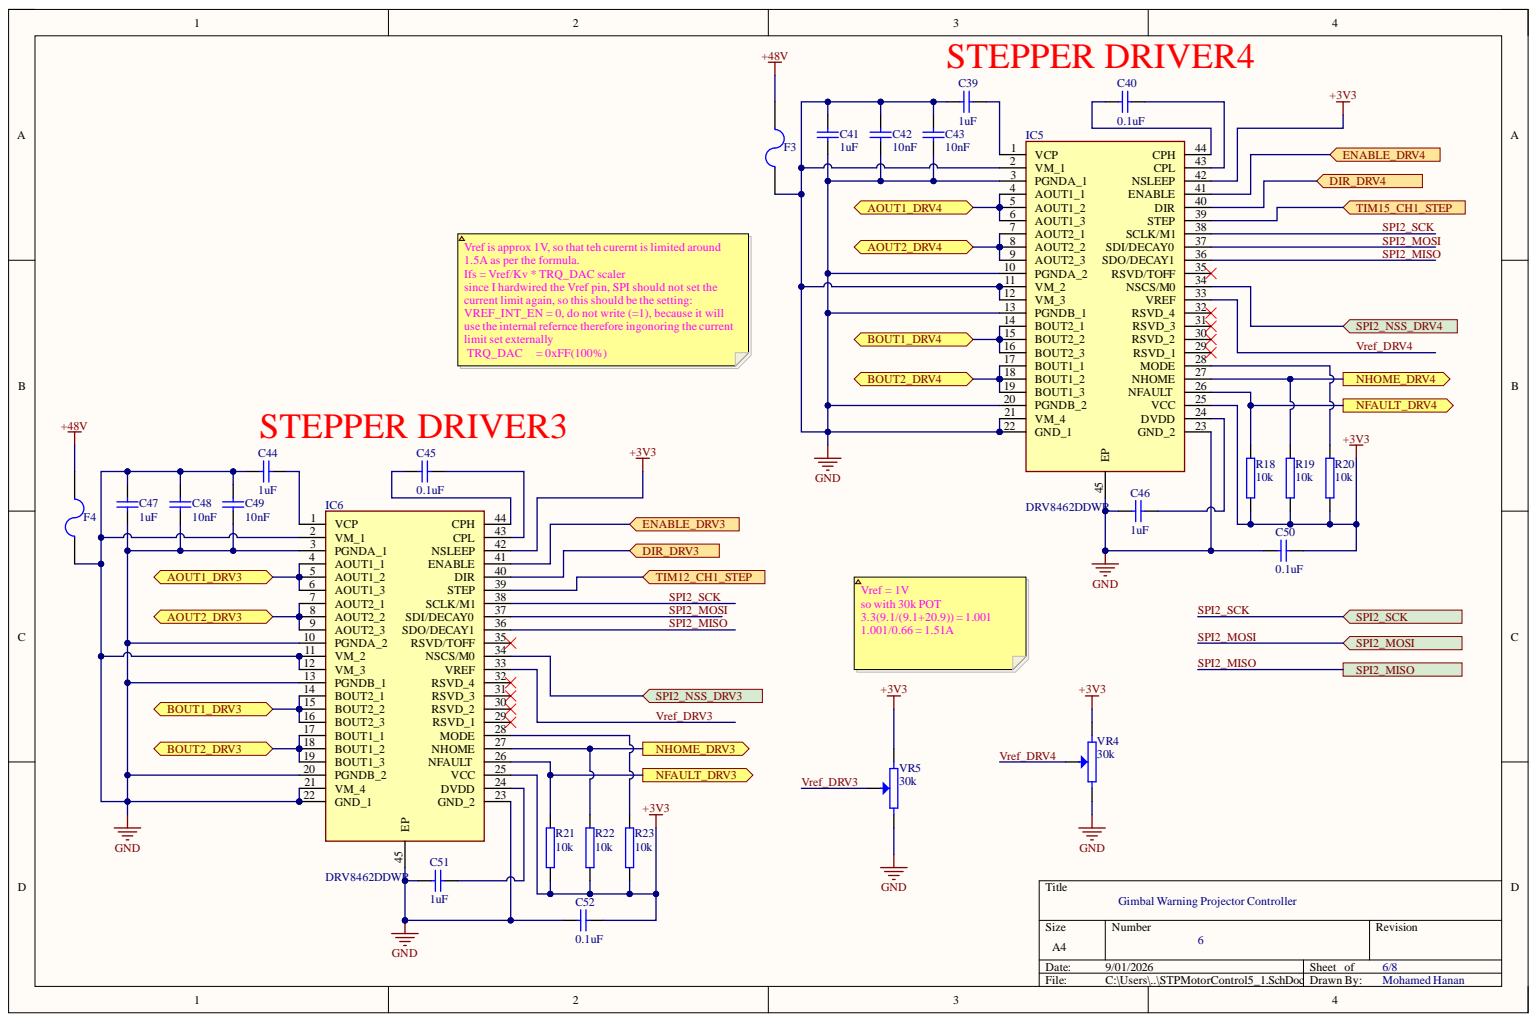
[picture p50: page 6]

VCP 1

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

Gimbal Warning Projector Controller

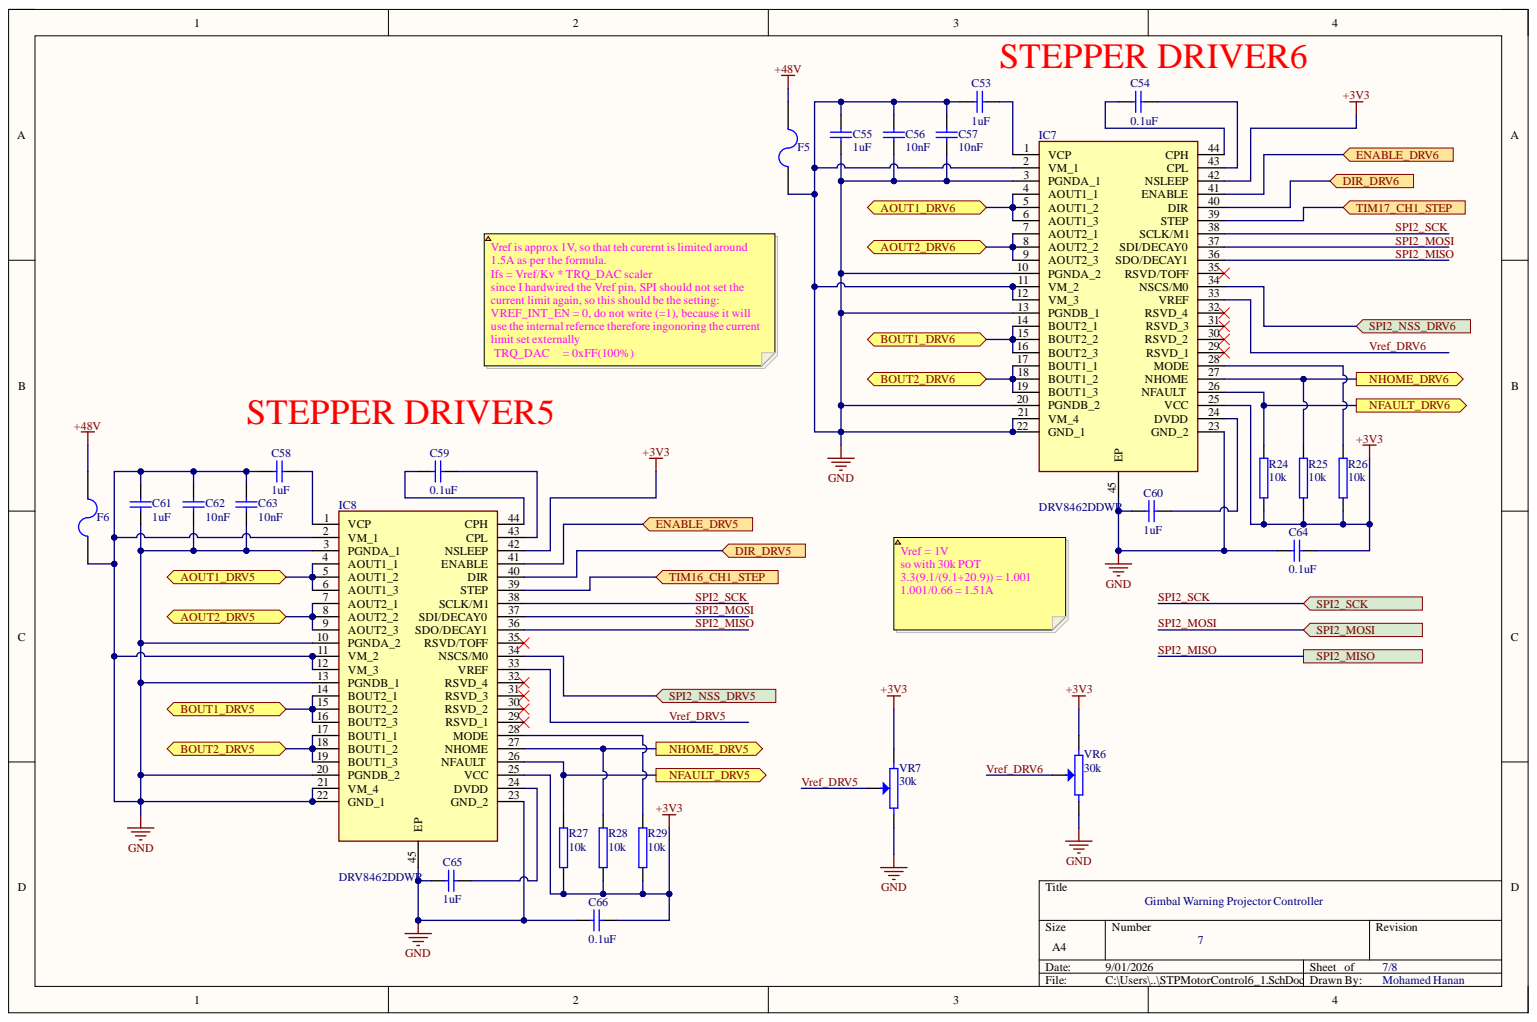
[picture p51: page 7]

VCP 1

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

Gimbal Warning Projector Controller

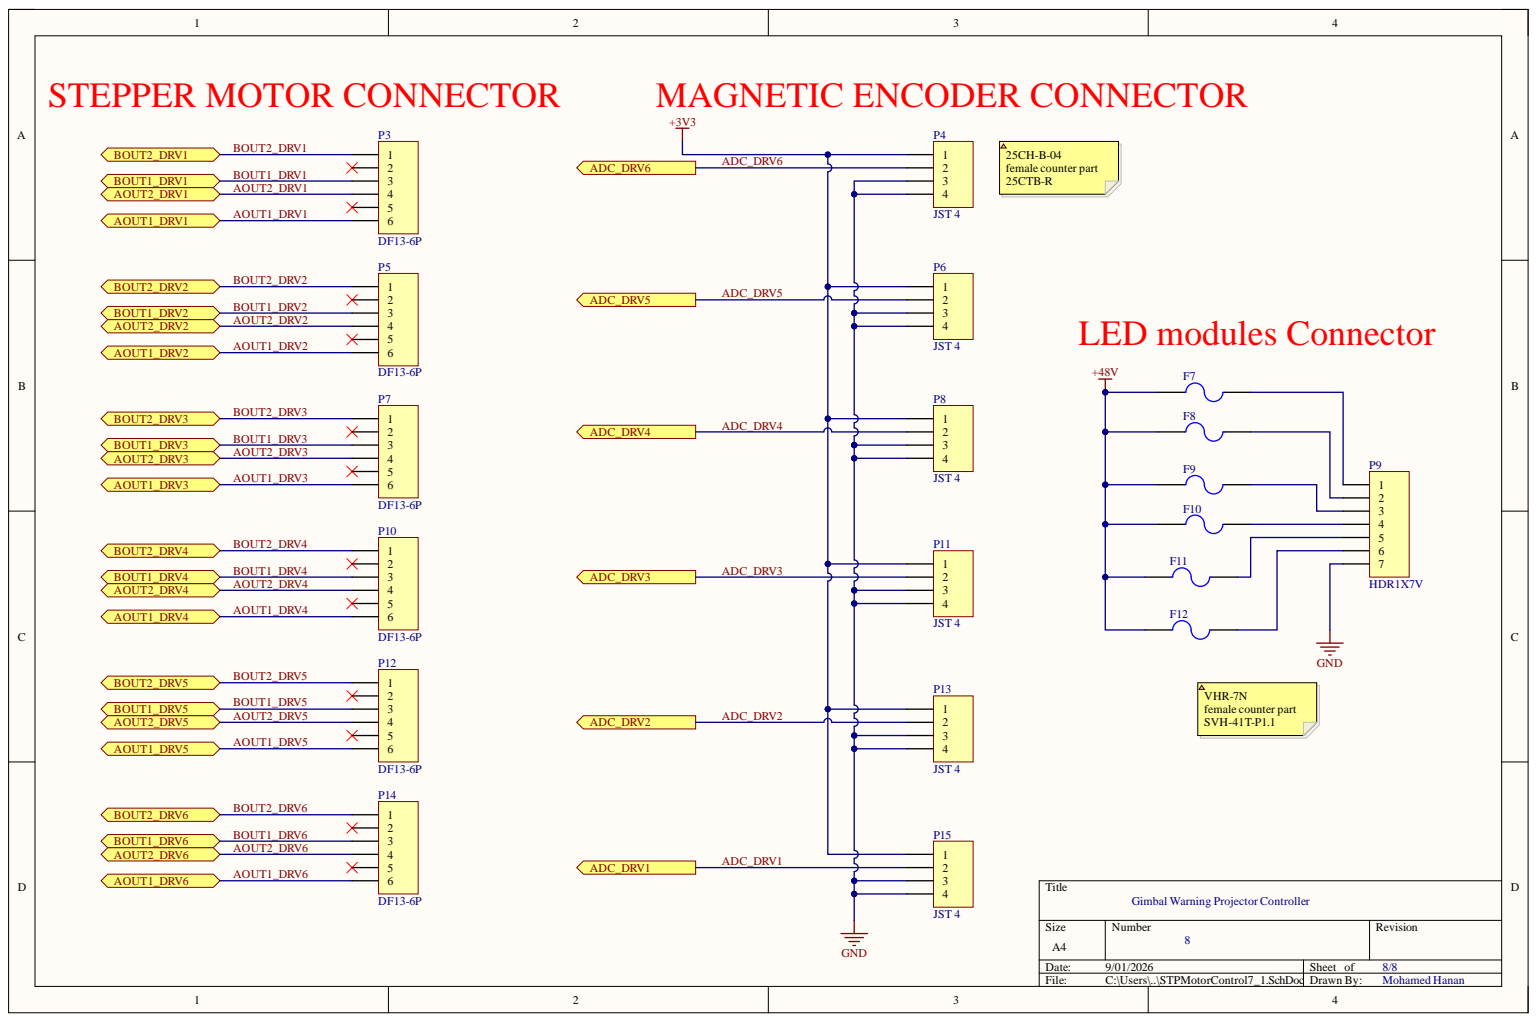
[picture p52: page 8]

LED modules Connector Gimbal Warning Projector Controller
