mohanan02/Controller-Design-for-an-Autonomous-Vehicle-Hazard-Warning-and-Intent-Projection-System/GimbalController/GimbalController.pdf

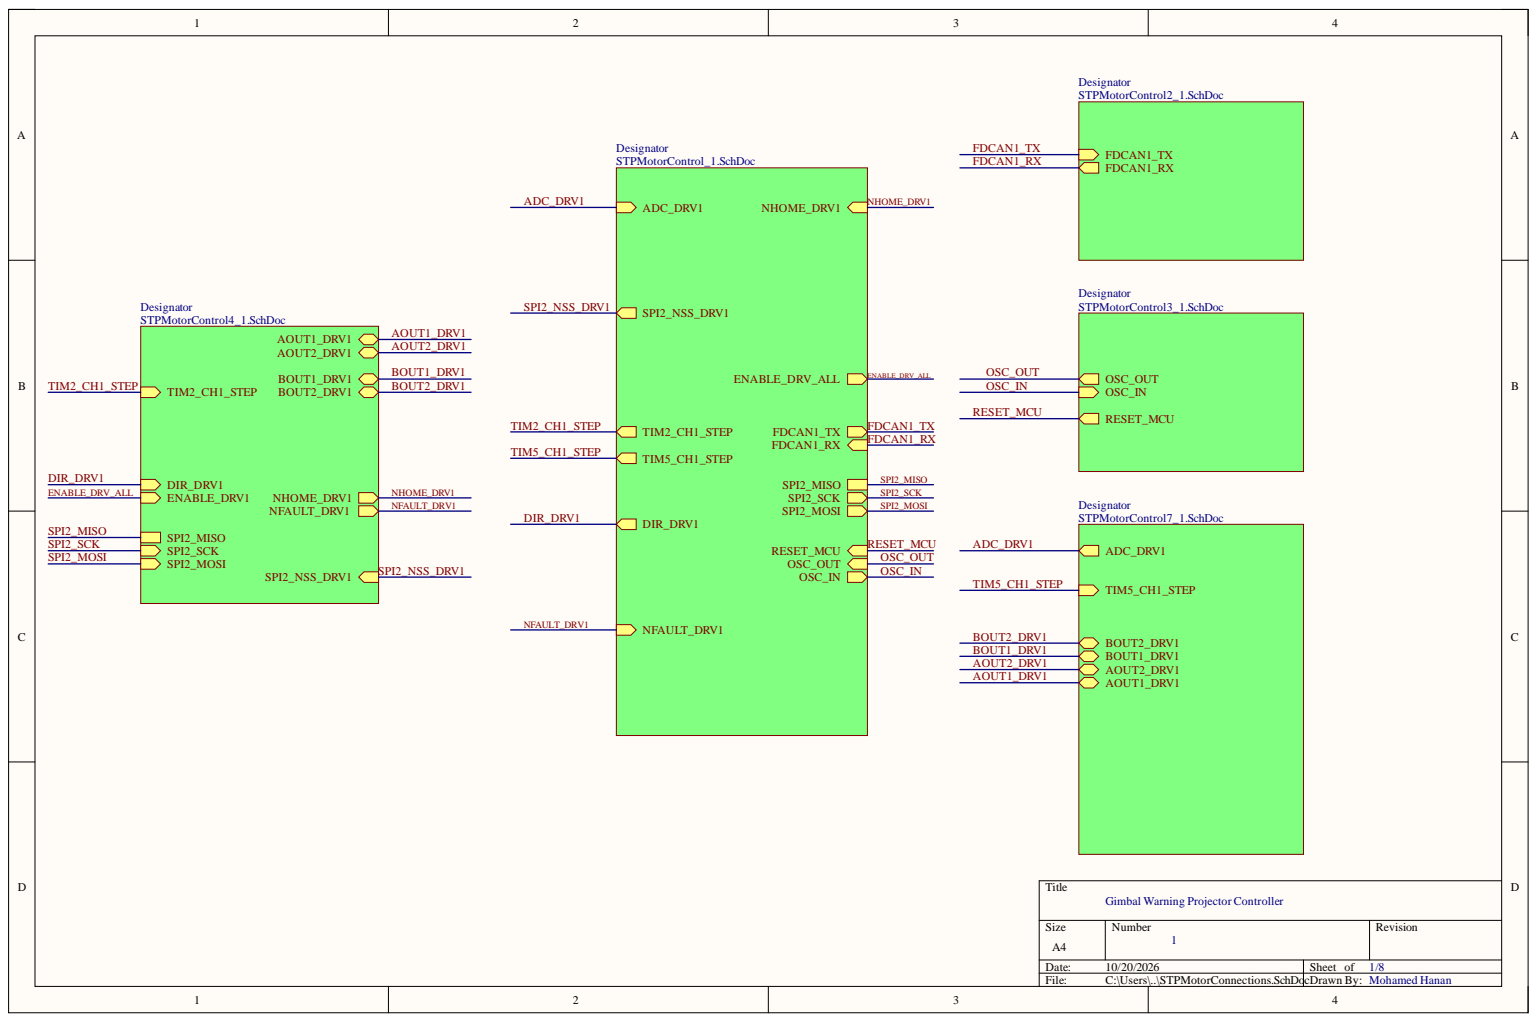
[picture p53: page 1]

Gimbal Warning Projector Controller

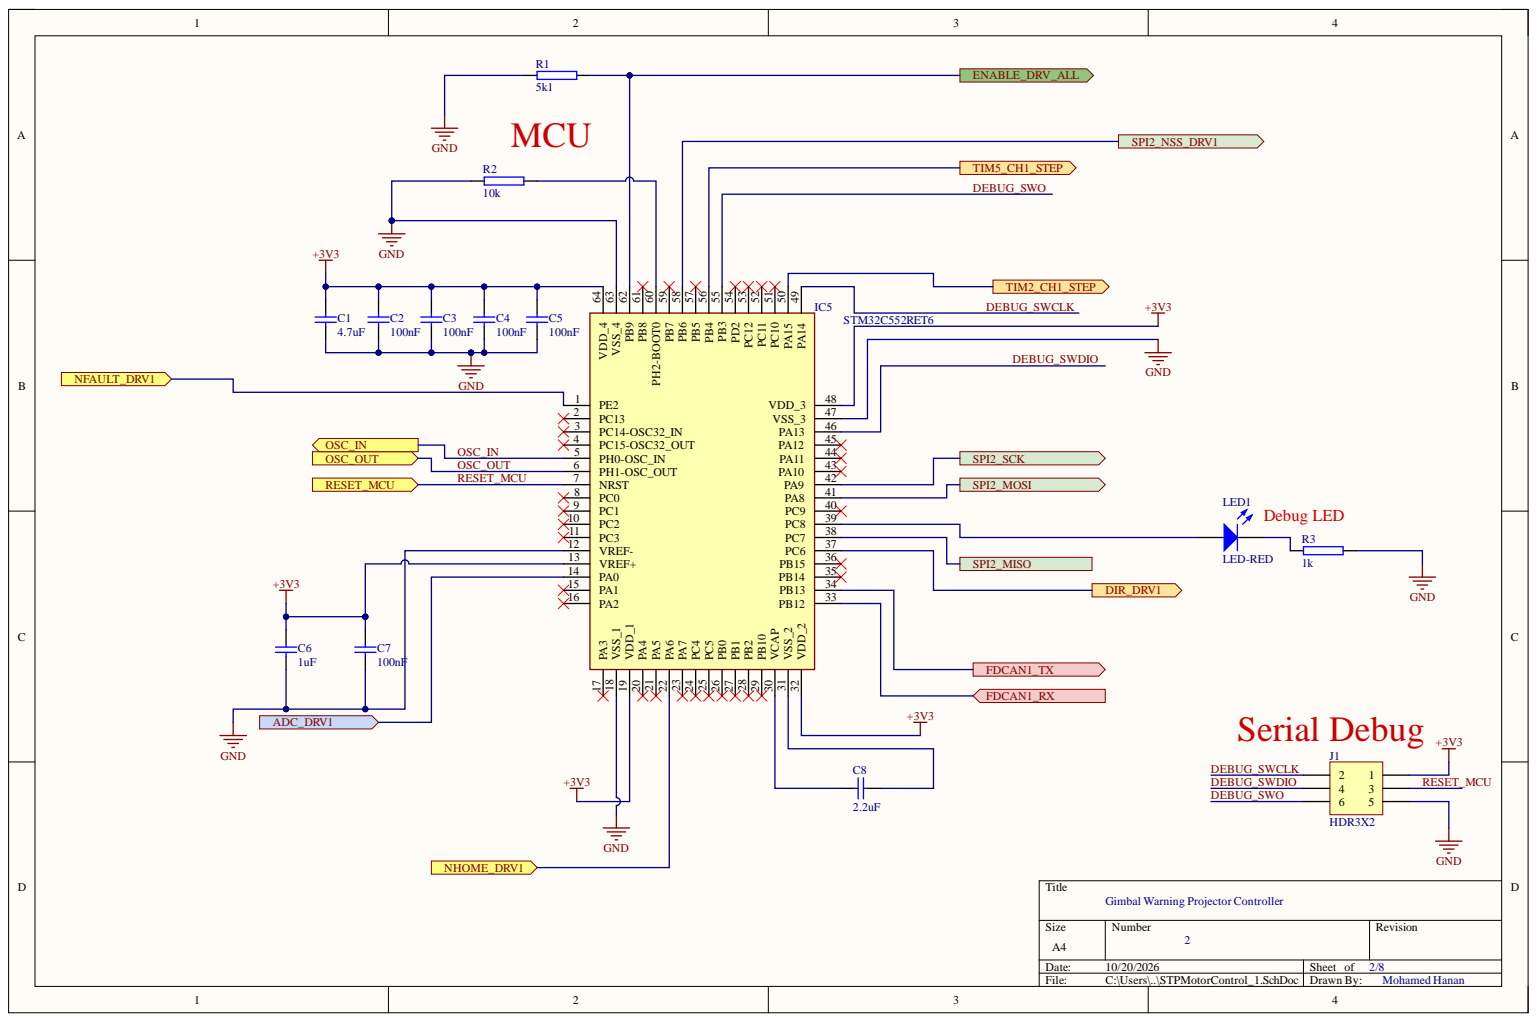
[picture p54: page 2]

OSC_IN | PH0-OSC_IN 5
OSC_OUT | PH1-OSC_OUT 6

Gimbal Warning Projector Controller

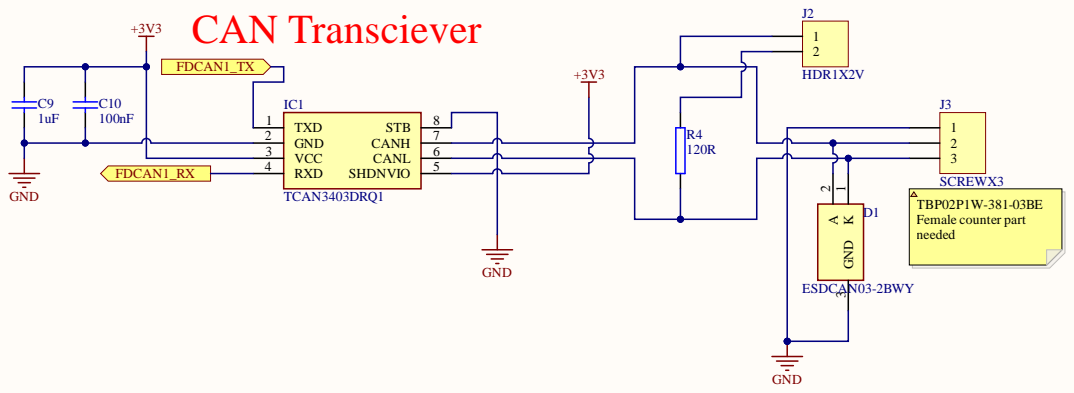
[picture p55: page 3]

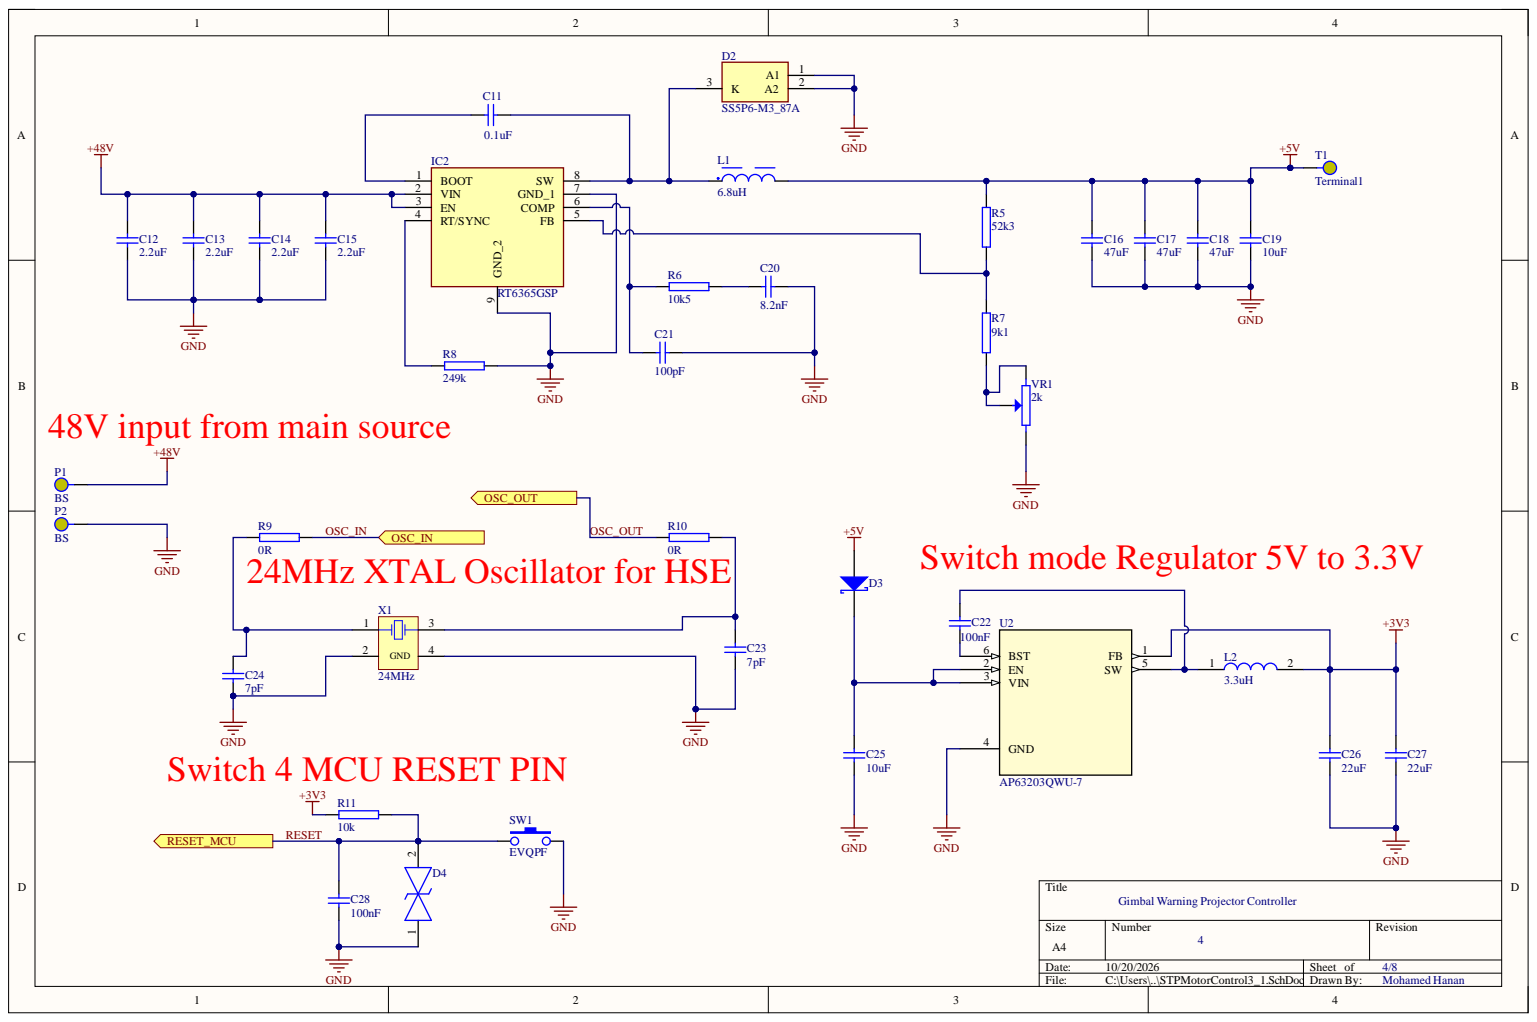
[picture p56: page 4]

48V input from main source

GND
Switch mode Regulator 5V to 3.3V

24MHz XTAL Oscillator for HSE

Switch 4 MCU RESET PIN

Gimbal Warning Projector Controller

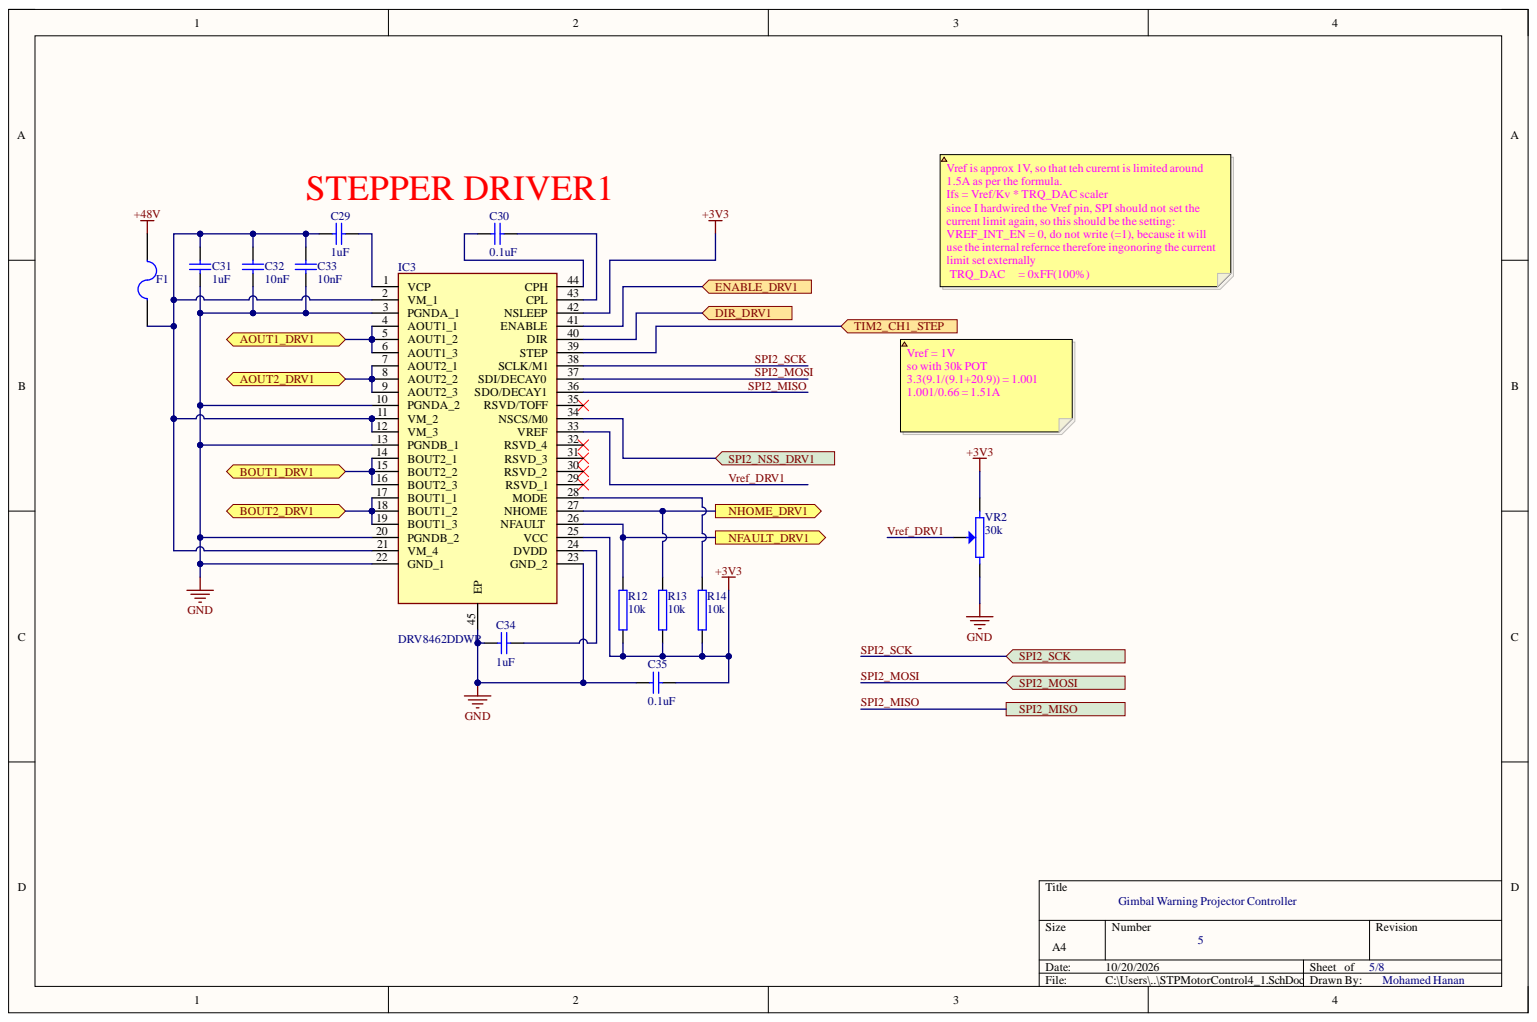
[picture p57: page 5]

Vref is approx 1V, so that teh curernt is limited around
1.5A as per the formula.
Ifs = Vref/Kv * TRQ_DAC scaler
since I hardwired the Vref pin, SPI should not set the
current limit again, so this should be the setting:
VREF_INT_EN = 0, do not write (=1), because it will
use the internal refernce therefore ingonoring the current
limit set externally

VCP 1

Gimbal Warning Projector Controller

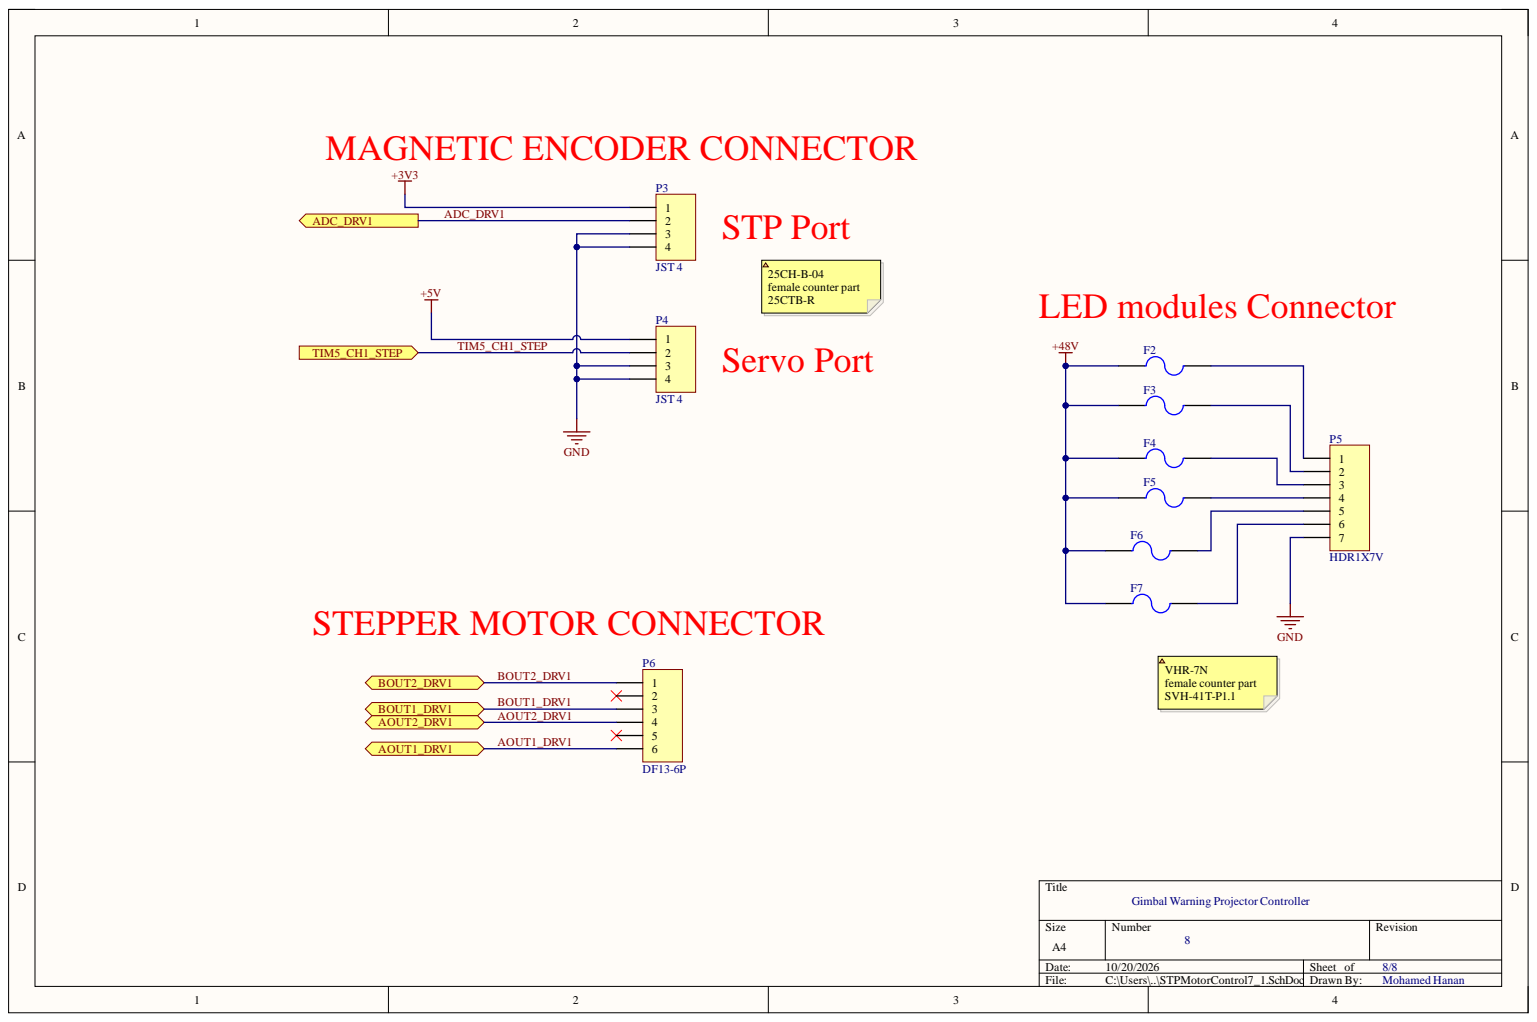
[picture p58: page 6]

Gimbal Warning Projector Controller

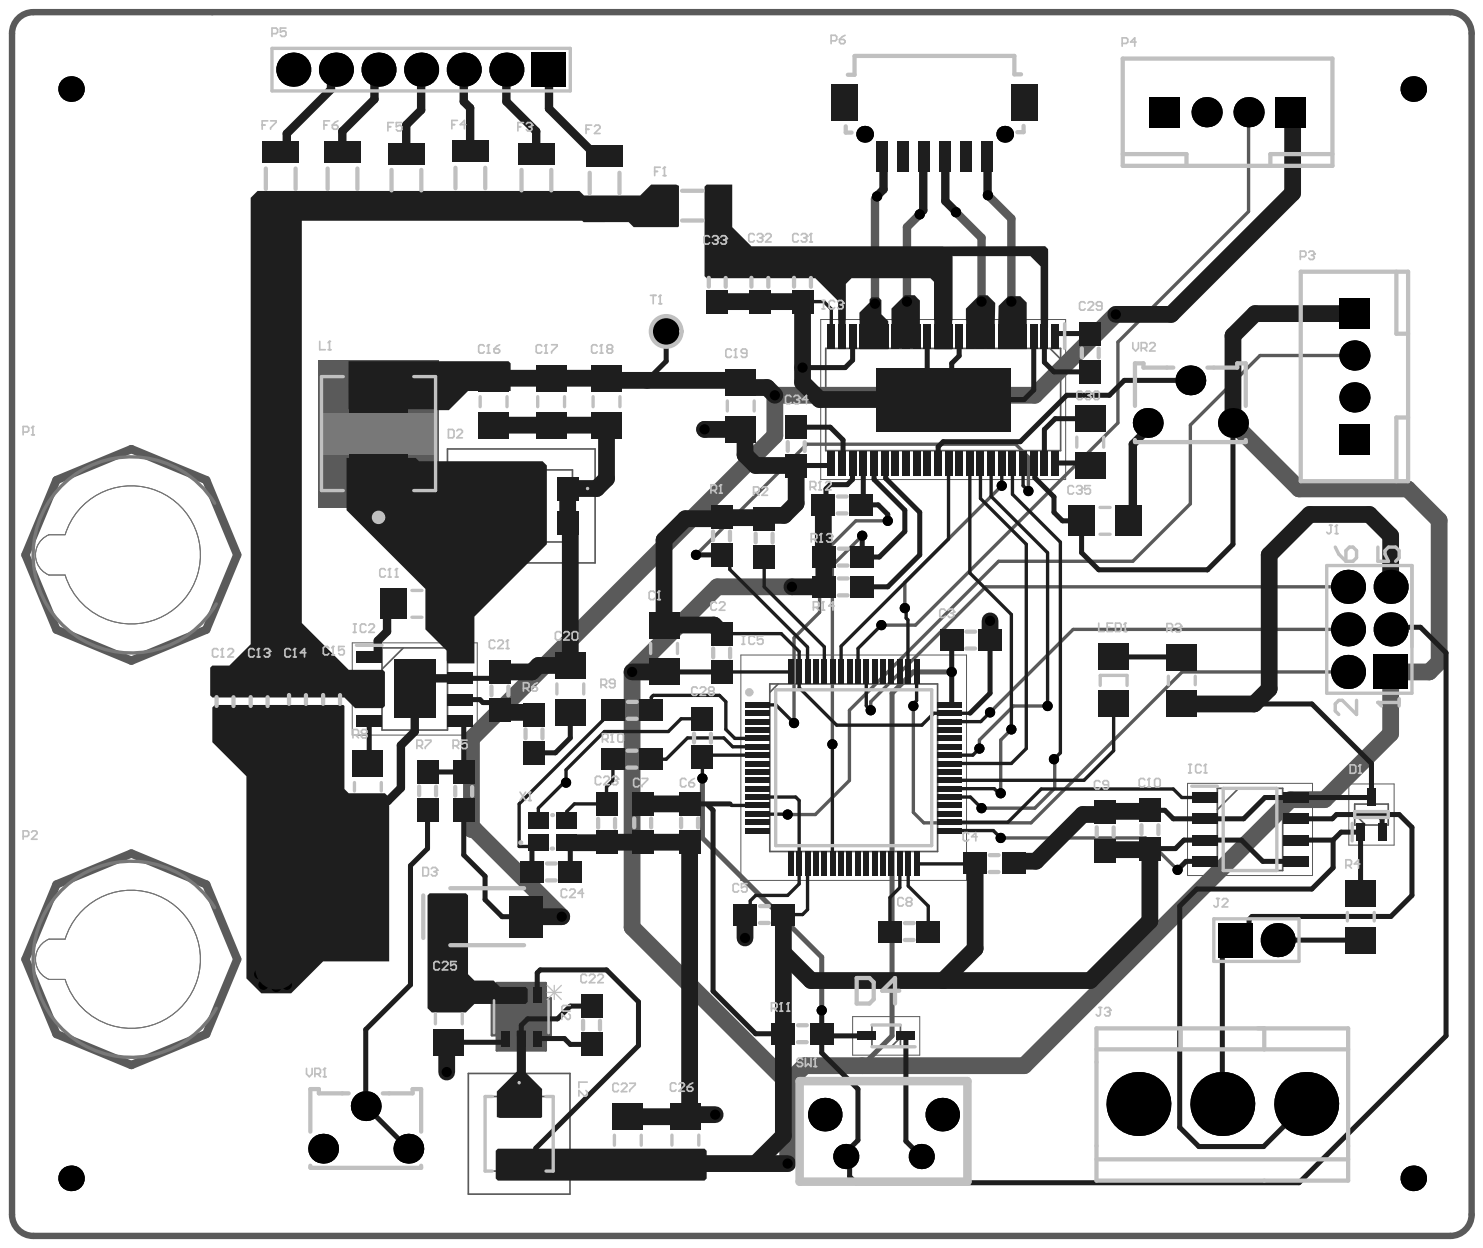
[picture p59: page 7]

Comment | Description | Designator | Footprint | LibRef | Quantity
4.7uF | NonPolarized Capacitor, SMD, 1206 | C1 | CAP_1206 | CAPN1206 | 1
100nF | NonPolarized Capacitor, SMD, 0805 | C2, C3, C4, C5, C7, C10, C22, C28 | CAP_0805 | CAPN0805 | 8
1uF | NonPolarized Capacitor, SMD, 0805 | C6, C9, C29, C31, C34 | CAP_0805 | CAPN0805 | 5
2.2uF | NonPolarized Capacitor, SMD, 0805 | C8, C12, C13, C14, C15 | CAP_0805 | CAPN0805 | 5
0.1uF | NonPolarized Capacitor, SMD, 1206 | C11, C30, C35 | CAP_1206 | CAPN1206 | 3
47uF | NonPolarized Capacitor, SMD, 1206 | C16, C17, C18 | CAP_1206 | CAPN1206 | 3
10uF | NonPolarized Capacitor, SMD, 1206 | C19, C25 | CAP_1206 | CAPN1206 | 2
8.2nF | NonPolarized Capacitor, SMD, 1206 | C20 | CAP_1206 | CAPN1206 | 1
100pF | NonPolarized Capacitor, SMD, 0805 | C21 | CAP_0805 | CAPN0805 | 1
7pF | NonPolarized Capacitor, SMD, 0805 | C23, C24 | CAP_0805 | CAPN0805 | 2
22uF | NonPolarized Capacitor, SMD, 1206 | C26, C27 | CAP_1206 | CAPN1206 | 2
10nF | NonPolarized Capacitor, SMD, 0805 | C32, C33 | CAP_0805 | CAPN0805 | 2
ESDCAN03-2BWY | TVSDiode(Uni-directional) | D1 | SOT65P210X110-3N | ESDCAN03-2BWY | 1
SS5P6-M3_87A | SchottkyDiode | D2 | SS5P6M387A | SS5P6-M3_87A | 1
PMEG3050BEP | SchottkyREC, 30V, 5A, SMD | D3 | SOD-128 | PMEG3050BEP | 1
TSD05CDYFR | TVSDiode(Bi-directional) | D4 | SOD2613X100N | TSD05CDYFR | 1
1206L035/16YR | Fuse, PTCReset, 350mAHold, 750mA Tripping, 16v | F1, F2, F3, F4, F5, F6, F7 | MC36207 | 1206L035/16YR | 7
TCAN3403DRQ1 | IntegratedCircuit | IC1 | SOIC127P600X175-8N | TCAN3403DRQ1 | 1
RT6365GSP | IntegratedCircuit | IC2 | SOIC127P600X175-9N | RT6365GSP | 1
DRV8462DDWR | IntegratedCircuit | IC3 | SOP64P810X120-45N | DRV8462DDWR | 1
STM32C552RET6 | IntegratedCircuit | IC5 | QFP50P1200X1200X1 60-64N | STM32C552RET6 | 1
HDR3X2 | Header, 3-Pin, Dual row, 2.54mmPitch, Straight | J1 | HDR2X3_AUT | HDR3X2 | 1
HDR1X2V | Header, Plug, 2.54mm, 2Pins, Straight | J2 | HDR1X2_AUT | HDR1X2V | 1
SCREWX3 | Terminal Block, PCB, 3Way, Pitch5mm | J3 | SCREW3_AUT | SCREWX3 | 1
6.8uH | PowerInductor, 6.8Uh, Shielded, 6.6ARohs Compliant: Yes| Wurth Elektronik 7443734948068 | L1 | WE-LHMI_7050 | WE-LHMI_7050 | 1
3.3uH | Inductor | L2 | SRP4020TA3R3M | SRP4020TA-3R3M | 1
LED-RED | REDLED, Case1206 | LED1 | LED1206R | SMD1206LED-RED | 1
BS | BananaSocket, 4mm, Panel, Black, 10A | P1, P2 | Banana_AUT | BananaSocket | 2
JST4 | JSTXAHeader, 4-Pin, Pitch2.5mm | P3, P4 | XA-4 | JSTXAHeader 4 | 2
HDR1X7V | Header, Plug, 2.54mm, 7Pins, Straight | P5 | HDR1X7_AUT | HDR1X7V | 1
DF13-6P | HIROSE(HRS) DF13-6P-1.25H(20) Wire-To-BoardConnector, Right Angle, DF13 Series, SurfaceMount, Header, 6Contacts, 1.25mm | P6 | DF13-6 | DF13-6P | 1
5k1 | Resistor, SMD, 0805 | R1 | RES_0805 | Resistor 0805 | 1
10k | Resistor, SMD, 0805 | R2, R11, R12, R13, R14 | RES_0805 | Resistor 0805 | 5
1k | Resistor, SMD, 1206 | R3 | RES_1206 | Resistor 1206 | 1
120R | Resistor, SMD, 1206 | R4 | RES_1206 | Resistor 1206 | 1
52k3 | Resistor, SMD, 0805 | R5 | RES_0805 | Resistor 0805 | 1
10k5 | Resistor, SMD, 0805 | R6 | RES_0805 | Resistor 0805 | 1
9k1 | Resistor, SMD, 0805 | R7 | RES_0805 | Resistor 0805 | 1
249k | Resistor, SMD, 1206 | R8 | RES_1206 | Resistor 1206 | 1
0R | Resistor, SMD, 0805 | R9, R10 | RES_0805 | Resistor 0805 | 2
EVQPF | PANASONIC EVQPF203M SWITCH, TACTILE, SPST-NO, 20mA, 15VDC | SW1 | EVQPF203M | EVQPF | 1
Terminal1 | Terminal, Pad 70x70mil, Hole32mil | T1 | PAD1_AUT | Terminal1 | 1
AP63203QWU-7 | Description | U2 | TSOT26_DIO | AP63203QWU-7 | 1
2k | 3362SSeries, 1/4” Square Potentiometer, 2k, 10%, 0.5Watts, 1Turn | VR1 | 3362S | 3362S-1-202LF | 1
30k | 3362SSeries, 1/4” Square Potentiometer, 2k, 10%, 0.5Watts, 1Turn | VR2 | 3362S | 3362S-1-202LF | 1
24MHz | Crystals, 24MHz | X1 | CX2520SB | CX2520SB24000D0FLJ ZZ | 1
