mohanan02/Controller-Design-for-an-Autonomous-Vehicle-Hazard-Warning-and-Intent-Projection-System/MainController(LidarInterface)/MainController.pdf

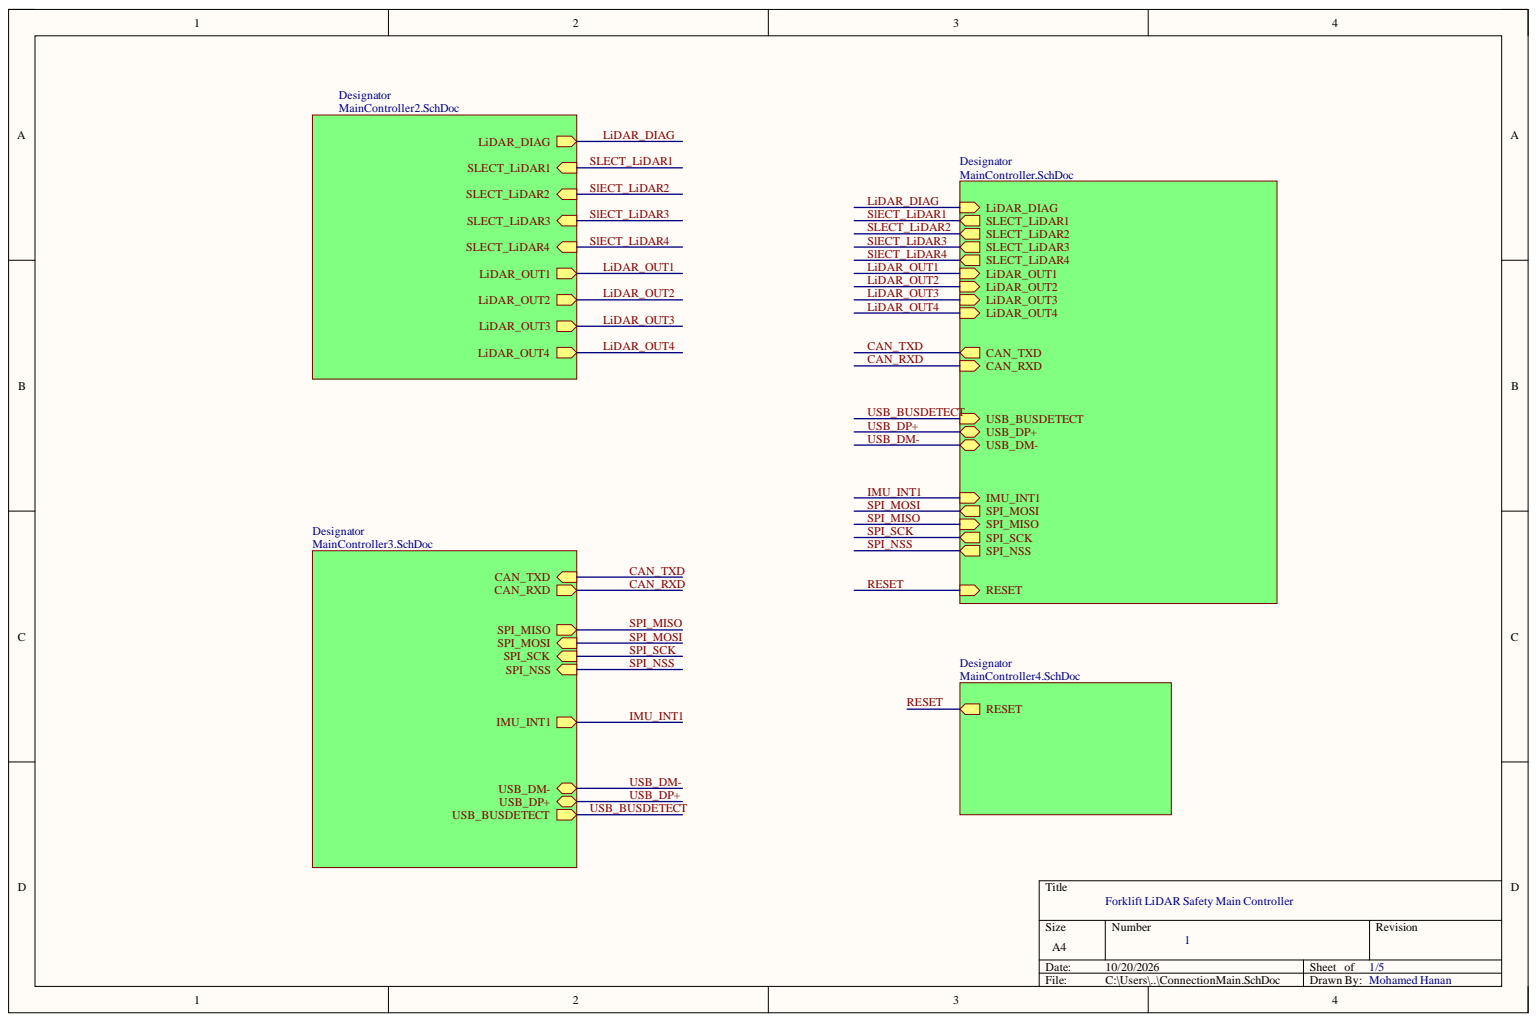
[picture p60: page 1]

Forklift LiDAR Safety Main Controller

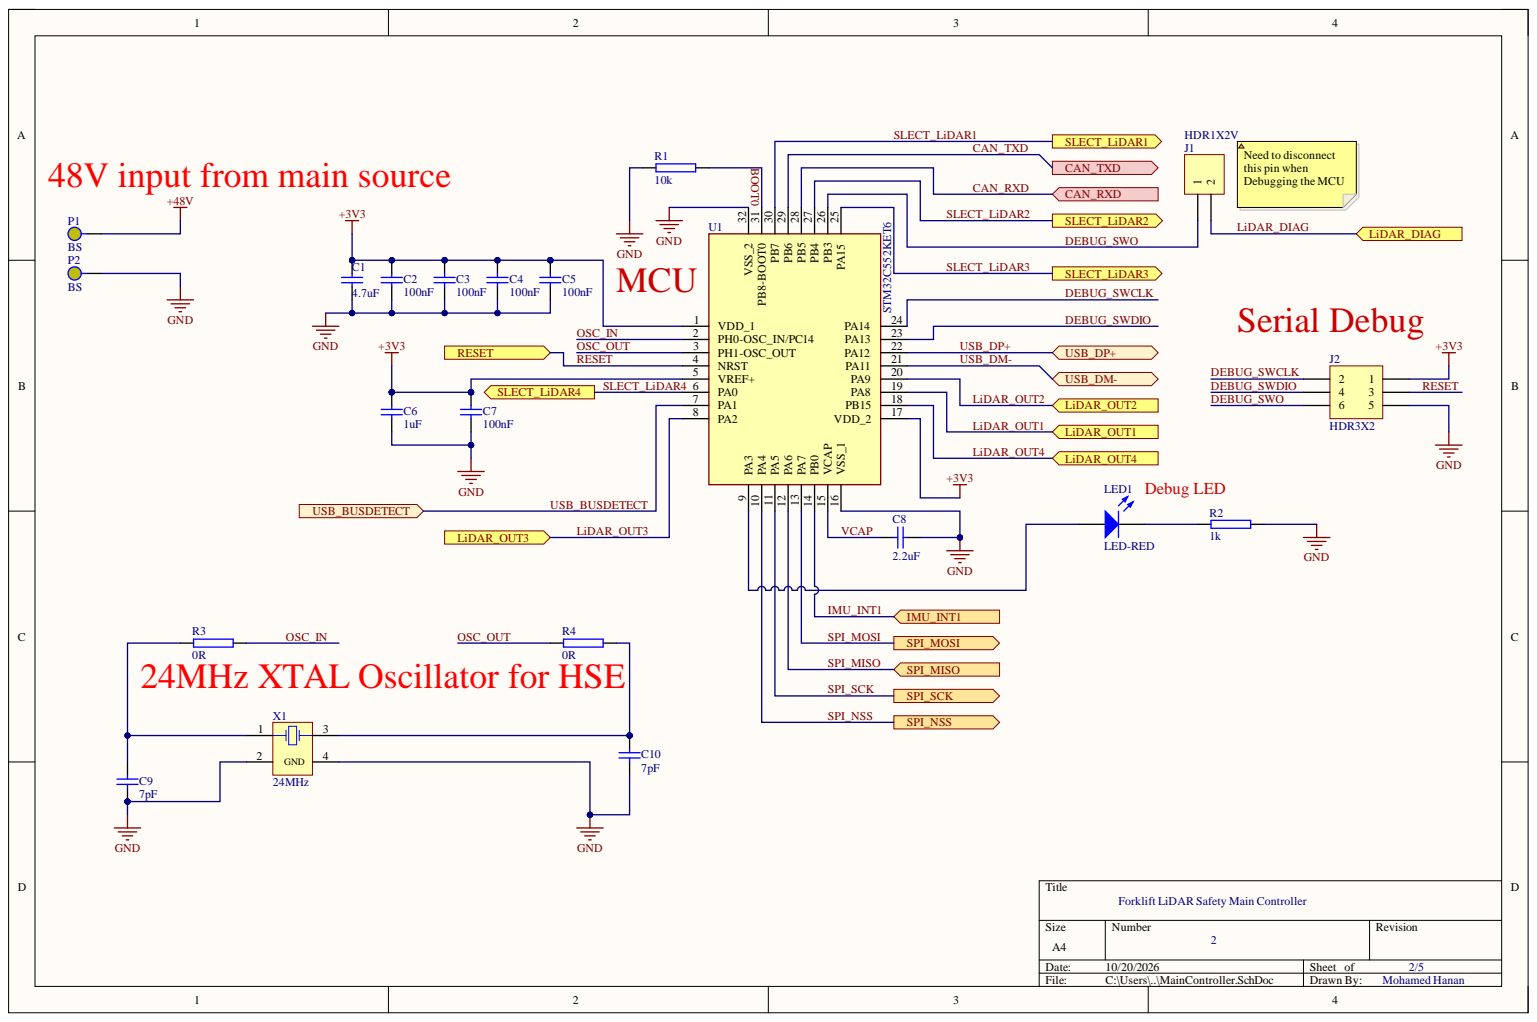
[picture p61: page 2]

48V input from main source

USB_BUSDETECT
LiDAR_OUT3 | | C8

VCAP

24MHz XTAL Oscillator for HSE

Forklift LiDAR Safety Main Controller

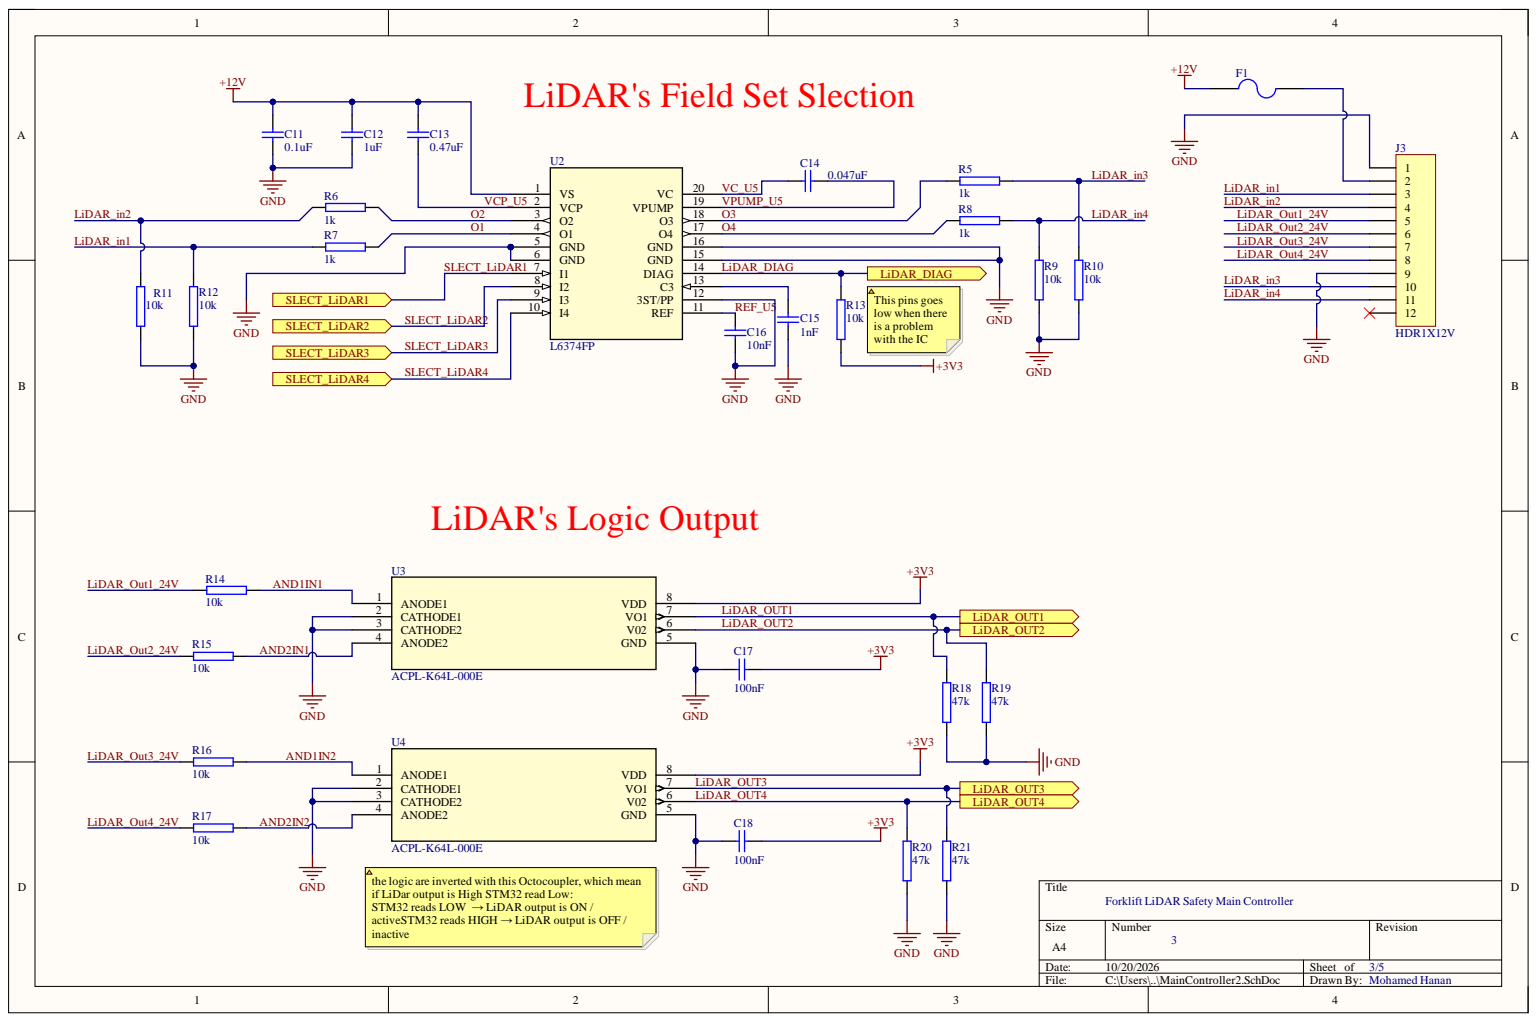
[picture p62: page 3]

LiDAR's Field Set Slection

VCP 2 | VPUMP_U5

I1 7 | | LiDAR_DIAG
I2 8
I3 9

REF_U5

SLECT_LiDAR2

CATHODE1 2
CATHODE2 3 | LiDAR_OUT2

CATHODE2 3 | LiDAR_OUT4

the logic are inverted with this Octocoupler, which mean
if LiDar output is High STM32 read Low:
STM32 reads LOW → LiDAR output is ON /
activeSTM32 reads HIGH → LiDAR output is OFF /
inactive

Forklift LiDAR Safety Main Controller

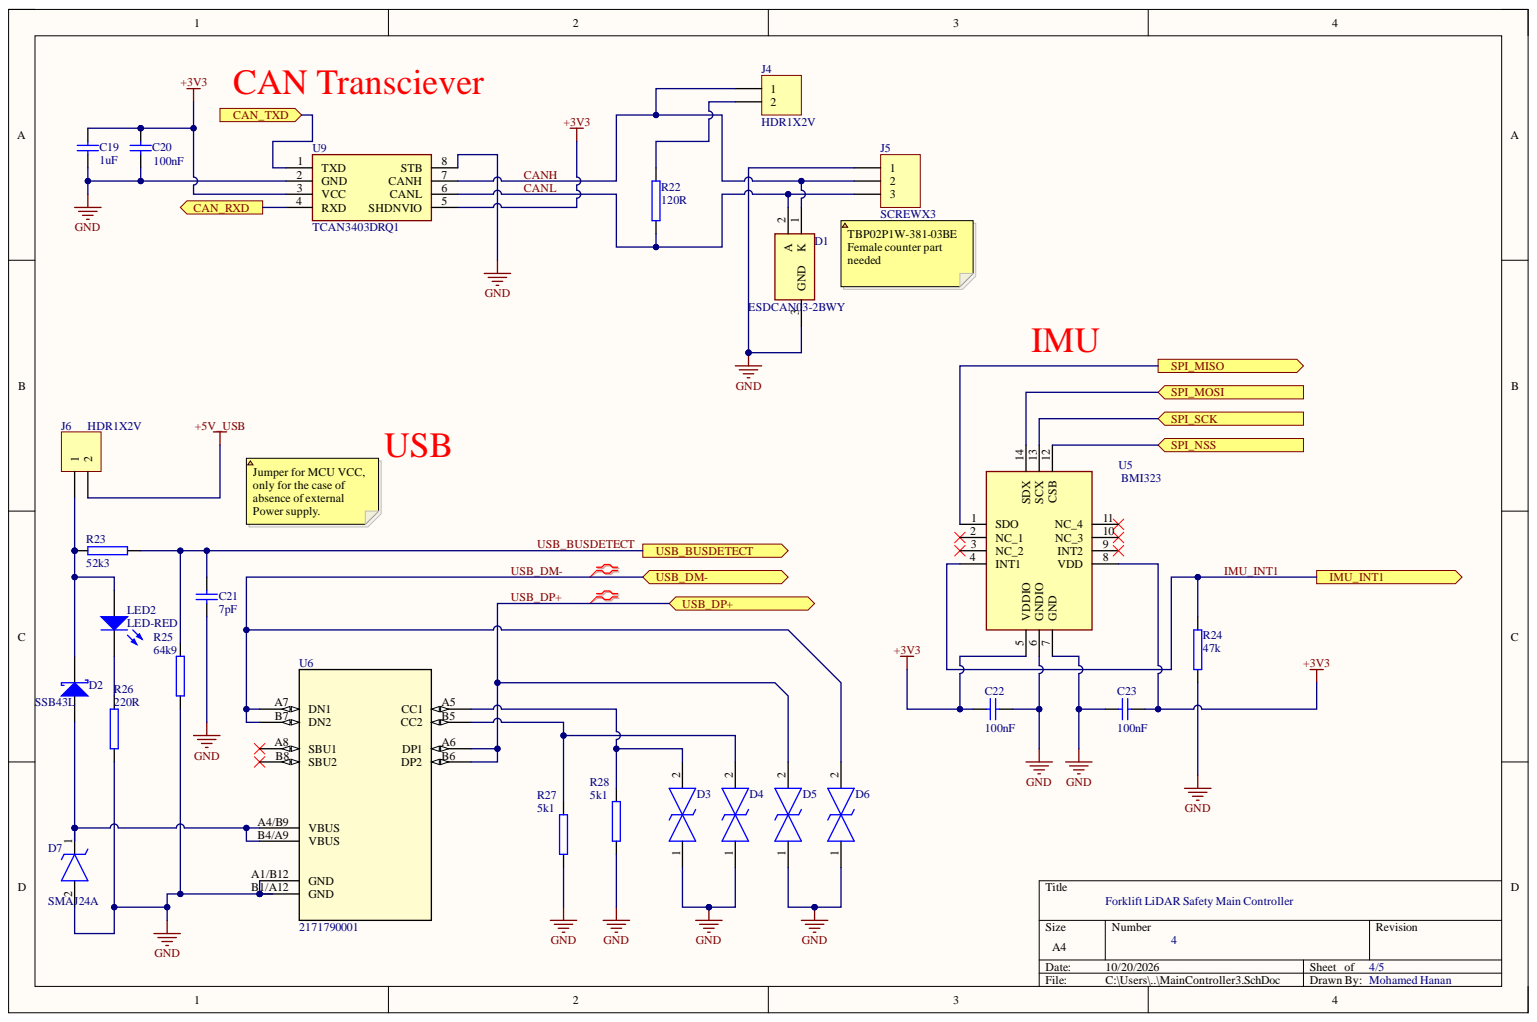
[picture p63: page 4]

Jumper for MCU VCC,
only for the case of
absence of external
Power supply.

Forklift LiDAR Safety Main Controller

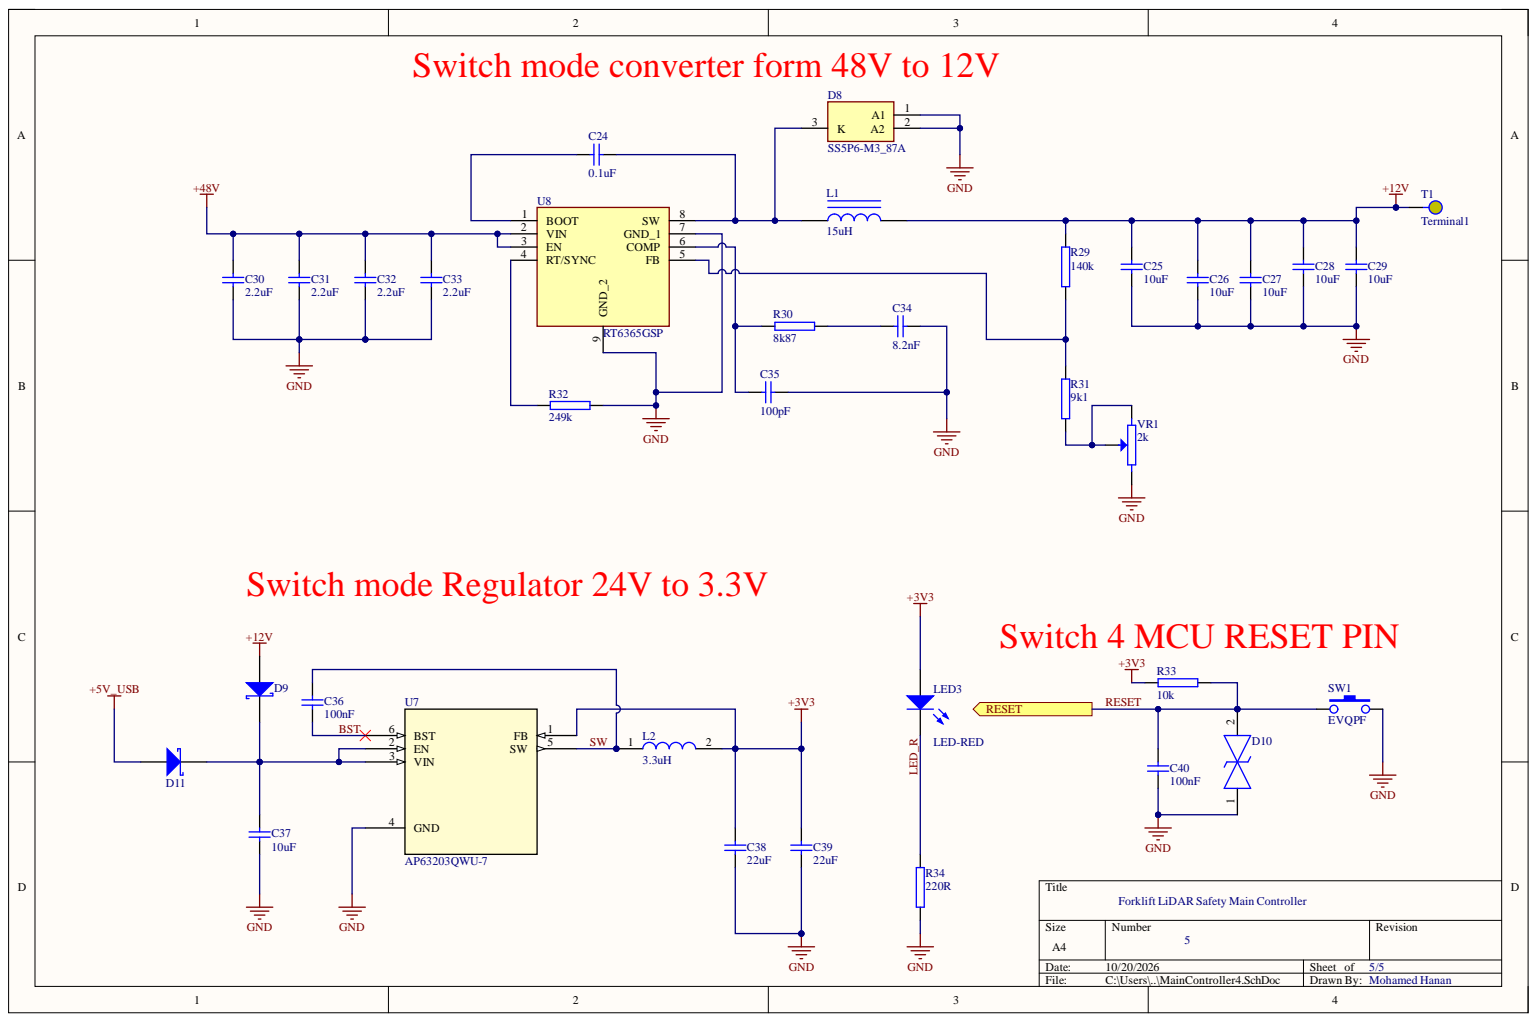
[picture p64: page 5]

Switch mode converter form 48V to 12V

RT6365GSP

Switch mode Regulator 24V to 3.3V

Switch 4 MCU RESET PIN

GND 4

Forklift LiDAR Safety Main Controller

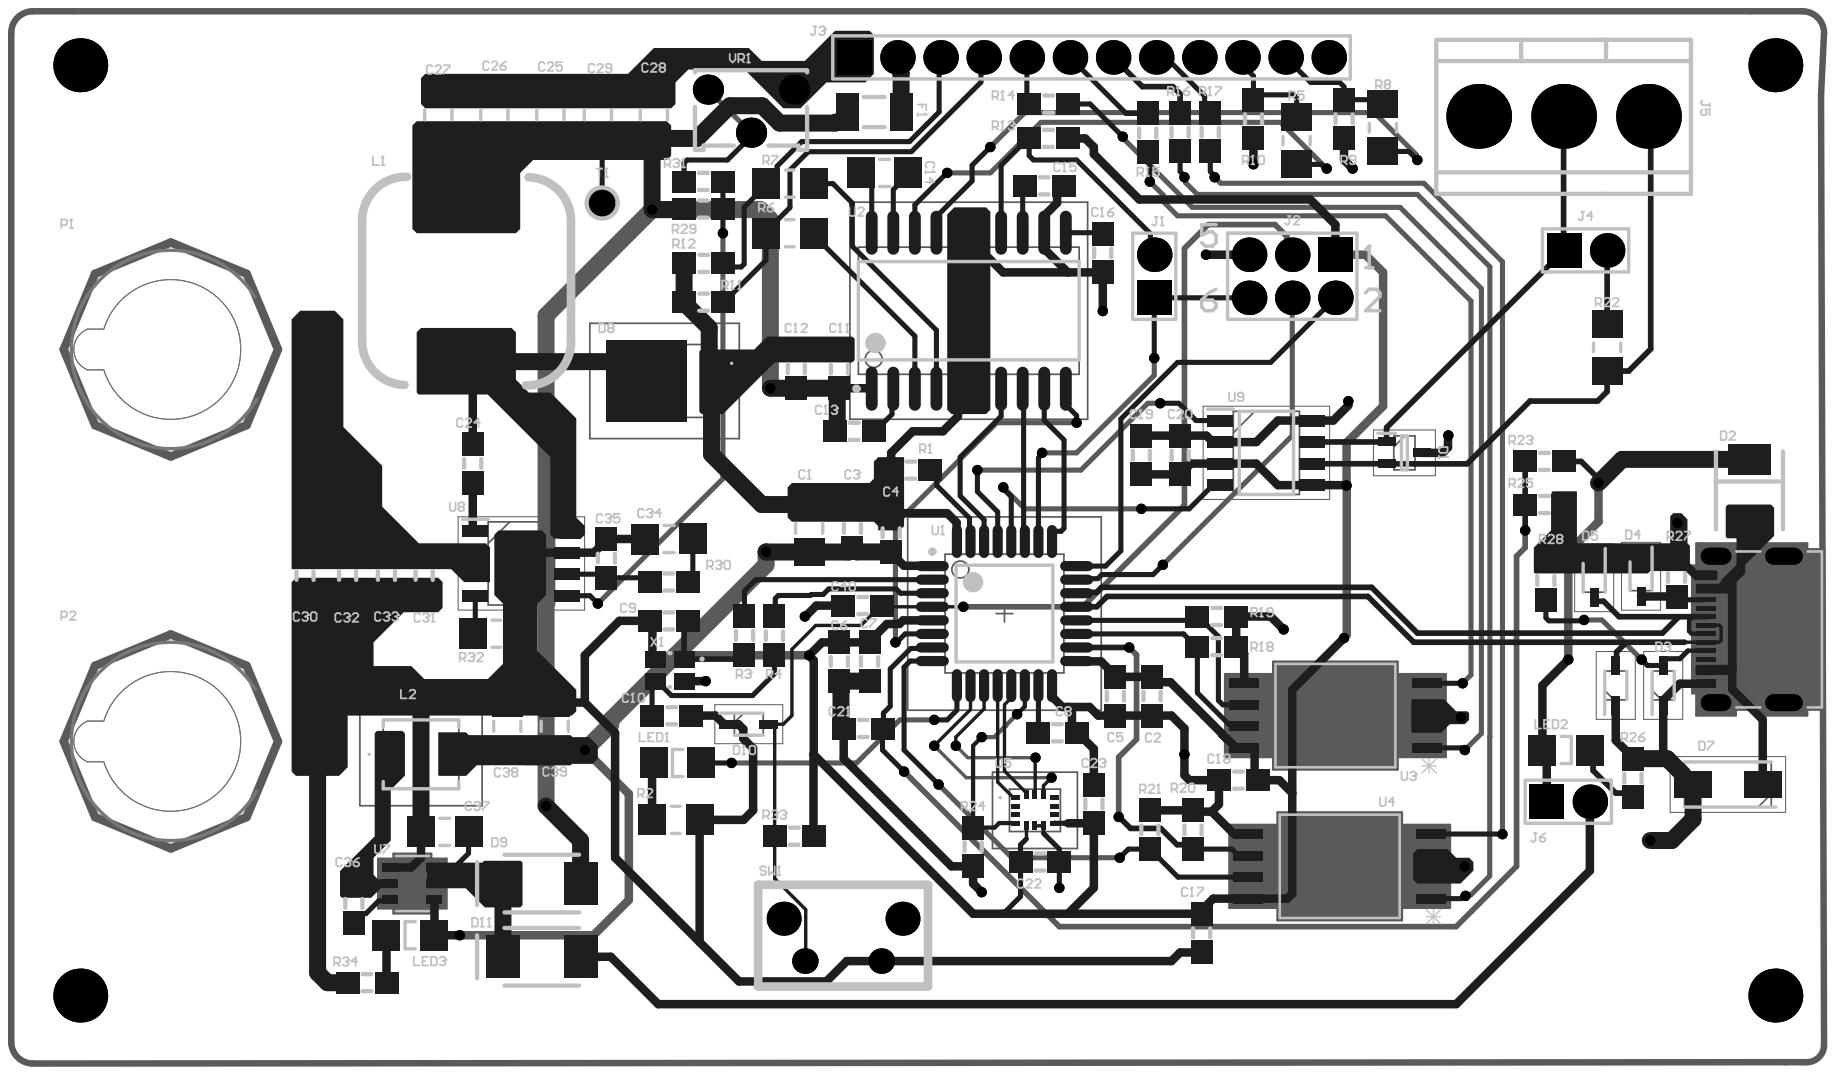
[picture p65: page 6]

Comment | Description | Designator | Footprint | LibRef | Quantity
4.7uF | NonPolarized Capacitor, SMD, 1206 | C1 | CAP_1206 | CAPN1206 | 1
100nF | NonPolarized Capacitor, SMD, 0805 | C2, C3, C4, C5, C7, C17, C18, C20, C22, C23, C36, C40 | CAP_0805 | CAPN0805 | 12
1uF | NonPolarized Capacitor, SMD, 0805 | C6, C12, C19 | CAP_0805 | CAPN0805 | 3
2.2uF | NonPolarized Capacitor, SMD, 0805 | C8, C30, C31, C32, C33 | CAP_0805 | CAPN0805 | 5
7pF | NonPolarized Capacitor, SMD, 0805 | C9, C10, C21 | CAP_0805 | CAPN0805 | 3
0.1uF | NonPolarized Capacitor, SMD, 0805 | C11, C24 | CAP_0805 | CAPN0805 | 2
0.47uF | NonPolarized Capacitor, SMD, 0805 | C13 | CAP_0805 | CAPN0805 | 1
0.047uF | NonPolarized Capacitor, SMD, 1206 | C14 | CAP_1206 | CAPN1206 | 1
1nF | NonPolarized Capacitor, SMD, 0805 | C15 | CAP_0805 | CAPN0805 | 1
10nF | NonPolarized Capacitor, SMD, 0805 | C16 | CAP_0805 | CAPN0805 | 1
10uF | NonPolarized Capacitor, SMD, 1206 | C25, C26, C27, C28, C29, C37 | CAP_1206 | CAPN1206 | 6
8.2nF | NonPolarized Capacitor, SMD, 1206 | C34 | CAP_1206 | CAPN1206 | 1
100pF | NonPolarized Capacitor, SMD, 0805 | C35 | CAP_0805 | CAPN0805 | 1
22uF | NonPolarized Capacitor, SMD, 1206 | C38, C39 | CAP_1206 | CAPN1206 | 2
ESDCAN03-2BWY | TVSDiode(Uni-directional) | D1 | SOT65P210X110-3N | ESDCAN03-2BWY | 1
SSB43L | SchottkyDiode, 4A, 30v | D2 | DO-214AA(SMB) | SSB43L | 1
TSD05CDYFR | TVSDiode(Bi-directional) | D3, D4, D5, D6, D10 | SOD2613X100N | TSD05CDYFR | 5
SMAJ24A | TVSDiode(Uni-directional) | D7 | DIOM5127X229N | SMAJ24A | 1
SS5P6-M3_87A | SchottkyDiode | D8 | SS5P6M387A | SS5P6-M3_87A | 1
PMEG3050BEP | SchottkyREC, 30V, 5A, SMD | D9, D11 | SOD-128 | PMEG3050BEP | 2
1206L035/16YR | Fuse, PTCReset, 350mAHold, 750mA Tripping, 16v | F1 | MC36207 | 1206L035/16YR | 1
HDR1X2V | Header, Plug, 2.54mm, 2Pins, Straight | J1, J4, J6 | HDR1X2_AUT | HDR1X2V | 3
HDR3X2 | Header, 3-Pin, Dual row, 2.54mmPitch, Straight | J2 | HDR2X3_AUT | HDR3X2 | 1
HDR1X12V | Header, Plug, 2.54mm, 12Pins, Straight | J3 | HDR1X12_AUT | HDR1X12V | 1
SCREWX3 | Terminal Block, PCB, 3Way, Pitch5mm | J5 | SCREW3_AUT | SCREWX3 | 1
15uH | Inductor, 15uH, 8.7A, AEC-Q200MSS1210 Series | L1 | MSS1210 | MSS1210-153MED | 1
3.3uH | Inductor | L2 | SRP4020TA3R3M | SRP4020TA-3R3M | 1
LED-RED | REDLED, Case1206 | LED1, LED2, LED3 | LED1206R | SMD1206LED-RED | 3
BS | BananaSocket, 4mm, Panel, Black, 10A | P1, P2 | Banana_AUT | BananaSocket | 2
10k | Resistor, SMD, 0805 | R1, R9, R10, R11, R12, R13, R14, R15, R16, R17, R33 | RES_0805 | Resistor 0805 | 11
1k | Resistor, SMD, 1206 | R2, R5, R6, R7, R8 | RES_1206 | Resistor 1206 | 5
0R | Resistor, SMD, 0805 | R3, R4 | RES_0805 | Resistor 0805 | 2
47k | Resistor, SMD, 0805 | R18, R19, R20, R21, R24 | RES_0805 | Resistor 0805 | 5
120R | Resistor, SMD, 1206 | R22 | RES_1206 | Resistor 1206 | 1
52k3 | Resistor, SMD, 0805 | R23 | RES_0805 | Resistor 0805 | 1
64k9 | Resistor, SMD, 0805 | R25 | RES_0805 | Resistor 0805 | 1
220R | Resistor, SMD, 0805 | R26, R34 | RES_0805 | Resistor 0805 | 2
5k1 | Resistor, SMD, 0805 | R27, R28 | RES_0805 | Resistor 0805 | 2
140k | Resistor, SMD, 0805 | R29 | RES_0805 | Resistor 0805 | 1
8k87 | Resistor, SMD, 0805 | R30 | RES_0805 | Resistor 0805 | 1
9k1 | Resistor, SMD, 0805 | R31 | RES_0805 | Resistor 0805 | 1
249k | Resistor, SMD, 1206 | R32 | RES_1206 | Resistor 1206 | 1
EVQPF | PANASONIC EVQPF203M SWITCH, TACTILE, SPST-NO, 20mA, 15VDC | SW1 | EVQPF203M | EVQPF | 1
Terminal1 | Terminal, Pad 70x70mil, Hole32mil | T1 | PAD1_AUT | Terminal1 | 1
STM32C552KET6 | Arm?Cortex?-M3332-bit MCUwithFPU, 144 MHz, 593CoreMark?, upto512Kbyte dualbankflash memory, 128-Kbyte RAM | U1 | 32A_M | STM32C552KET6 | 1
L6374FP | INDUSTRIALQUAD LINEDRIVER | U2 | 20S_M | L6374FP | 1
ACPL-K64L-000E | Description | U3, U4 | STRETCHED_SO-8_AVA ACPL-K64L-000E | | 2
BMI323 | IntegratedCircuit | U5 | BMI323 | BMI323 | 1
2171790001 | Universal Serial Bus (USB)ShieldedI/O Receptacle, TypeC, Right-Angle, Top Mount, SurfaceMount, SingleRow, 16 Circuits, Gold(Au) Plating | U6 | 2171790001_MOL | 2171790001 | 1
AP63203QWU-7 | Description | U7 | TSOT26_DIO | AP63203QWU-7 | 1
RT6365GSP | IntegratedCircuit | U8 | SOIC127P600X175-9N | RT6365GSP | 1
TCAN3403DRQ1 | IntegratedCircuit | U9 | SOIC127P600X175-8N - duplicate | TCAN3403DRQ1 | 1
2k | 3362SSeries, 1/4” Square Potentiometer, 2k, 10%, 0.5Watts, 1Turn | VR1 | 3362S | 3362S-1-202LF | 1
24MHz | Crystals, 24MHz | X1 | CX2520SB | CX2520SB24000D0FLJ ZZ | 1
