mohanan02/Controller-Design-for-an-Autonomous-Vehicle-Hazard-Warning-and-Intent-Projection-System/(1)Final_Updated_SCHEMATICS/GimbalController.pdf

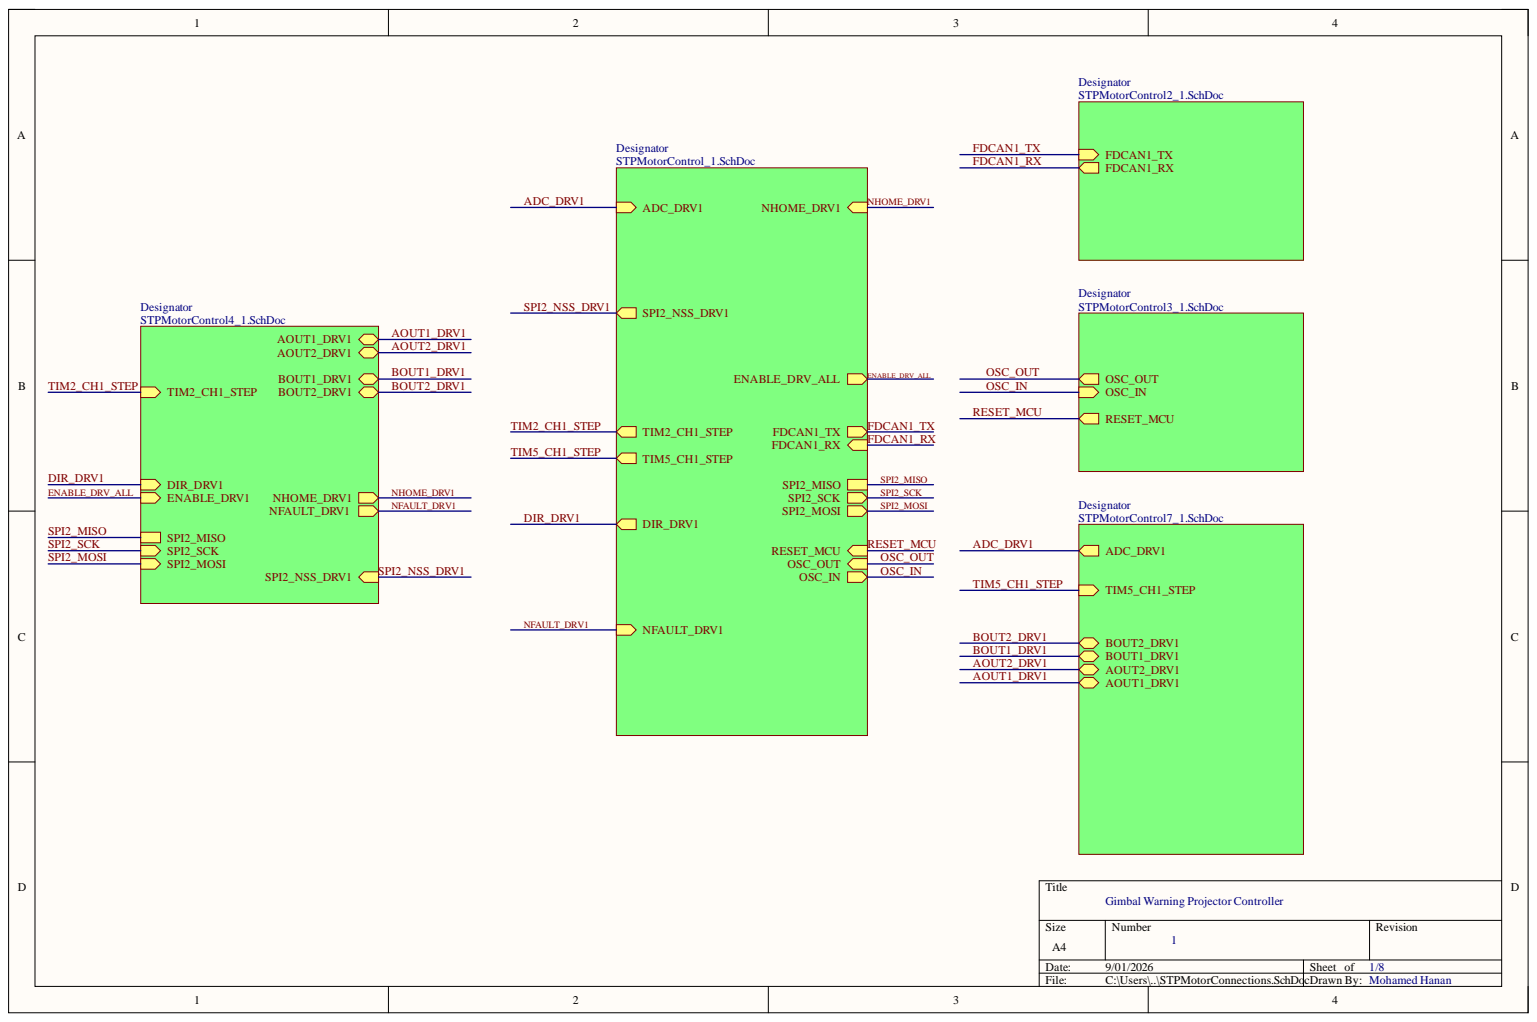
[picture p66: page 1]

Gimbal Warning Projector Controller

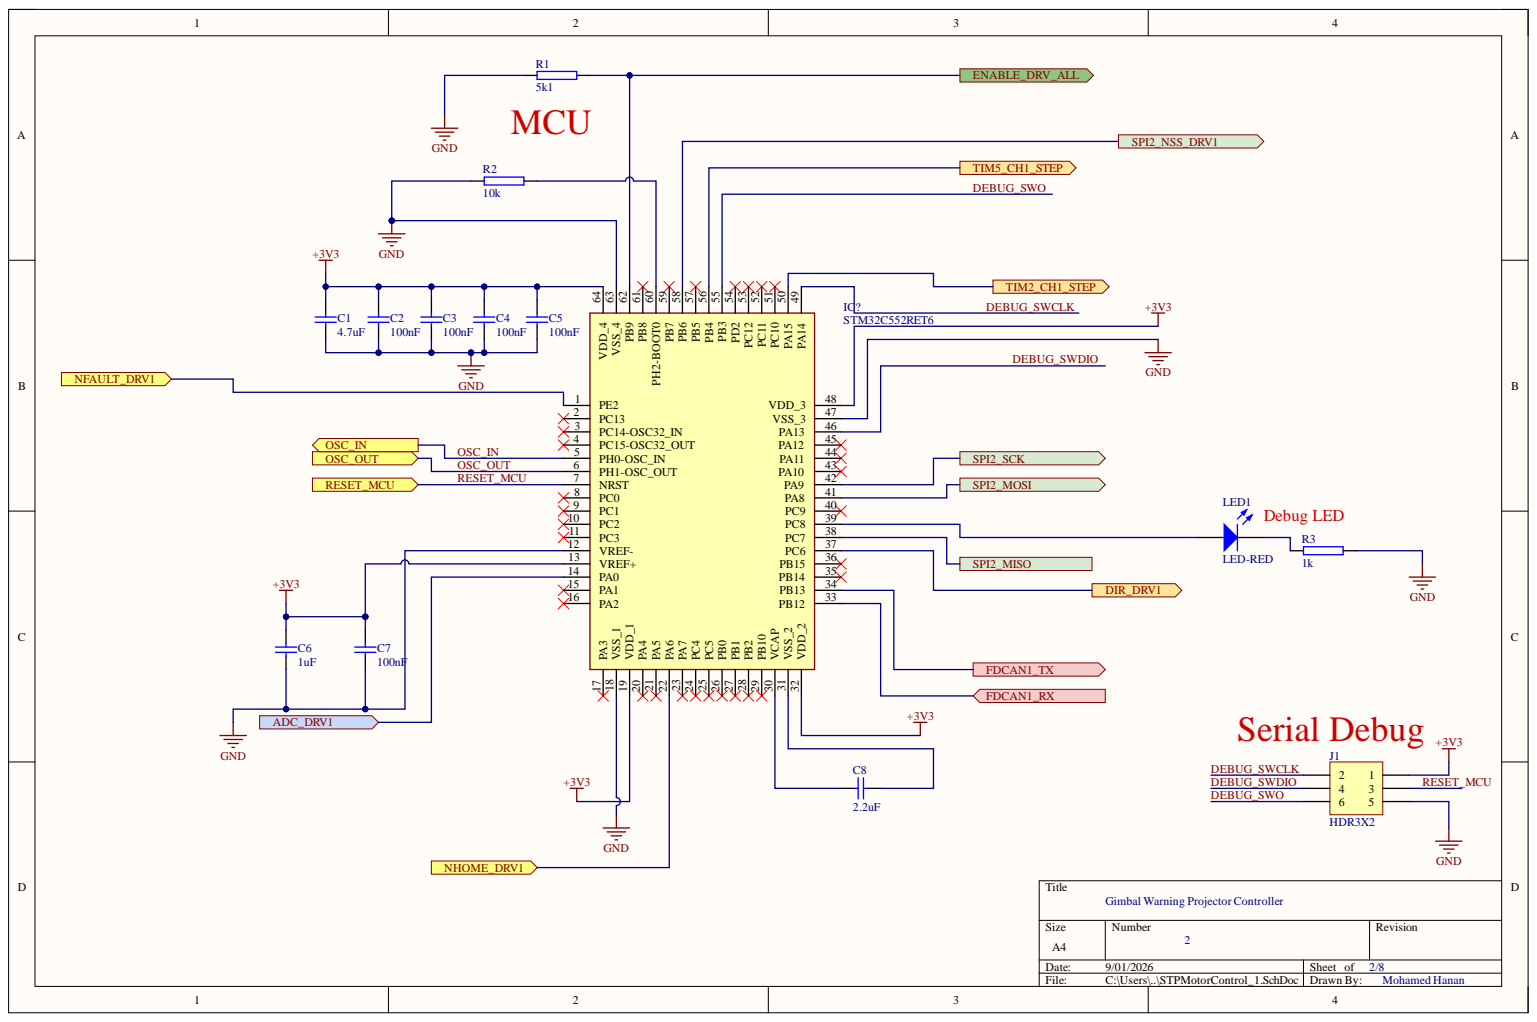
[picture p67: page 2]

OSC_IN | PH0-OSC_IN 5
OSC_OUT | PH1-OSC_OUT 6

Gimbal Warning Projector Controller

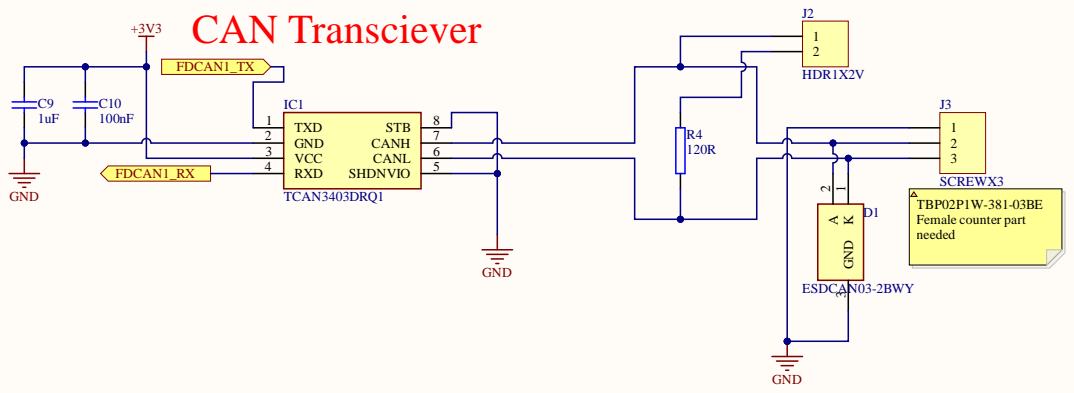
[picture p68: page 3]

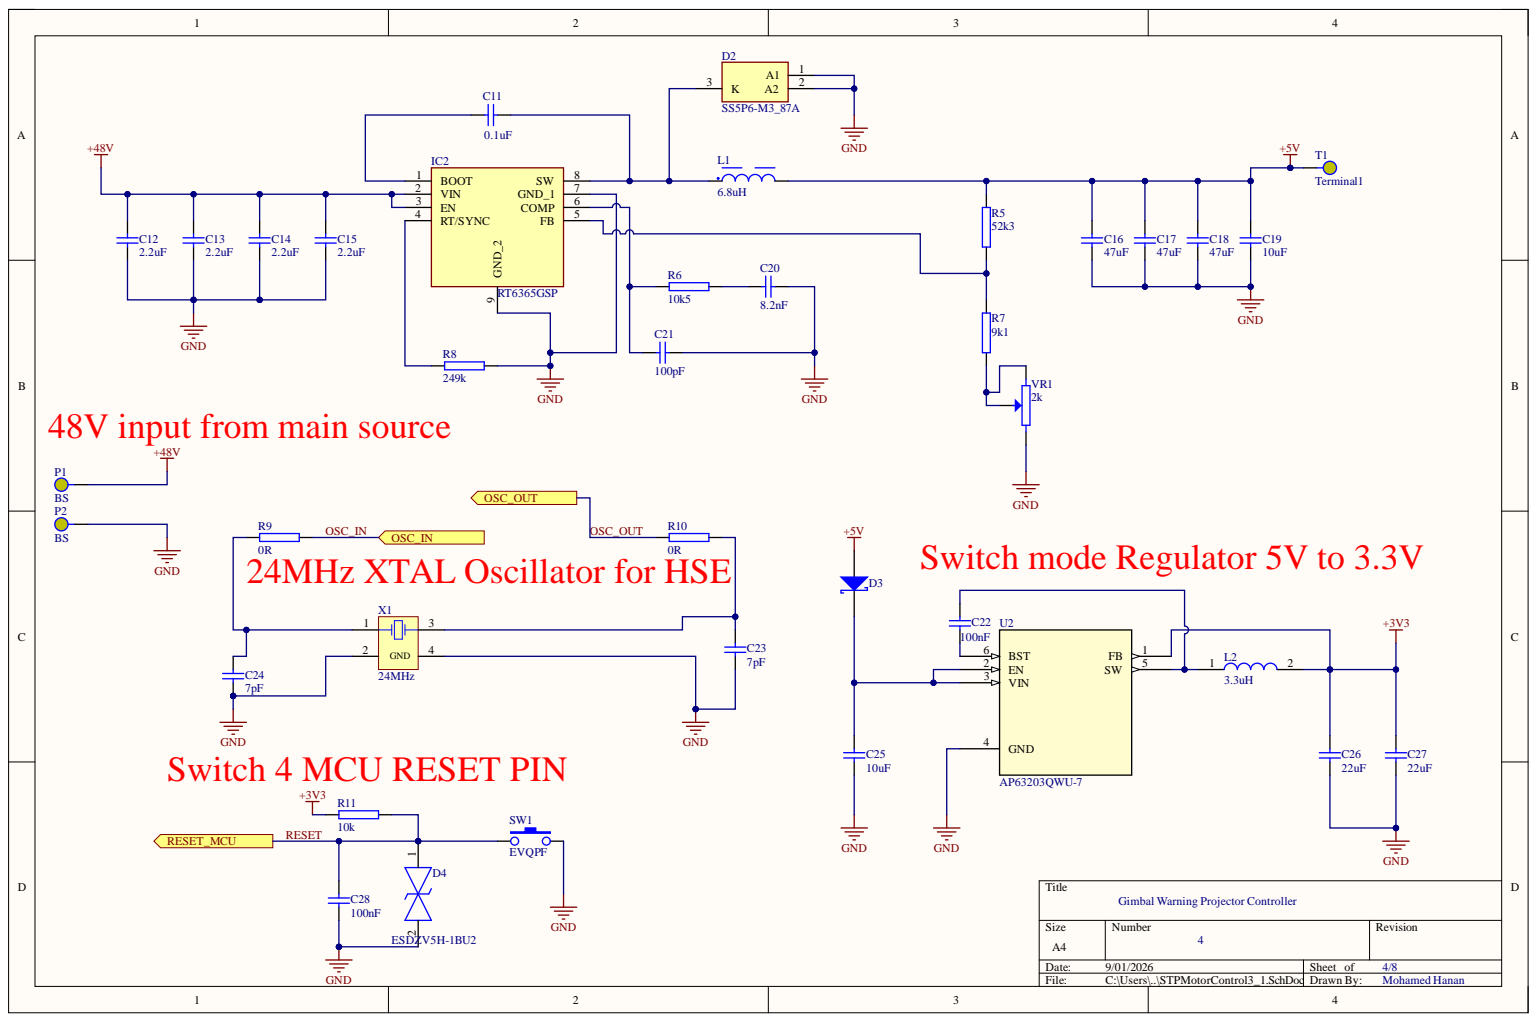
[picture p69: page 4]

48V input from main source

GND
Switch mode Regulator 5V to 3.3V

24MHz XTAL Oscillator for HSE

Switch 4 MCU RESET PIN

Gimbal Warning Projector Controller

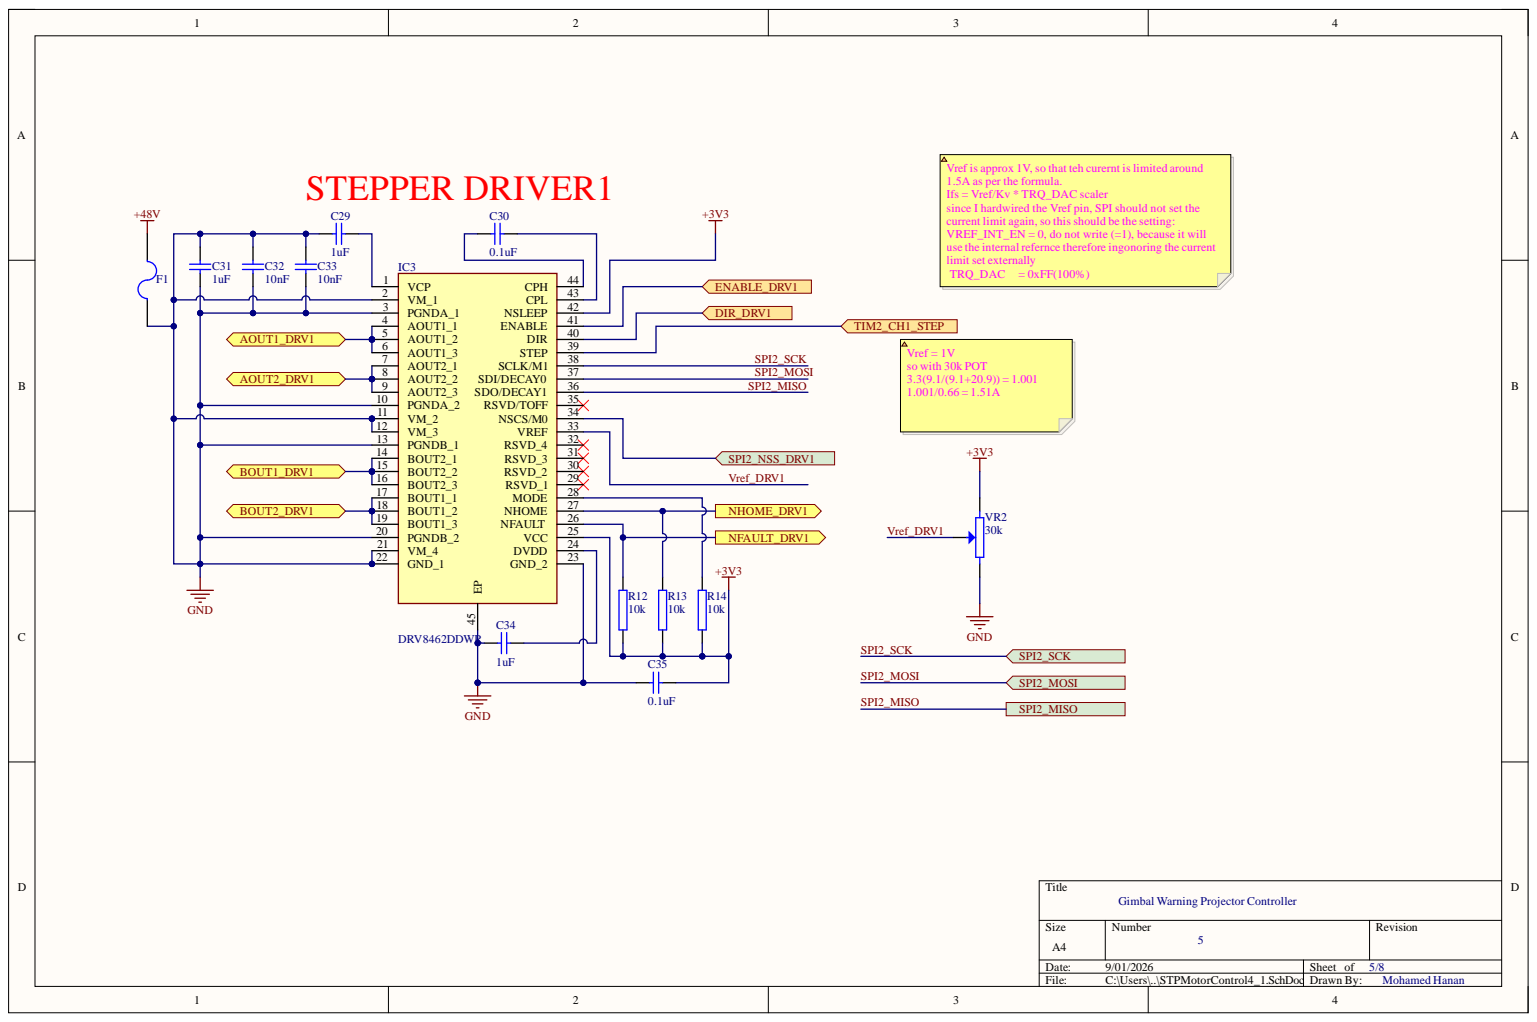
[picture p70: page 5]

Vref is approx 1V, so that teh curernt is limited around
1.5A as per the formula.
Ifs = Vref/Kv * TRQ_DAC scaler
since I hardwired the Vref pin, SPI should not set the
current limit again, so this should be the setting:
VREF_INT_EN = 0, do not write (=1), because it will
use the internal refernce therefore ingonoring the current
limit set externally

VCP 1

Gimbal Warning Projector Controller

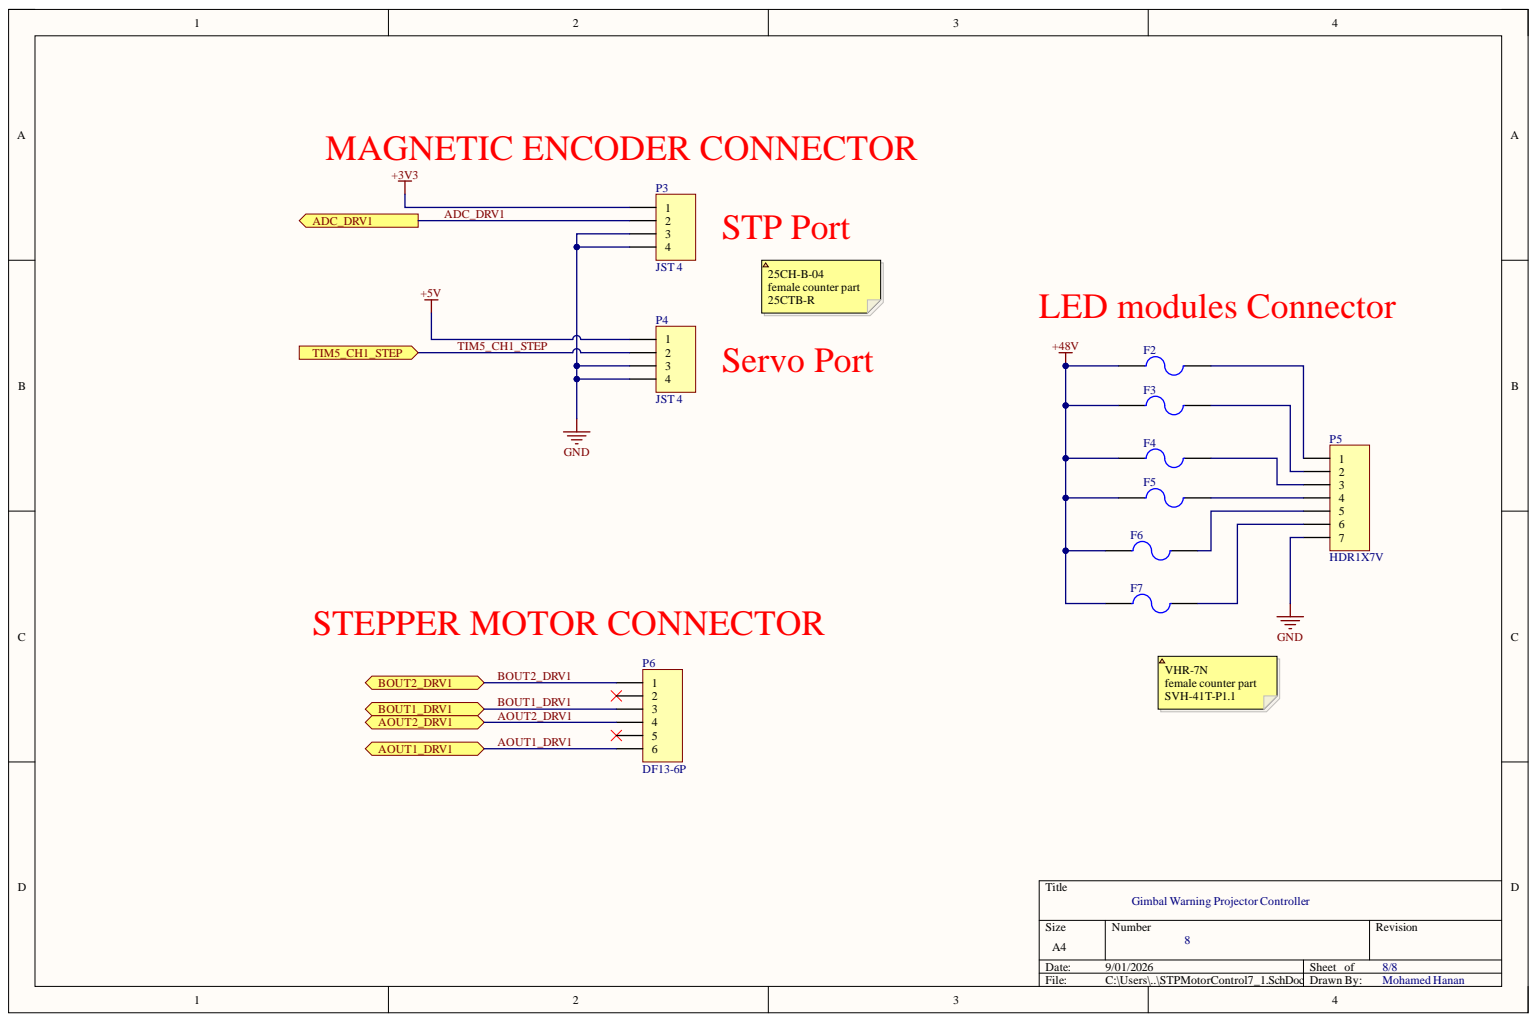
[picture p71: page 6]

Gimbal Warning Projector Controller
