mohanan02/Controller-Design-for-an-Autonomous-Vehicle-Hazard-Warning-and-Intent-Projection-System/(1)Final_Updated_SCHEMATICS/MainController.pdf

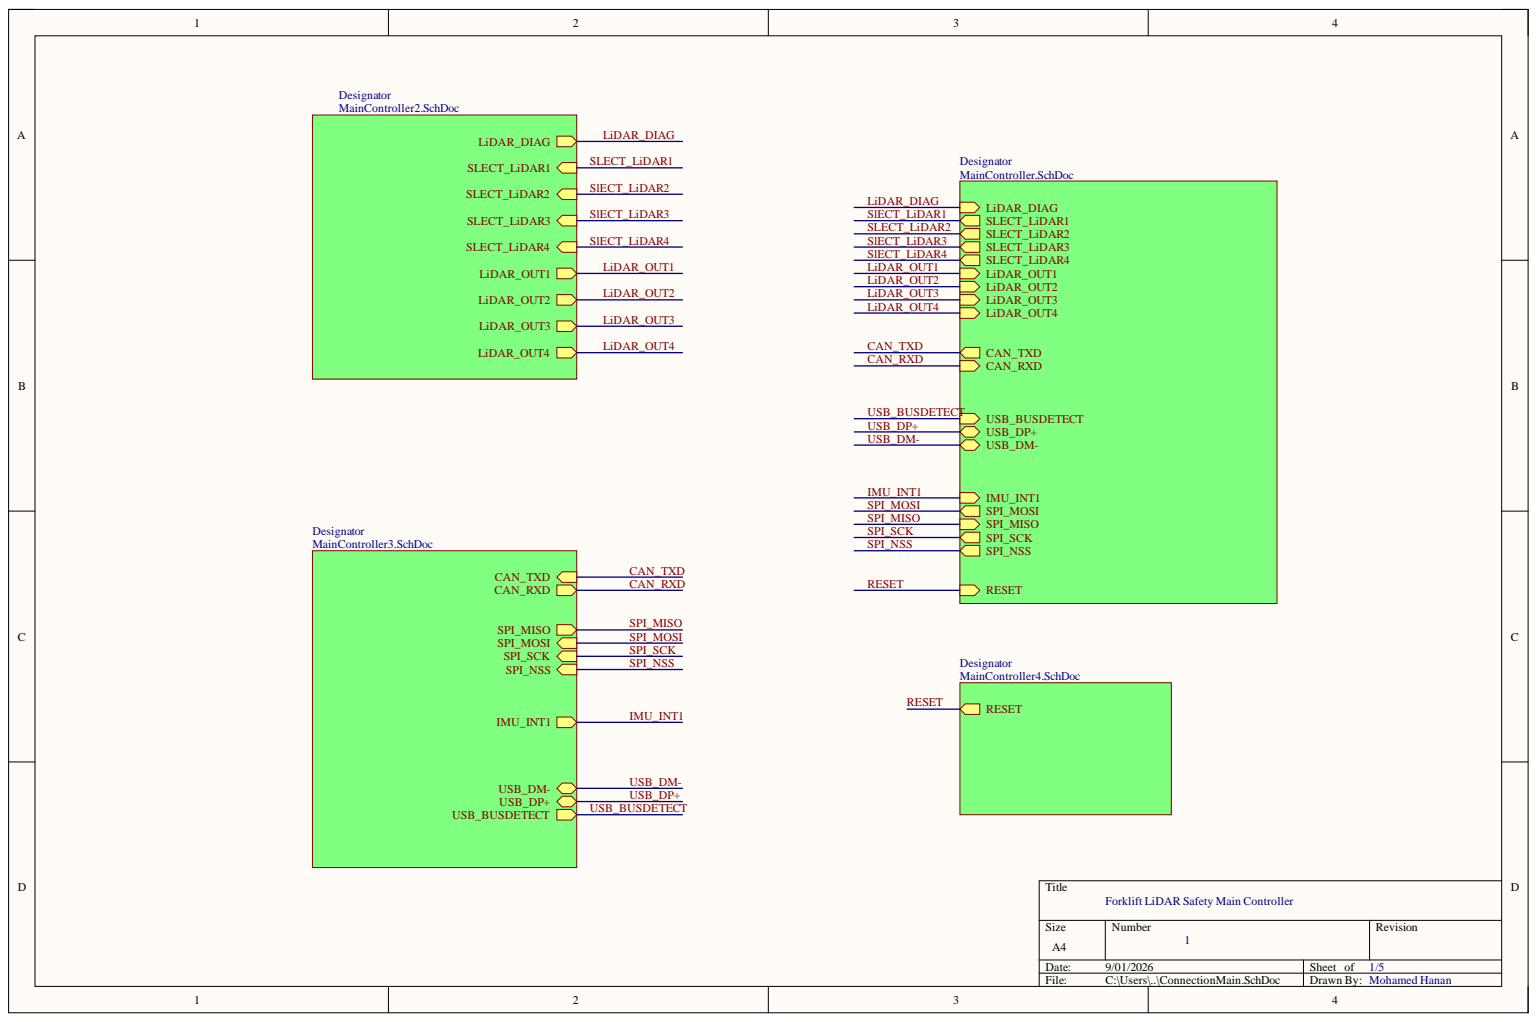
[picture p72: page 1]

Forklift LiDAR Safety Main Controller

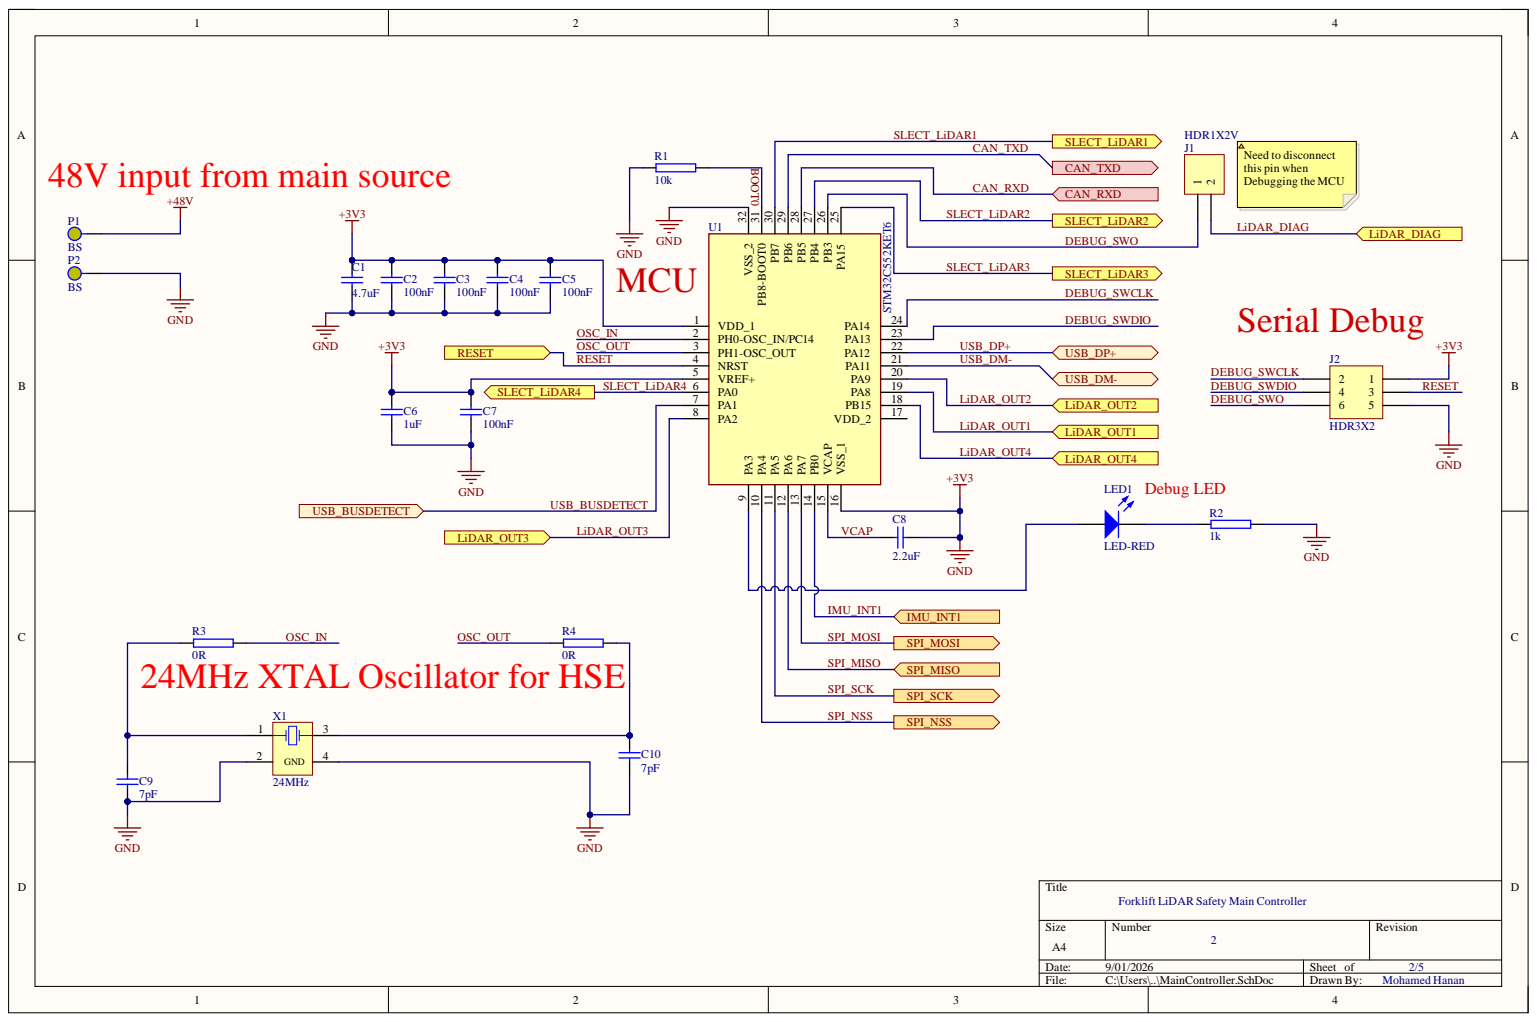
[picture p73: page 2]

48V input from main source

USB_BUSDETECT
LiDAR_OUT3 | | C8

VCAP

24MHz XTAL Oscillator for HSE

Forklift LiDAR Safety Main Controller

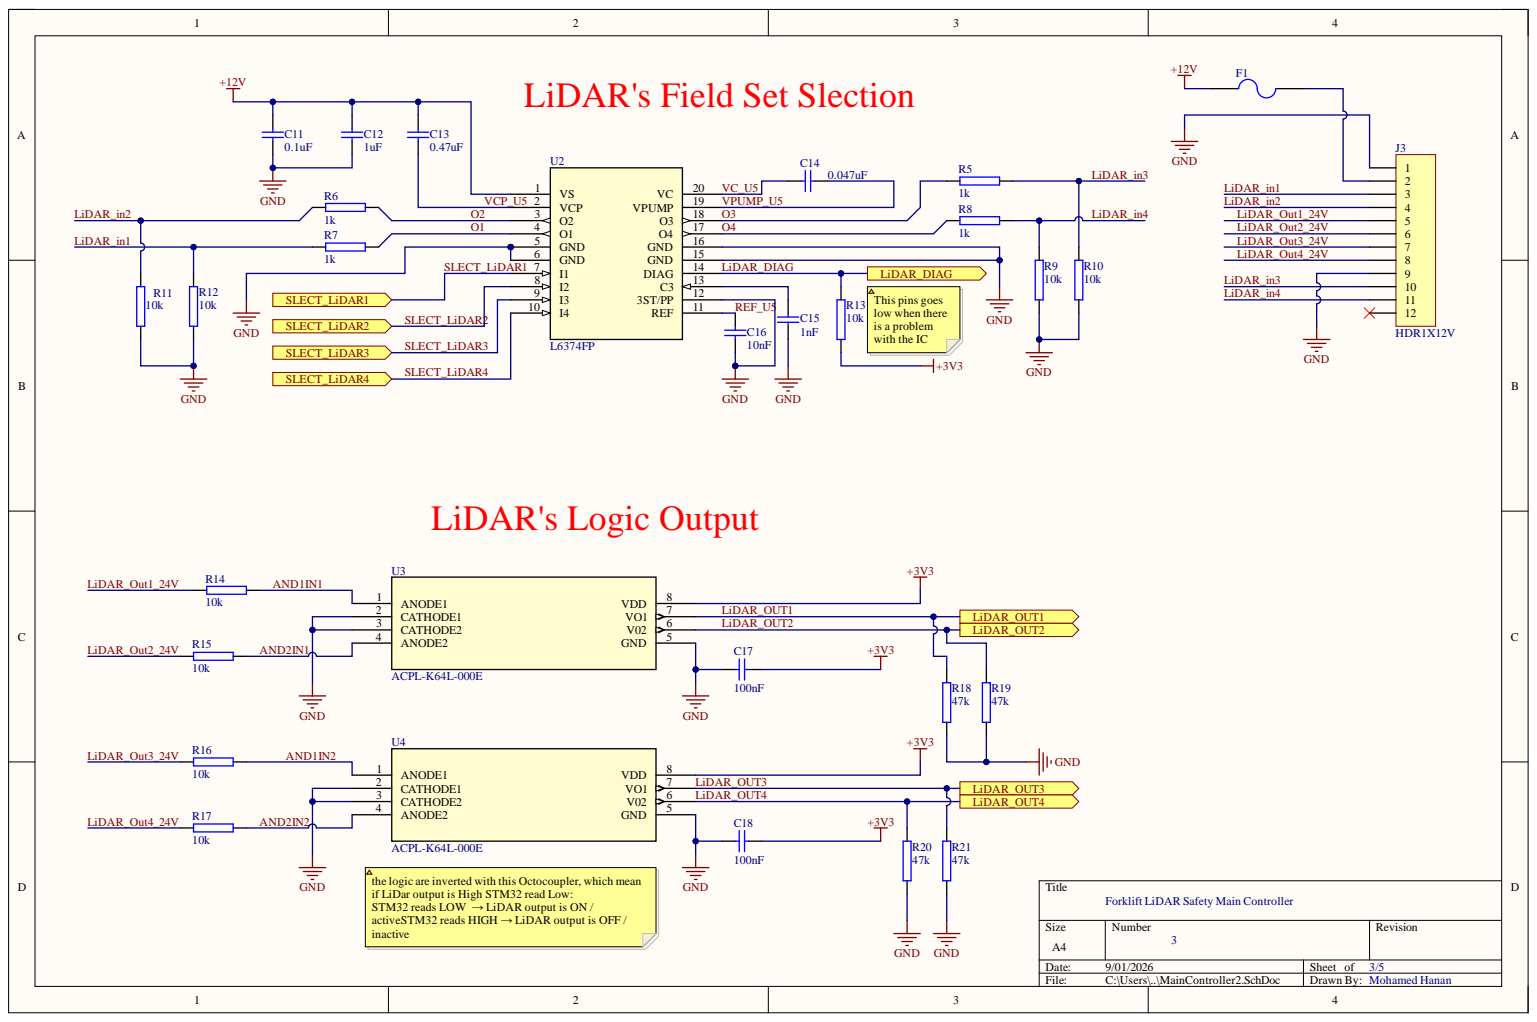
[picture p74: page 3]

LiDAR's Field Set Slection

VCP 2 | VPUMP_U5

I1 7 | | LiDAR_DIAG
I2 8
I3 9

REF_U5

SLECT_LiDAR2

CATHODE1 2
CATHODE2 3 | LiDAR_OUT2

CATHODE2 3 | LiDAR_OUT4

the logic are inverted with this Octocoupler, which mean
if LiDar output is High STM32 read Low:
STM32 reads LOW → LiDAR output is ON /
activeSTM32 reads HIGH → LiDAR output is OFF /
inactive

Forklift LiDAR Safety Main Controller

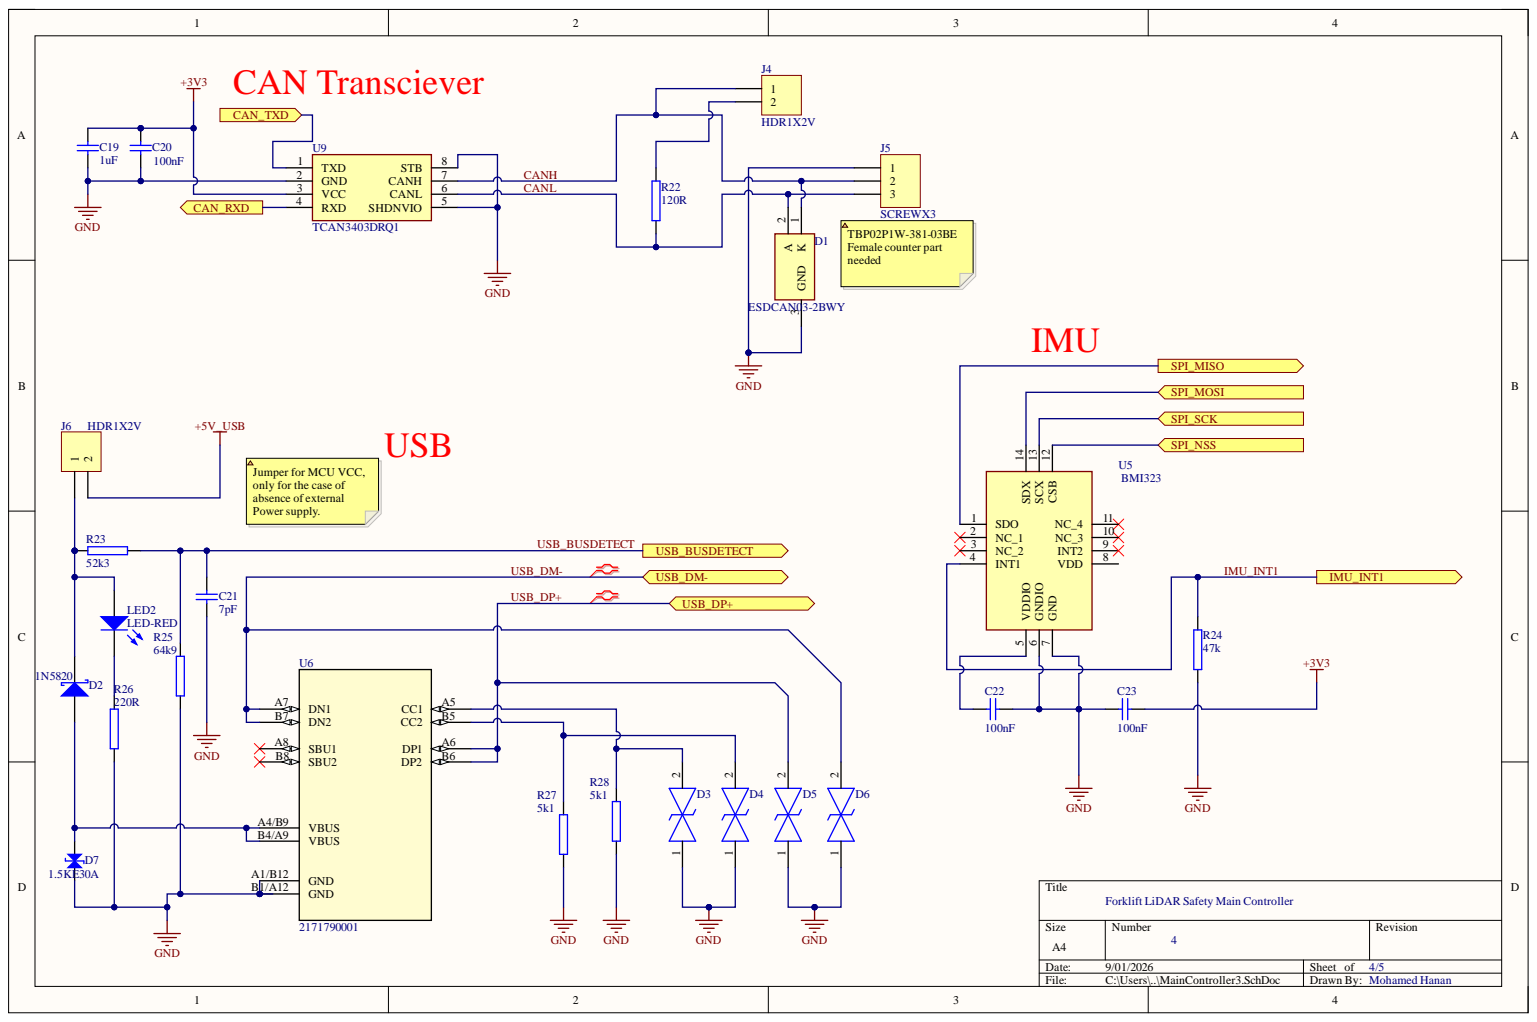
[picture p75: page 4]

Jumper for MCU VCC,
only for the case of
absence of external
Power supply.

Forklift LiDAR Safety Main Controller

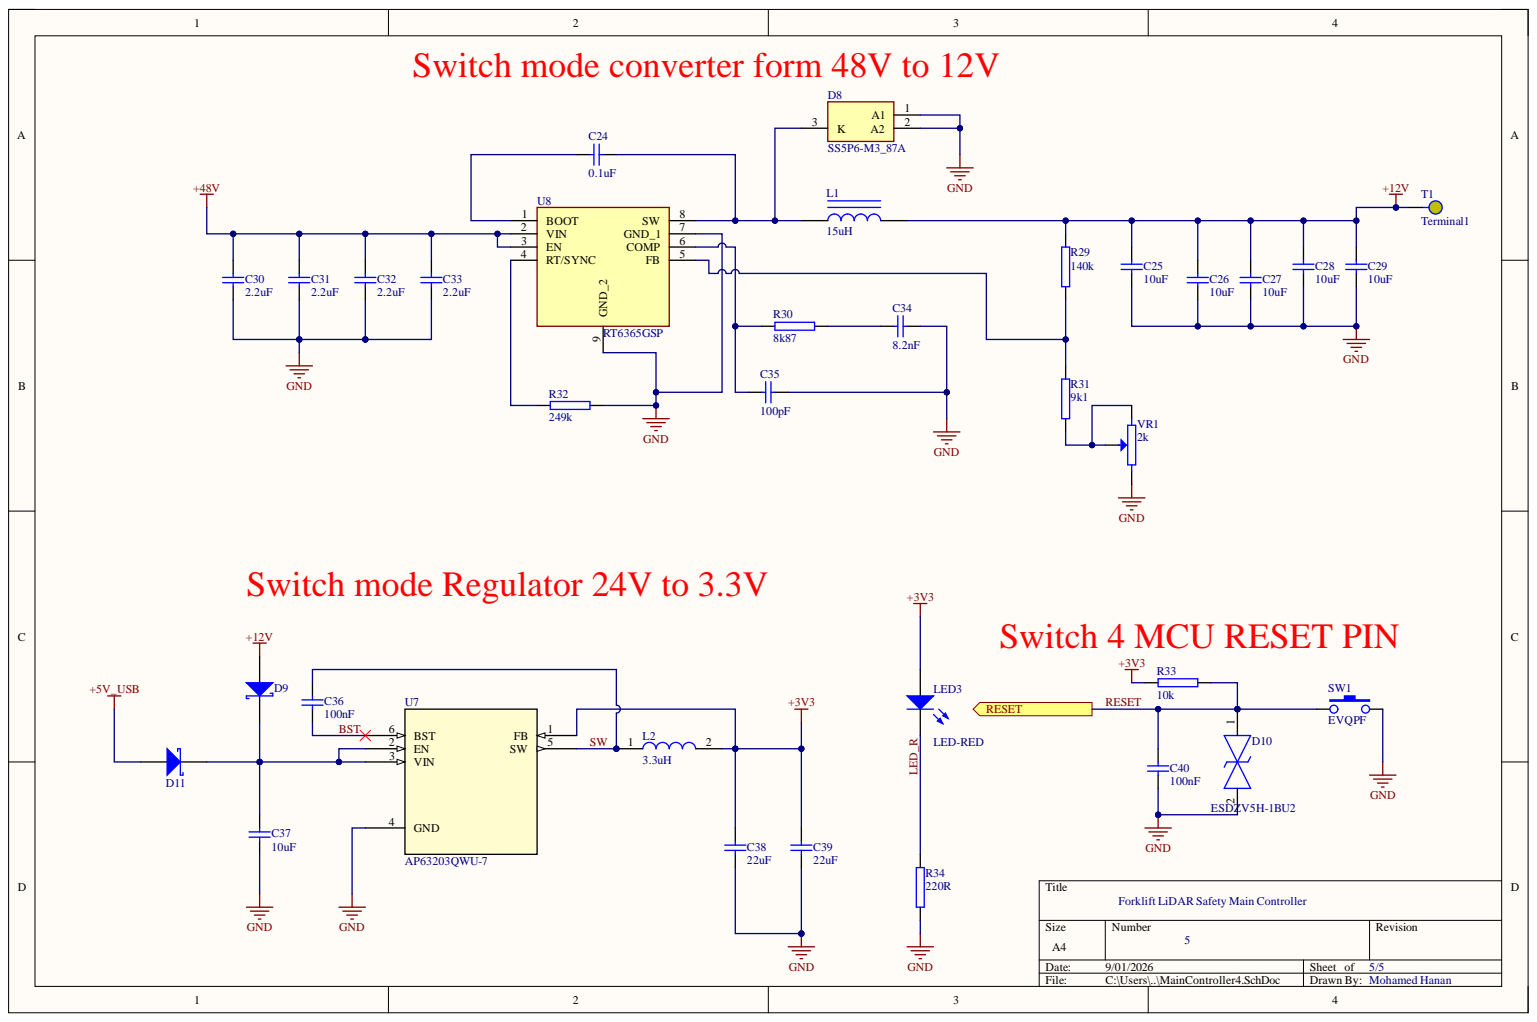
[picture p76: page 5]

Switch mode converter form 48V to 12V

RT6365GSP

Switch mode Regulator 24V to 3.3V

Switch 4 MCU RESET PIN

GND 4

Forklift LiDAR Safety Main Controller
