mohanan02/Controller-Design-for-an-Autonomous-Vehicle-Hazard-Warning-and-Intent-Projection-System/(list of files, drawings)

Other design files:
FrontMountController_Unsimplified/STPMotorConnections.SchDoc
FrontMountController_Unsimplified/STPMotorControl2_1.SchDoc
FrontMountController_Unsimplified/STPMotorControl4_1.SchDoc
FrontMountController_Unsimplified/STPMotorControl5_1.SchDoc
FrontMountController_Unsimplified/STPMotorControl6_1.SchDoc
FrontMountController_Unsimplified/STPMotorControl7_1.SchDoc
FrontMountController_Unsimplified/STPMotorControl_1.PcbDoc
FrontMountController_Unsimplified/STPMotorControl_1.PcbLib
FrontMountController_Unsimplified/STPMotorControl_1.PrjPcb
FrontMountController_Unsimplified/STPMotorControl_1.SchDoc
FrontMountController_Unsimplified/STPMotorControl_1.SchLib
Frount_Mount_Controller_simplified/FrontMountCOntrol.PrjPcb
Frount_Mount_Controller_simplified/STPMotorConnections.SchDoc
Frount_Mount_Controller_simplified/STPMotorControl2_1.SchDoc
Frount_Mount_Controller_simplified/STPMotorControl3_1.SchDoc
Frount_Mount_Controller_simplified/STPMotorControl4_1.SchDoc
Frount_Mount_Controller_simplified/STPMotorControl7_1.SchDoc
Frount_Mount_Controller_simplified/STPMotorControl_1.PcbDoc
Frount_Mount_Controller_simplified/STPMotorControl_1.SchDoc
GimbalController/GimbalController.PrjPcb
GimbalController/STPMotorConnections.SchDoc
GimbalController/STPMotorControl2_1.SchDoc
GimbalController/STPMotorControl3_1.SchDoc
GimbalController/STPMotorControl4_1.SchDoc
GimbalController/STPMotorControl7_1.SchDoc
GimbalController/STPMotorControl_1.PcbDoc
GimbalController/STPMotorControl_1.PcbLib
GimbalController/STPMotorControl_1.SchDoc
GimbalController/STPMotorControl_1.SchLib
MainController(LidarInterface)/ConnectionMain.SchDoc
MainController(LidarInterface)/ecad_model/CL05A105KO5NNNC(1uf16VCap)/Altium/CAPC1005X55N.PcbLib
MainController(LidarInterface)/ecad_model/CL05A105KO5NNNC(1uf16VCap)/Altium/CL05A105KO5NNNC.SchLib
MainController(LidarInterface)/ecad_model/LIB_STM32C552KET6/STM32C552KET6/Altium/QFP80P900X900X160-32N.PcbLib
MainController(LidarInterface)/ecad_model/LIB_STM32C552KET6/STM32C552KET6/Altium/STM32C552KET6.SchLib
MainController(LidarInterface)/ecad_model/TCAN1044AVDRQ1/Altium/SOIC127P600X175-8N.PcbLib
MainController(LidarInterface)/ecad_model/TCAN1044AVDRQ1/Altium/TCAN1044AVDRQ1.SchLib
MainController(LidarInterface)/MainController2.SchDoc
MainController(LidarInterface)/MainController3.SchDoc
MainController(LidarInterface)/MainController4(1).SchDoc
MainController(LidarInterface)/MainController4.SchDoc
MainController(LidarInterface)/MainController.PcbDoc
MainController(LidarInterface)/MainController.PcbLib
MainController(LidarInterface)/MainController.PrjPcb
MainController(LidarInterface)/MainController.SchDoc
MainController(LidarInterface)/MainController.SchLib
MainController(LidarInterface)/MainController.~(85).SchLib
