mohanan02/Controller-Design-for-an-Autonomous-Vehicle-Hazard-Warning-and-Intent-Projection-System/(commit log)

2026-11-09 picture of prototypes board
2026-11-09 schematic and PCB
2026-11-09 gimbal&LiDAR interface Controller
2026-11-10 Add README images and fix folder guide
    The README pointed at docs/images/, firmware/ and bom/, but those folders
    were never uploaded, so every figure showed as a broken image.
    - Add the 17 figures the README uses under docs/images/
    - Add the encoder ADC test sketch and the prototype BOM it links to
    - Restore the badges and the 3D-render banner at the top
    - Rewrite "Repository structure" and "Hardware files" to match the
    folders actually in this repository
    Claude-Session: https://claude.ai/code/session_014Sm5oKXwbPUkekZyUpXiEd
2026-11-10 Add grouped README badges
    Replace the five badges under the title with three rows:
    - Project at a glance: application, purpose, status, year
    - Technology: MCU, EDA, PCB layers, bus, supply, motor drivers,
    actuators, sensors, test firmware
    - Quick links: schematics, BOM, last commit, repo size
    Each badge links to the matching README section or folder.
    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
